eSpark-Backup/ford-creighton-pcb-design-review/README.md

# FordCreighton-PCBDesignReview

We’re preparing to manufacture a high-temp downhole tool and need an experienced PCB engineer to review our design before production.  
 
Board overview:  
10-layer PCB (polyimide, high-temp)  
TI TMS320F28377S (C2000 series) MCU  
PGA900 AFEs, resolver interface, BLDC motor driver  
Mixed analog/digital, high-reliability application  
 
Files provided:  
Altium project files (.SchDoc, .PcbDoc)  
BOM, Pick & Place, Gerbers  
Design notes  
 
What we need:  
Full design & layout review  
Check for DFM/DFT, thermal performance, signal integrity  
Ensure alignment of BOM, footprints, and manufacturing files  
 
Ideal candidate:  
Expert in Altium Designer  
Experience with TI MCUs, high-reliability hardware, and analog front ends  
Bonus: familiarity with PGA900, resolver systems, or downhole electronics  
   
Timeline: 3-5 days
