eSpark-Backup/ford-creighton-pcb-design-review/Client-Files/DROID ITEMS FOR REVIEW/BackUp/DT10965_MOTOR_CONTROLLER/DT10965_MOTOR_CONTROLLER_BD(1).png

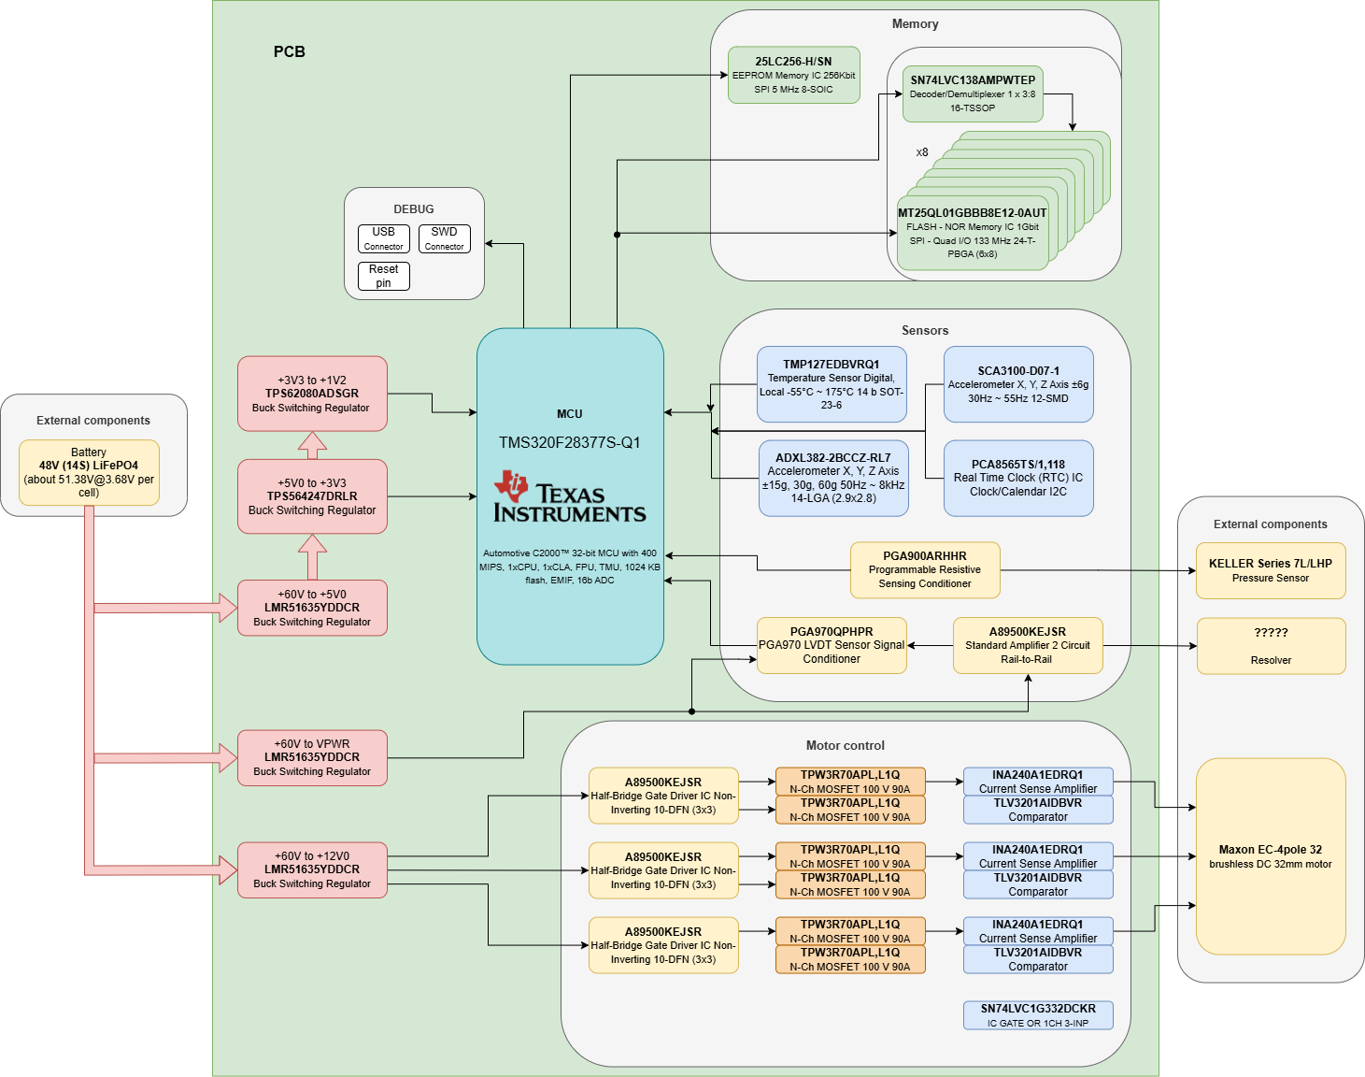
Client-Files/DROID ITEMS FOR REVIEW/BackUp/DT10965_MOTOR_CONTROLLER/DT10965_MOTOR_CONTROLLER_BD(1).png
