eSpark-Backup/ford-creighton-pcb-design-review/Client-Files/DROID ITEMS FOR REVIEW/Altium V1.0/DT10965_MOTOR_CONTROLLER (09.09.2025 11-41-22)/OUTPUTS/BOM/BOM_DT10965.xlsx

Line # | Designator | Description | MPN | Package | Manufacturer | Supplier 1 | Supplier 1 Part Number | Quantity
 | C1, C2 | CAP CER 0402 12PF 50V ULTRA STAB | C0402C120J5HACAUTO | 0402 (1005 Metric) | KEMET |  |  | 2
 | C3, C10, C11, C14, C15, C16, C29, C30, C31, C32, C33, C34, C35, C36, C37, C38, C39, C40, C42, C43, C44, C45, C46, C47, C48, C49, C50, C51, C52, C53, C55, C56, C59, C60, C61, C62, C64, C65, C81, C92, C93, C94, C95, C99, C101, C102, C103, C104, C108, C109, C110, C113, C117, C118, C119, C121, C124, C126, C133, C135, C136, C140, C141, C142, C144, C145, C146, C147, C148, C149, C150, C151, C152, C155, C156, C174, C182, C187, C190, C192, C195, C198, C200, C202, C203, C204, C206, C207, C208, C209, C210, C211, C212, C213, C214, C216, C217, C218, C219, C220, C221, C222, C223, C224, C226, C227, C228, C229, C230, C231, C232, C233, C234, C236, C237, C238, C239, C240, C241 | CAP CER 0.1UF 50V X8L 0402 | GCM155L8EH104KE07D | 0402 (1005 Metric) | Murata Electronics |  |  | 119
 | C4, C5, C6, C7, C96, C100, C105, C111 | CAP CER 2200PF 50V X8R 0402 | CGA2B2X8R1H222K050BA | 0402 (1005 Metric) | TDK Corporation |  |  | 8
 | C8, C9, C12, C13, C17, C18, C19, C20, C21, C22, C23, C24, C25, C41, C188, C189, C199, C201 | CAP CER 2.2UF 6.3V X8L 0603 | C1608X8L0J225K080AC | 0603 (1608 Metric) | TDK Corporation |  |  | 18
 | C26, C27, C28, C58, C154, C181, C191, C193, C194, C196 | CAP CER 10UF 10V X8L 0805 | CGA4J1X8L1A106K125AC | 0805 (2012 Metric) | TDK Corporation |  |  | 10
 | C54, C57, C63, C66, C153 | CAP CER 1UF 16V X8L 0603 | GCG188L8EE105KA07D | 0603 (1608 Metric) | Murata Electronics |  |  | 5
 | C67, C68, C74, C75, C82, C83 | CAP CER 4.7UF 100V X8L 1210 | CL32E475KCIVPJE | 1210 (3225 Metric) | Samsung Electro-Mechanics |  |  | 6
 | C69, C70, C76, C77, C84, C85, C157, C159, C160, C162, C163, C168, C169, C173, C180, C183 | CAP CER 0.1UF 100V X8L 0603 | GCJ188L8EL104KA07D | 0603 (1608 Metric) | Murata Electronics |  |  | 16
 | C71, C72, C78, C79, C86, C87 | CAP CER 0603 100PF 10V ULTRA STA | C0603C101K8HACAUTO | 0603 (1608 Metric) | KEMET |  |  | 6
 | C73, C80, C88 | CAP CER 4.7UF 25V X8L 0805 | CGA4J1X8L1E475K125AC | 0805 (2012 Metric) | TDK Corporation |  |  | 3
 | C89, C90, C97, C106, C116 | CAP CER 0.033UF 50V X8L 0402 | GCM155L8EH333KE07D | 0402 (1005 Metric) | Murata Electronics |  |  | 5
 | C91, C98, C107 | CAP CER 0402 1.5NF 16V ULTRA STA | C0402C152F4HACAUTO | 0402 (1005 Metric) | KEMET |  |  | 3
 | C112, C122, C123, C129, C130, C131, C132, C197, R4, R166, R169, R170, R176, R181, R183, R186, R195, R237, R252, R262, R272 | DNP cap 0402, DNP res 0603 | DNP | 0402 (1005 Metric), 0603 (1608 Metric) |  |  |  | 21
 | C114, C115, C125, C134 | CAP CER 0.47UF 50V X8L 0805 | CGA4J1X8L1H474K125AC | 0805 (2012 Metric) | TDK Corporation |  |  | 4
 | C120, C137 | CAP CER 330PF 16V X8R 0603 | C0603C331J4HACTU | 0603 (1608 Metric) | KEMET |  |  | 2
 | C127, C128, C138, C139 | CAP CER 0.047UF 16V X8R 0402 | CGA2B3X8R1C473K050BB | 0402 (1005 Metric) | TDK Corporation |  |  | 4
 | C143, C205, C215, C225, C235 | CAP CER 0402 560PF 16V ULTRA STA | C0402C561F4HACAUTO | 0402 (1005 Metric) | KEMET |  |  | 5
 | C158, C161, C167, C177, C178, C179, C246, C247, C248, C249 | CAP CER 1UF 100V X8L 1206 | GCJ31CL8EL105KA07L | 1206 (3216 Metric) | Murata Electronics |  |  | 10
 | C164, C165, C166, C170, C171, C172, C175, C176, C184, C185, C186, C250, C251, C252 | CAP CER 22UF 25V X8L 1210 | GCM32EL8EF226KE08L | 1210 (3225 Metric) | Murata Electronics |  |  | 14
 | D1, D2, D3, D4 | DIODE SCHOTTKY 80V 500MA SOD123 | MBR0580S1-7 | SOD-123 | Diodes Incorporated |  |  | 4
 | D5 | DIODE SCHOTTKY 40V 1A DO214AC | SS14-LTP | DO-214AC, SMA | Micro Commercial Co |  |  | 1
 | D6 | TVS DIODE 5.5VWM 12VC SOT363 | D5V0F4U6S-7 | 6-TSSOP, SC-88, SOT-363 | Diodes Incorporated |  |  | 1
 | D7 | DIODE ZENER 10V 300MW SOD323 | MM3Z10VST1G | SC-76, SOD-323 | onsemi |  |  | 1
 | D8 | DIODE ARR SCHOTT 30V TO236AB | BAT54S,215 |  | Nexperia USA Inc. |  |  | 1
 | D9 | LED COOL WHITE DIFFUSED 0402 SMD | APT1608SEC/J3-AMT |  |  |  |  | 1
 | D10 | DIODE ARRAY SCHOTTKY 30V SOT23-3 | BAT54CTA | SOT-23-3 | Diodes Incorporated |  |  | 1
 | FB1, FB2, FB3, FB4, FB5, FB6, FB7, FB8, FB9, FB10, FB11, FB12, FB13, FB14, FB15, FB16, FB17, FB18, FB19 | FERRITE BEAD 220 OHM 0603 1LN | BLM18KG221BH1D | 0603 (1608 Metric) | Murata Electronics |  |  | 19
 | J2, J3, J4, J5, J6, J7 | Connector Header Through Hole 4 position 0.050" (1.27mm) | PR20B04VBNN |  | METZ CONNECT USA Inc. |  |  | 6
 | L1 | CMC 330MA 2LN 90OHM SMD AEC-Q200 | AWCU00201212900M02 |  | Pulse Electronics |  |  | 1
 | L2 | FIXED IND 22UH 1.2A 500 MOHM SMD | SRP4020TA-220M | 2-SMD | Bourns Inc. |  |  | 1
 | L3 | FIXED IND 18UH 1.7A 160 MOHM SMD | SRR4828A-180M |  | Bourns Inc. |  |  | 1
 | L4 | FIXED IND 8.2UH 2A 180 MOHM SMD | SRP4020TA-8R2M | 2-SMD | Bourns Inc. |  |  | 1
 | L5 | FIXED IND 1.5UH 2.3A 74 MOHM SMD | DFE2HCAH1R5MJ0L |  | Murata Electronics |  |  | 1
 | L6 | FIXED IND 1UH 3A 50 MOHM SMD | DFE2HCAH1R0MJ0L | 1008 (2520 Metric) | Murata Electronics |  |  | 1
 | Q1, Q2, Q3, Q4, Q5, Q6 | PB-F POWER MOSFET TRANSISTOR DSO | TPW3R70APL,L1Q |  | Toshiba Semiconductor and Storage |  |  | 6
 | Q7 | MOSFET N-CH 240V 350MA SOT223-4 | BSP129H6327XTSA1 |  | Infineon Technologies |  |  | 1
 | Q8 | MOSFETs P-CHANNEL 80-V (D-S) 175C MOSFET | SQJ185ELP-T1_GE3 |  | Vishay Siliconix |  |  | 1
 | R1, R3, R18, R19, R20, R21, R22, R23, R34, R35, R37, R38, R39, R40, R50, R51, R52, R53, R54, R55, R64, R65, R66, R67, R68, R69, R84, R85, R86, R87, R92, R93, R94, R99, R100, R101, R102, R107, R108, R109, R110, R114, R115, R117, R119, R120, R122, R124, R125, R127, R146, R152, R159, R171, R172, R173, R174, R189, R191, R193, R194, R199, R200, R202, R203, R208, R216, R231, R233, R235, R236, R241, R246, R248, R250, R251, R256, R258, R260, R261, R266, R268, R270, R271, R275, R277, R292, R293, R294 | RES 22 OHM 1% 1/16W 0402 | RC0402FR-0722RL | 0402 (1005 Metric) | YAGEO |  |  | 89
 | R2 | RES 1M OHM 1% 1/16W 0402 | RC0402FR-071ML | 0402 (1005 Metric) | YAGEO |  |  | 1
 | R5, R71, R72, R73, R74, R78, R89, R145, R151, R158, R180, R182, R190, R192, R232, R234, R247, R249, R257, R259, R267, R269 | RES 10K OHM 1% 1/16W 0402 | RC0402FR-0710KL | 0402 (1005 Metric) | YAGEO |  |  | 22
 | R6, R7, R8, R9, R207, R210 | RES SMD 0 OHM JUMPER 1/16W 0402 | RC0402FR-070RL | 0402 (1005 Metric) | YAGEO |  |  | 6
 | R10, R11, R12, R13, R14, R15, R16, R17, R24, R25, R26, R27, R28, R29, R30, R31, R32, R33, R36, R41, R42, R43, R44, R45, R46, R47, R48, R49, R56, R57, R58, R59, R60, R61, R62, R63, R79, R80, R81, R82, R83, R88, R90, R91, R96, R97, R98, R103, R105, R106, R111, R112, R168, R188, R198, R230, R245, R255, R265 | RES 47.5K OHM 1% 1/16W 0402 | RC0402FR-0747K5L | 0402 (1005 Metric) | YAGEO |  |  | 59
 | R70, R75, R76, R77, R116, R118, R121, R123, R126, R128, R134, R135, R136, R143, R144, R147, R154, R155, R157, R160, R163, R175, R187, R201, R229, R239, R240, R242, R244, R254, R264, R286, R287, R288, R290 | RES 0 OHM JUMPER 1/10W 0603 | RC0603FR-070RL | 0603 (1608 Metric) | YAGEO |  |  | 35
 | R95 | RES 5.1 OHM 1% 1/16W 0402 | RC0402FR-075R1L | 0402 (1005 Metric) | YAGEO |  |  | 1
 | R129, R139, R149 | RES 0.02 OHM 1% 3W 2512 | CRA2512-FZ-R020ELF | 2512 (6332 Metric) | Bourns Inc. |  |  | 3
 | R130, R131, R140, R150, R206, R209, R212, R213, R219, R223, R227 | RES 100K OHM 1% 1/16W 0402 | RC0402FR-07100KL | 0402 (1005 Metric) | YAGEO |  |  | 11
 | R132, R133, R142, R153 | RES 4.22K OHM 1% 1/16W 0402 | RC0402FR-074K22L | 0402 (1005 Metric) | YAGEO |  |  | 4
 | R137 | RES 54.9K OHM 1% 1/16W 0402 | RC0402FR-0754K9L | 0402 (1005 Metric) | YAGEO |  |  | 1
 | R138 | RES 274K OHM 1% 1/16W 0402 | RC0402FR-07274KL | 0402 (1005 Metric) | YAGEO |  |  | 1
 | R141, R148, R156 | RES 332K OHM 1% 1/16W 0402 | RC0402FR-07332KL | 0402 (1005 Metric) | YAGEO |  |  | 3
 | R161, R167 | RES 510K OHM 1% 1/16W 0402 | RC0402FR-07510KL | 0402 (1005 Metric) | YAGEO |  |  | 2
 | R162, R164 | RES 31.6K OHM 1% 1/16W 0402 | RC0402FR-0731K6L | 0402 (1005 Metric) | YAGEO |  |  | 2
 | R165, R196, R205, R238, R253, R263, R273, R291 | RES 110 OHM 1% 1/16W 0402 | RC0402FR-07110RL | 0402 (1005 Metric) | YAGEO |  |  | 8
 | R177, R179, R184, R185 | RES 43K OHM 1% 1/16W 0402 | RC0402FR-0743KL | 0402 (1005 Metric) | YAGEO |  |  | 4
 | R204 | RES 49.9K OHM 1% 1/16W 0402 | RC0402FR-0749K9L | 0402 (1005 Metric) | YAGEO |  |  | 1
 | R214 | RES SMD 5.62K OHM 1% 1/10W 0402 | ERJ-2RKF5621X | 0402 (1005 Metric) | Panasonic Electronic Components |  |  | 1
 | R215 | RES SMD 7.15K OHM 1% 1/10W 0402 | ERJ-2RKF7151X | 0402 (1005 Metric) | Panasonic Electronic Components |  |  | 1
 | R218 | RES 135K OHM 1% 1/16W 0402 | RN73H1ETTP1353F50 | 0402 (1005 Metric) | KOA Speer Electronics, Inc. |  |  | 1
 | R220 | RES 30K OHM 1% 1/16W 0402 | RC0402FR-0730KL | 0402 (1005 Metric) | YAGEO |  |  | 1
 | R221 | RES 1.91K OHM 1% 1/16W 0402 | RC0402FR-071K91L | 0402 (1005 Metric) | YAGEO |  |  | 1
 | R222 | RES 178K OHM 1% 1/16W 0402 | RC0402FR-07178KL | 0402 (1005 Metric) | YAGEO |  |  | 1
 | R224, R228 | RES 56 OHM 1% 1/16W 0402 | RC0402FR-0756RL | 0402 (1005 Metric) | YAGEO |  |  | 2
 | R225 | RES 39.2K OHM 1% 1/16W 0402 | RMCF0402FT39K2 | 0402 (1005 Metric) | Stackpole Electronics Inc |  |  | 1
 | R226 | RES 64.9K OHM 1% 1/16W 0402 | RC0402FR-0764K9L | 0402 (1005 Metric) | YAGEO |  |  | 1
 | U1 | IC MCU 32BIT 1MB FLASH 100HTQFP | TMS320F28377SPZPQ |  | Texas Instruments |  |  | 1
 | U2, U3, U4, U5, U7, U8, U9, U10 | IC FLASH 1GBIT SPI 24TPBGA | MT25QL01GBBB8E12-0AUT |  | Micron Technology Inc. |  |  | 8
 | U6 | IC DECODER/DEMUX 1X3:8 16-TSSOP | SN74LVC138AMPWTEP |  | Texas Instruments |  |  | 1
 | U11 | IC EEPROM 256KBIT SPI 5MHZ 8SOIC | 25LC256-H/SN |  | Microchip Technology |  |  | 1
 | U12 | AUTOMOTIVE 0.8C SPI TEMPERATURE | TMP127EDBVRQ1 |  | Texas Instruments |  |  | 1
 | U13 | ACCELEROMETER 6G SPI 12SMD | SCA3100-D07-1 |  | Murata Electronics |  |  | 1
 | U14 | Accelerometer X, Y, Z Axis ±15g, 30g, 60g 50Hz ~ 8kHz 14-LGA (2.9x2.8) | ADXL382-2BCCZ-RL7 |  | Analog Devices Inc. |  |  | 1
 | U15, U16, U18 | IC GATE DRVR HALF-BRIDGE 10DFN | A89500KEJSR |  | Allegro MicroSystems |  |  | 3
 | U17 | IC GATE NOR 1CH 2-INP SC70-5 | SN74LVC1G02DCKR |  | Texas Instruments |  |  | 1
 | U19, U22, U25 | IC CURRENT SENSE 1 CIRCUIT 8SOIC | INA240A1EDRQ1 |  | Texas Instruments |  |  | 3
 | U20 | IC VREF SERIES 0.15% SOT23-3 | REF3333AIDBZR |  | Texas Instruments |  |  | 1
 | U21, U23, U26 | IC COMPARATOR 1 GEN PUR SOT23-5 | TLV3201AIDBVR | SC-74A, SOT-753 | Texas Instruments |  |  | 3
 | U24 | IC GATE OR 1CH 3-INP SC70-6 | SN74LVC1G332DCKR |  | Texas Instruments |  |  | 1
 | U27 | IC OPAMP GP 2 CIRCUIT 14HTSSOP | ALM2403QPWPRQ1 |  | Texas Instruments |  |  | 1
 | U28 | IC SGNL CONDITIONER LVDT 48HTQFP | PGA970QPHPR |  | Texas Instruments |  |  | 1
 | U29, U39, U40, U41, U42 | IC PROG SENSOR SGNL COND 36VQFN | PGA900ARHHR |  | Texas Instruments |  |  | 5
 | U30 | IC RTC CLK/CALENDAR I2C 8TSSOP | PCA8565TS/1,118 |  | NXP USA Inc. |  |  | 1
 | U31, U32, U33 | SIMPLE SWITCHER SYNCHRONOUS BUCK | LMR51635XDDCR |  | Texas Instruments |  |  | 3
 | U34 | IC REG BUCK ADJ 4A SOT563 | TPS564247DRLR |  | Texas Instruments |  |  | 1
 | U35, U38 | CMOS Amplifier 1 Circuit Rail-to-Rail SOT-23-6 | OPA320SAIDBVR |  | Texas Instruments |  |  | 2
 | U36 | IC VREF SERIES SOT23-6 | REF35300QDBVRQ1 |  |  |  |  | 1
 | U37 | IC REG BUCK ADJ 1.2A 8WSON | TPS62080ADSGR |  | Texas Instruments |  |  | 1
 | Y1 | CRYSTAL 20.0000MHZ 8PF SMD | STDCSU2-20M |  | NDK (NIHON DEMPA KOGYO CO., LTD) |  |  | 1
 | Y2 | CRYSTAL 32.7680KHZ 9PF SMD | ABS07AIG-32.768KHZ-9-1-T | 2-SMD, No Lead | Abracon LLC |  |  | 1
