eSpark-Backup/ford-creighton-pcb-design-review/Client-Files/DROID ITEMS FOR REVIEW/Diagrams/PowerCalculation.xlsx

Sheet: Current consumption
LIST | Component | Description | Quantity | Voltage |  | Current (max), mA | Supplied devices current | Common, mA
MCU | TMS320F28377S-Q1 | MCU | 1 | +3V3 | VDDIO | 30 | 0 | 30
MCU | TMS320F28377S-Q1 | MCU | 1 | +3V3 | AVDD | 20 | 0 | 20
MCU | TMS320F28377S-Q1 | MCU | 1 | +3V3 | 3VFL | 40 | 0 | 40
MCU | TMS320F28377S-Q1 | MCU | 1 | +1V2 | VDD | 400 | 0 | 400
Flash | SN74LVC138AMPWTEP | IC DECODER/DEMUX 1X3:8 | 1 | +3V3 |  | 55 | 0 | 55
Flash | MT25QL01GBBB8E12-0AUT | Flash Memory | 8 | +3V3 |  | 1 | 0 | 8
Flash | MT25QL01GBBB8E12-0AUT | Flash Memory | 1 | +3V3 |  | 55 | 0 | 55
EEPROM | 25LC256-H/SN | EEPROM Memory | 1 | +3V3 |  | 5 | 0 | 5
Temp Sensor | TMP127EDBVRQ1 | Temp Sensor | 1 | +3V3 |  | 1 | 0 | 1
Accelerometer | SCA3100-D07-1 | ACCELEROMETER 6G | 1 | +3V3 |  | 5 | 0 | 5
Accelerometer | ADXL382-2BCCZ-RL7 | ACCELEROMETER 60G | 1 | +3V3 |  | 1 | 0 | 1
H-bridge | A89500KEJSR | IC GATE DRVR HALF-BRIDGE | 3 | +3V3 |  | 3 | 0 | 9
H-bridge | A89500KEJSR | IC GATE DRVR HALF-BRIDGE | 3 | +12v |  | 20 | 0 | 60
Phase Current_Voltage Sense | INA240A1EDRQ1 | IC CURRENT SENSE | 3 | +3V3 |  | 3 | 0 | 9
Phase Current_Voltage Sense | REF3333AIDBZR | IC VREF SERIES 0.15% | 1 | +5V0 |  | 35 | 0 | 35
Phase Current_Voltage Sense | TLV3201AIDBVR | IC COMPARATOR | 3 | +3V3 |  | 60 | 0 | 180
Phase Current_Voltage Sense | SN74LVC1G332DCKR | IC GATE OR 1CH 3-INP | 1 | +3V3 |  | 24 | 0 | 24
Resolver | ALM2403QPWPRQ1 | IC OPAMP GP 2 CIRCUIT | 1 | +15V |  | 5.5 | 0 | 5.5
Resolver | PGA970QPHPR | IC SGNL CONDITIONER LVDT | 1 | +15V |  | 12.5 | 0 | 12.5
Pressure_sensor_AFE | PGA900ARHHR | IC PROG SENSOR SGNL COND | 5 | +5V0 |  | 2.6 | 0 | 13
CALENDAR | PCA8565TS/1,118 | IC RTC CLK/CALENDAR | 1 | +3V3 |  | 1 | 0 | 1
 |  |  |  |  |  |  | Voltage | Max. Current consumption
 |  |  |  |  |  |  | +1V2 | up to 400mA
 |  |  |  |  |  |  | +3V3 | up to 650mA
 |  |  |  |  |  |  | +5V0 | up to 50mA
 |  |  |  |  |  |  | +12V | up to 60mA
 |  |  |  |  |  |  | +15V | up to 20mA

Sheet: Аркуш2
LIST | Component | Description | Quantity | Voltage |  | Current (max), mA | Supplied devices current | Common
MCU | TMS320F28377S-Q1 | MCU | 1 | +3V3 | VDDIO | 30 | 0 | 30
MCU | TMS320F28377S-Q1 | MCU | 1 | +3V3 | AVDD | 20 | 0 | 20
MCU | TMS320F28377S-Q1 | MCU | 1 | +3V3 | 3VFL | 40 | 0 | 40
MCU | TMS320F28377S-Q1 | MCU | 1 | +1V2 | VDD | 400 | 0 | 400
Flash | SN74LVC138AMPWTEP | IC DECODER/DEMUX 1X3:8 | 1 | +3V3 |  | 55 | 0 | 55
Flash | MT25QL01GBBB8E12-0AUT | Flash Memory | 8 | +3V3 |  | 1 | 0 | 8
Flash | MT25QL01GBBB8E12-0AUT | Flash Memory | 1 | +3V3 |  | 55 | 0 | 55
EEPROM | 25LC256-H/SN | EEPROM Memory | 1 | +3V3 |  | 5 | 0 | 5
Temp Sensor | TMP127EDBVRQ1 | Temp Sensor | 1 | +3V3 |  | 1 | 0 | 1
Accelerometer | SCA3100-D07-1 | ACCELEROMETER 6G | 1 | +3V3 |  | 5 | 0 | 5
Accelerometer | ADXL382-2BCCZ-RL7 | ACCELEROMETER 60G | 1 | +3V3 |  | 1 | 0 | 1
H-bridge | A89500KEJSR | IC GATE DRVR HALF-BRIDGE | 3 | +3V3 |  | 3 | 0 | 9
Phase Current_Voltage Sense | INA240A1EDRQ1 | IC CURRENT SENSE | 3 | +3V3 |  | 3 | 0 | 9
Phase Current_Voltage Sense | TLV3201AIDBVR | IC COMPARATOR | 3 | +3V3 |  | 60 | 0 | 180
Phase Current_Voltage Sense | SN74LVC1G332DCKR | IC GATE OR 1CH 3-INP | 1 | +3V3 |  | 24 | 0 | 24
CALENDAR | PCA8565TS/1,118 | IC RTC CLK/CALENDAR | 1 | +3V3 |  | 1 | 0 | 1
 |  |  |  |  |  |  |  | 843

Sheet: SPI-Speed
 | Type | IC connection | Maximum SPI Working Frequency | SPI Port# | SPI CS PIN
 | MCU | TMS320F28377S-Q1 | 3 high-speed SPI- UP to 50 MHz | SPI A/B/C | Port Name | I/O
x8 | Flash | MT25QL01GBBB8E12-0AUT | 90/27 (fC/fR)- Clock frequency | SPI C | SPI_C_EN | GPIO72(+73,78,86)
 | EEPROM | 25LC256-H/SN | 3 MHz (at +3,3V) | SPI B | SPI_EEPROM_CS | GPIO2
 | TempSens | TMP127EDBVRQ1 | 10 MHz (Max) | SPI A | SPI_TEMP_\C\S\ | GPIO86
 | Accelerometer | SCA3100-D07-1 | 8 MHz (MAX) | SPI A | SPI_A_EN | GPIO19
x1 | Resolver AFE | PGA970QPHPR | 1 MHz (MAX) | SPI B | PGA970_SPI_CSN | GPIO66
x5 | Pressure sensor AFE1 | PGA900ARHHR | 1 MHz (MAX) | SPI B | PS_EN_1 | GPIO59
 | Pressure sensor AFE2 | PGA900ARHHR | 1 MHz (MAX) | SPI B | PS_EN_2 | GPIO62
 | Pressure sensor AFE3 | PGA900ARHHR | 1 MHz (MAX) | SPI B | PS_EN_3 | GPIO63
 | Pressure sensor AFE4 | PGA900ARHHR | 1 MHz (MAX) | SPI B | PS_EN_4 | GPIO64
 | Pressure sensor AFE5 | PGA900ARHHR | 1 MHz (MAX) | SPI B | PS_EN_5 | GPIO65

Sheet: Connector
Battery connection |  |  |  |  | Motor connection
AWG 20 wires |  |  |  |  | AWG 20 wires
Contact # | Color | Signal | External equipment | PCB connection | Contact # | Color | Signal | External equipment | PCB connection
1 | Black | GND | Battery | X32 | 1 | Black | n.a. | n.a. | n.a
2 | Brown | n.a. | n.a. | n.a. | 2 | Brown | Winding 1 | Motor | X33.
3 | Red | Vin | Battery | X31 | 3 | Red | n.a. | n.a. | n.a.
4 | Orange | n.a. | n.a. | n.a. | 4 | Orange | Winding 2 | Motor | X34
5 | Yellow | n.a. | n.a. | n.a. | 5 | Yellow | Winding 3 | Motor | X35
AWG 26 wires |  |  |  |  | AWG 26 wires
Contact # | Color | Signal | External equipment | PCB connection | Contact # | Color | Signal | External equipment | PCB connection
6 | Black | VBRGP1 | Pressure sensor1 | X11 | 6 | Black | P1OUT | Resolver | X1
7 | Brown | VBRGN1 | Pressure sensor1 | X12 | 7 | Brown | P2OUT | Resolver | X2
8 | Red | VINPP1 | Pressure sensor1 | X13 | 8 | Red | S1P_IN | Resolver | X3
9 | Orange | VINPN1 | Pressure sensor1 | X14 | 9 | Orange | S1N_IN | Resolver | X4
10 | Yellow | VBRGP2 | Pressure sensor2 | X15 | 10 | Yellow | S2P_IN | Resolver | X5
11 | Green | VBRGN2 | Pressure sensor2 | X16 | 11 | Green | S2N_IN | Resolver | X6
12 | Blue | VINPP2 | Pressure sensor2 | X17 | 12 | Blue | n.a. | n.a. | n.a.
13 | Violet | VINPN2 | Pressure sensor2 | X18 | 13 | Violet | n.a. | n.a. | n.a.
14 | Gray | VBRGP3 | Pressure sensor3 | X19 | 14 | Gray | n.a. | n.a. | n.a.
15 | White | VBRGN3 | Pressure sensor3 | X20 | 15 | White | n.a. | n.a. | n.a.
16 | Black | VINPP3 | Pressure sensor3 | X21 | 16 | Black | USB_GND | USB | X10
17 | Brown | VINPN3 | Pressure sensor3 | X22 | 17 | Brown | n.a. | n.a. | n.a.
18 | Red | VBRGP4 | Pressure sensor4 | X23 | 18 | Red | VBUS | USB | X9
19 | Orange | VBRGN4 | Pressure sensor4 | X24 | 19 | Orange | USB_CON_D_P | USB | X7
20 | Yellow | VINPP4 | Pressure sensor4 | X25 | 20 | Yellow | USB_CON_D_N | USB | X8
21 | Green | VINPN4 | Pressure sensor4 | X26 | 21 | Green | n.a. | n.a. | n.a.
22 | Blue | VBRGP5 | Pressure sensor5 | X27 | 22 | Blue | n.a. | n.a. | n.a.
23 | Violet | VBRGN5 | Pressure sensor5 | X28 | 23 | Violet | n.a. | n.a. | n.a.
24 | Gray | VINPP5 | Pressure sensor5 | X29 | 24 | Gray | n.a. | n.a. | n.a.
25 | White | VINPN5 | Pressure sensor5 | X30 | 25 | White | n.a. | n.a. | n.a.
