eSpark-Backup/ford-creighton-pcb-design-review/Client-Files/DROID ITEMS FOR REVIEW/Diagrams/GND__Connection.drawio.pdf

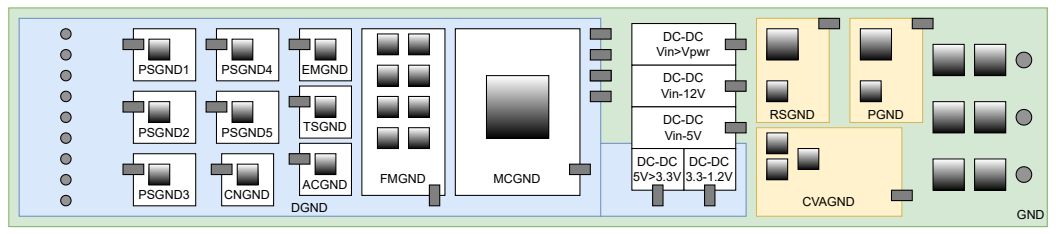
[picture p2: page 1]
GND; PGND; DGND; FMGND; MCGND; EMGND; TSGND; ACGND; CVAGND; PSGND1; PSGND2; PSGND3; PSGND4; PSGND5; CNGND; RSGND

DC-DC Vin>Vpwr

DC-DC Vin-12V

DC-DC Vin-5V
