eSpark-Backup/ford-creighton-pcb-design-review/Client-Files/DROID ITEMS FOR REVIEW/BackUp/DT10965_MOTOR_CONTROLLER/DT10965_MOTOR_CONTROLLER.pdf

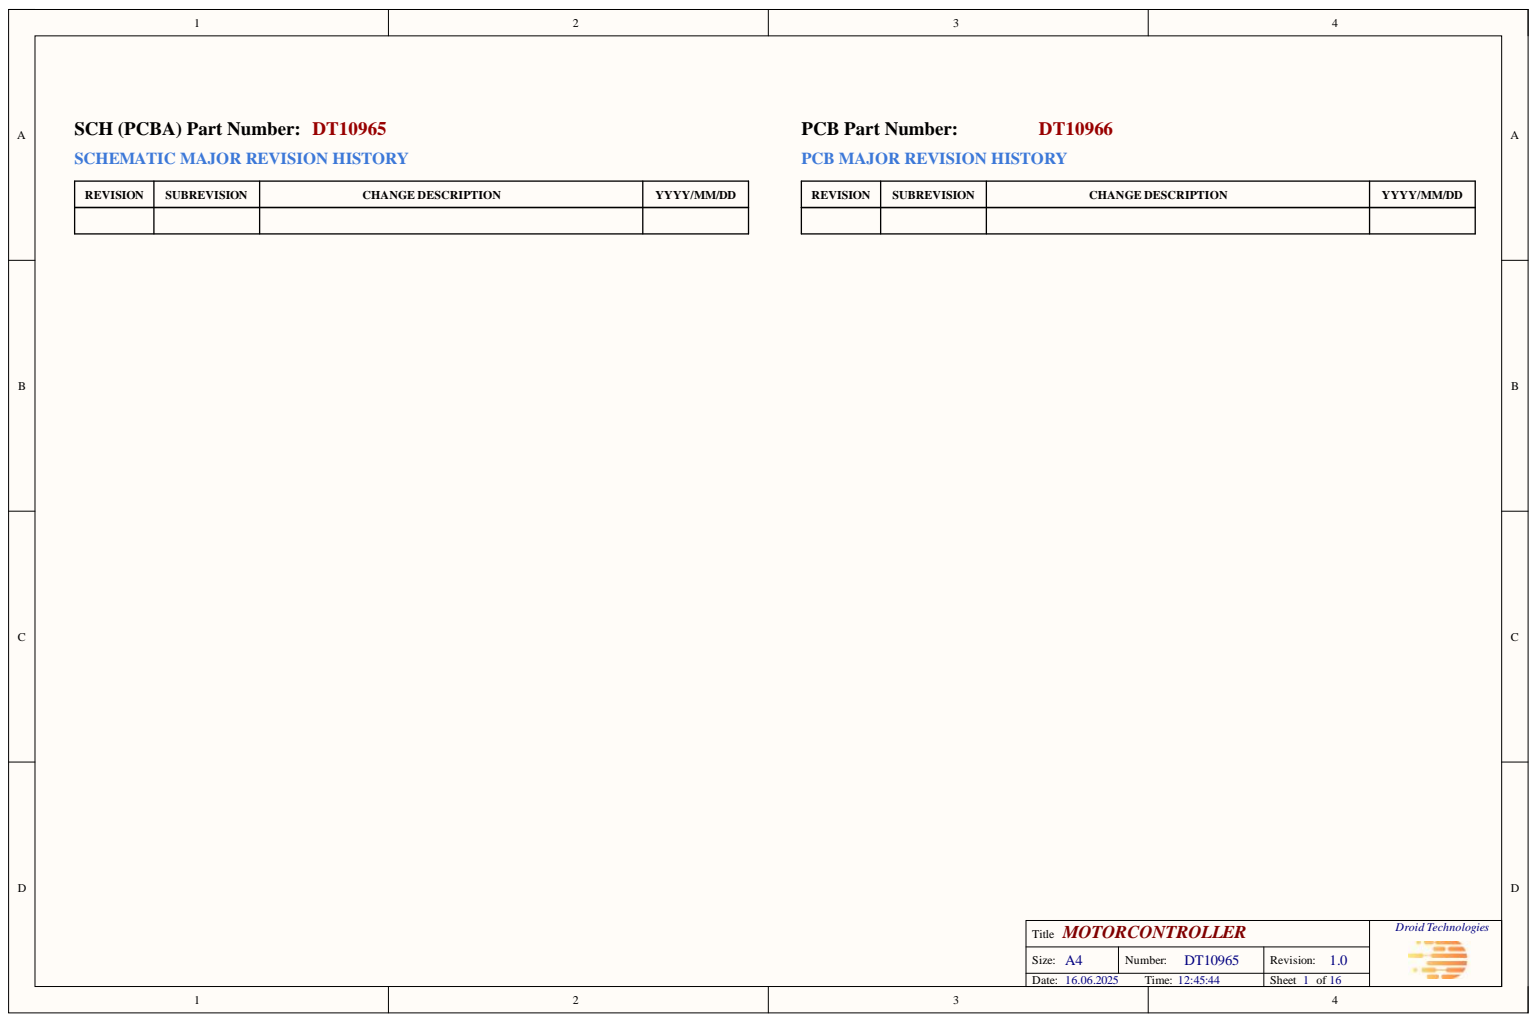
[picture p3: page 1]

MOTORCONTROLLER Title | Droid Technologies

Size: A4 | Number: DT10965 | Revision: 1.0
Date: 16.06.2025 Time: 12:45:44 | | Sheet of

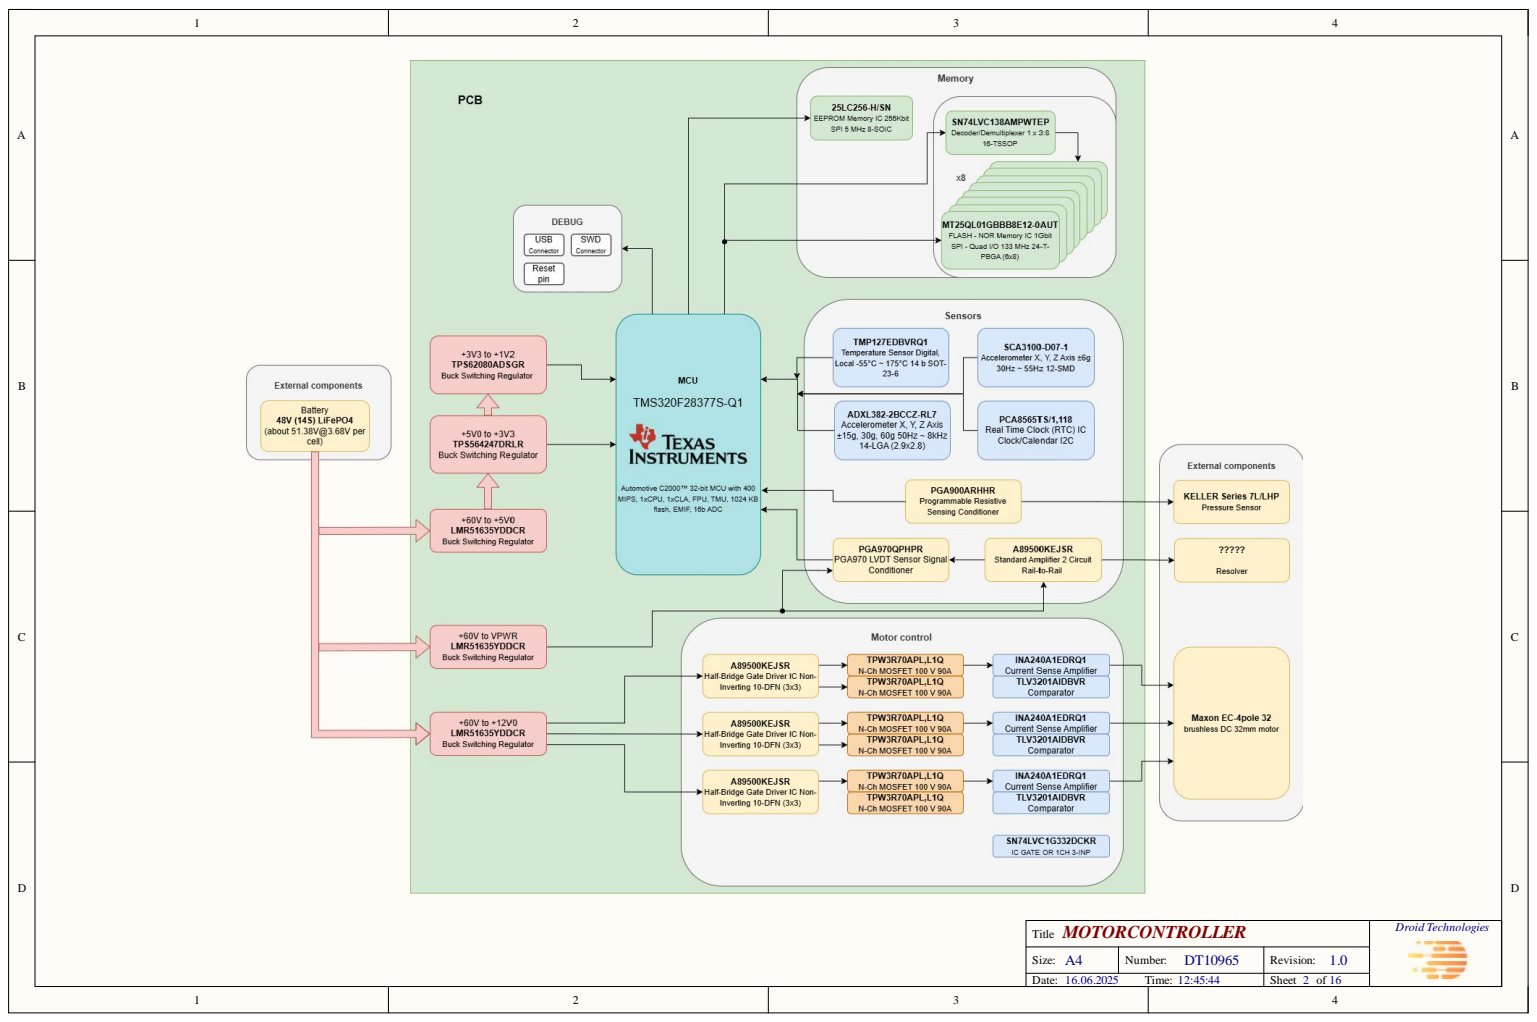
[picture p4: page 2]

MOTORCONTROLLER Title | Droid Technologies

Size: A4 | Number: DT10965 | Revision: 1.0

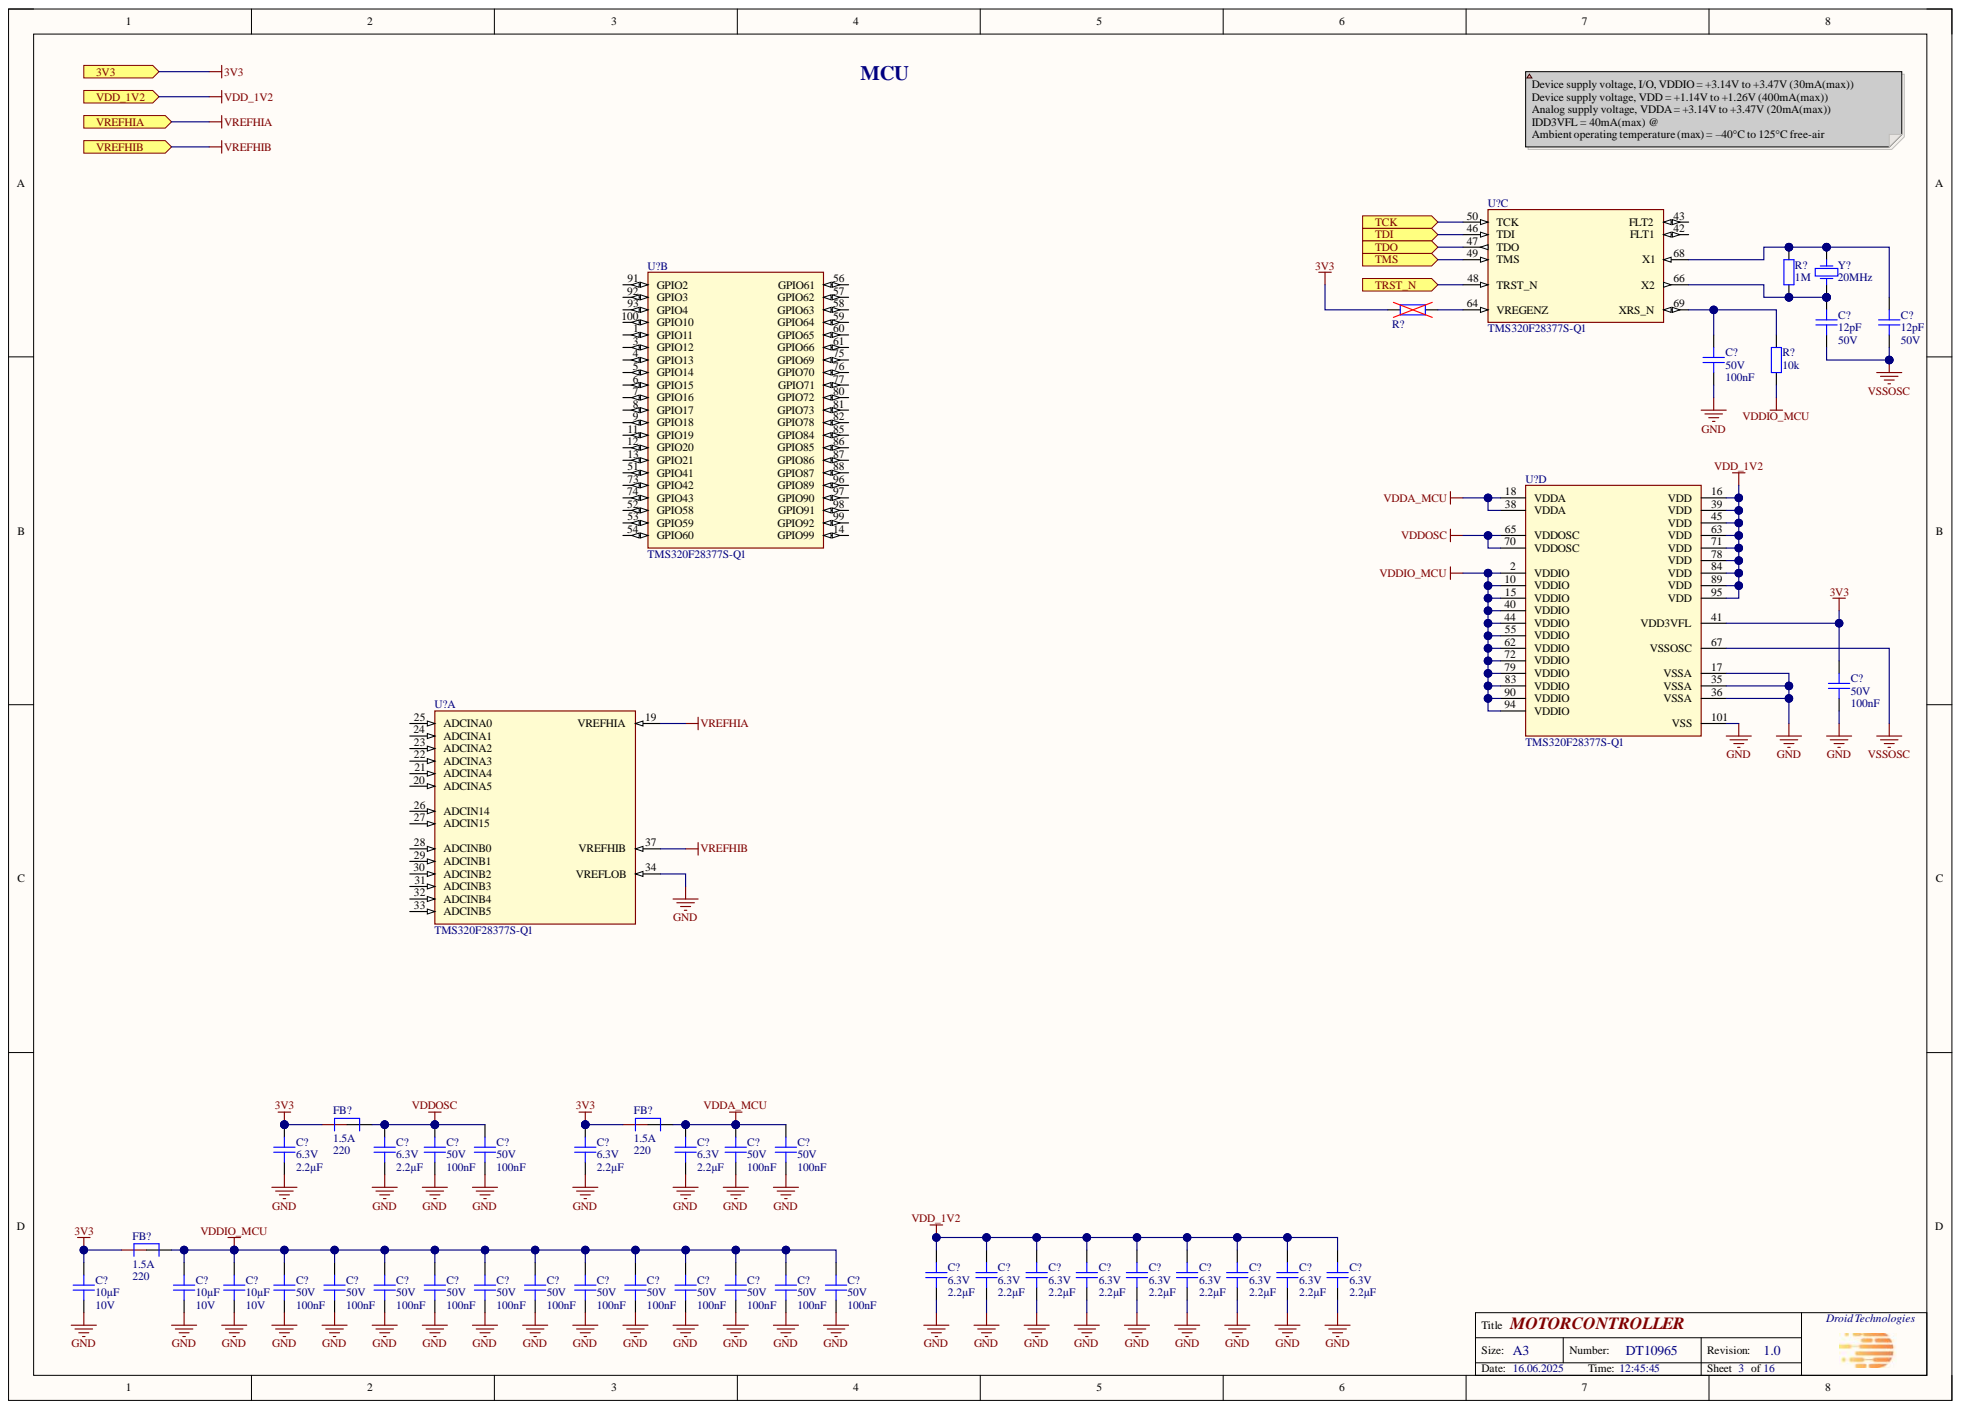
[picture p5: page 3]

Device supply voltage, I/O, VDDIO = +3.14V to +3.47V (30mA(max))
Device supply voltage, VDD = +1.14V to +1.26V (400mA(max))
Analog supply voltage, VDDA= +3.14V to +3.47V (20mA(max))
IDD3VFL = 40mA(max) @
Ambient operating temperature (max) = –40°C to 125°C free-air

MOTORCONTROLLER Title | Droid Technologies

Size: A3 | Number: DT10965 | Revision: 1.0

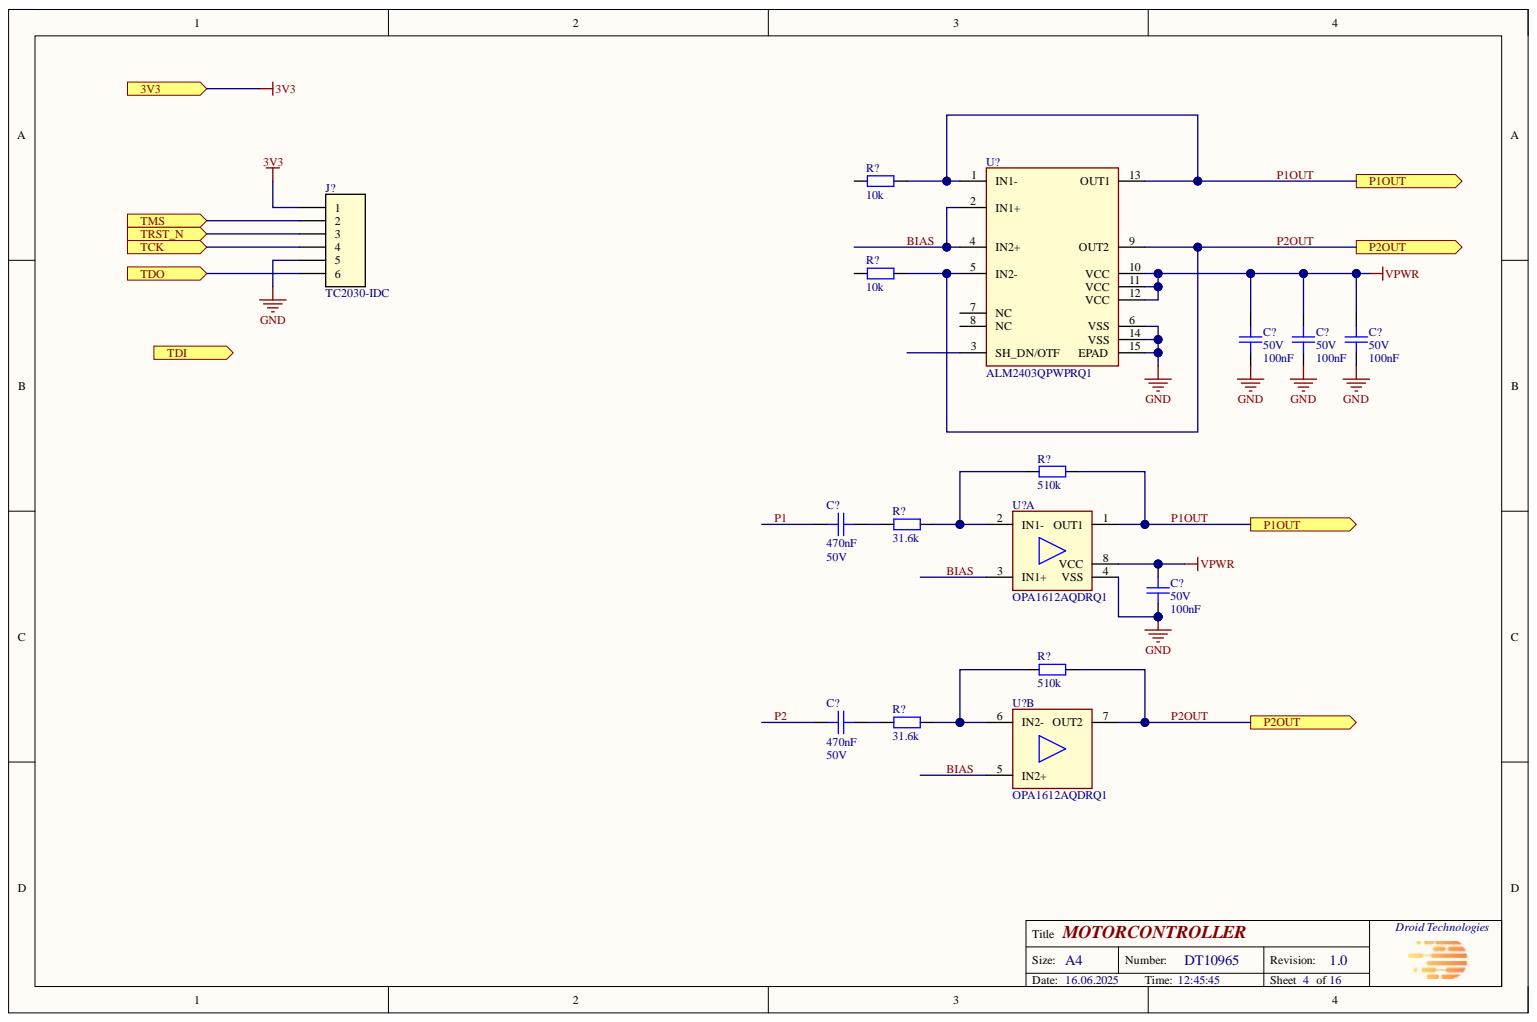
[picture p6: page 4]

MOTORCONTROLLER Title | Droid Technologies

Size: A4 | Number: DT10965 | Revision: 1.0

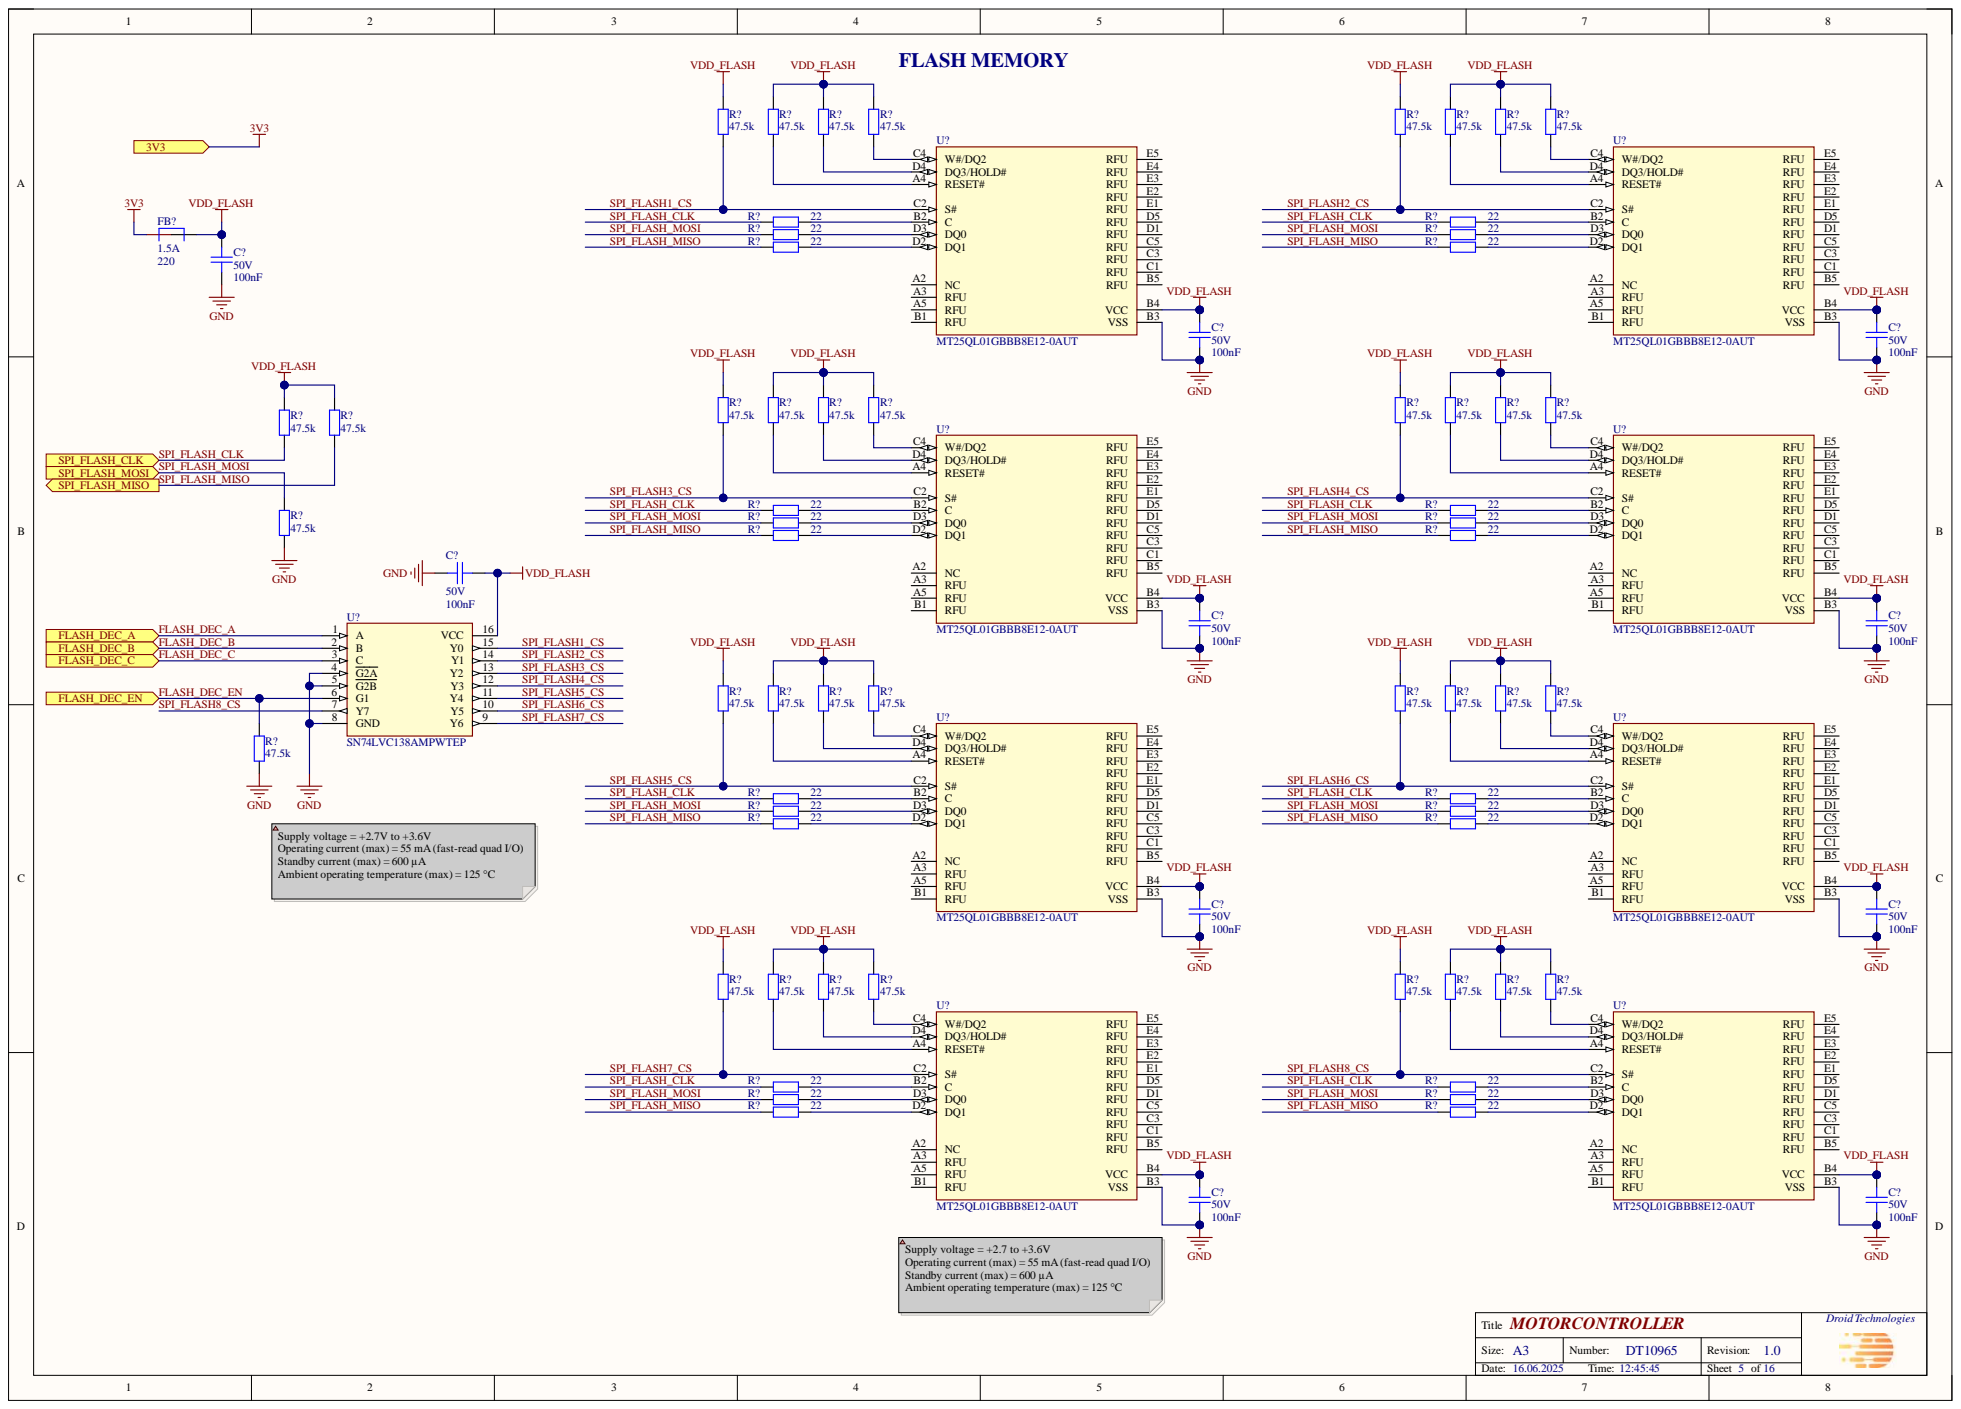
[picture p7: page 5]

M O TORCO N TRO LLER Ti t l e | D roid Technologies

Size : A | Number : D T1096 5 | Revi s i on : 1.0
Dat e : 16.06.202 5 Ti m e : 12:45: | | Shee t of

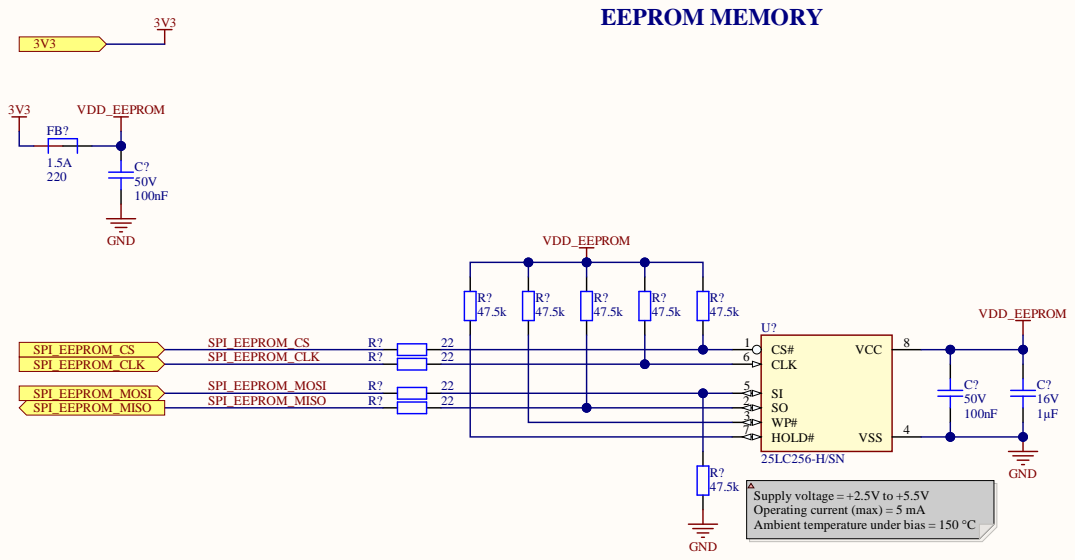
[picture p8: page 6]

CLK 6

HOLD# 7

Supply voltage = +2.5V to +5.5V
Operating current (max) = 5 mA
Ambient temperature under bias = 150 °C

MOTORCONTROLLER Title | Droid Technologies

Size: A4 | Number: DT10965 | Revision: 1.0

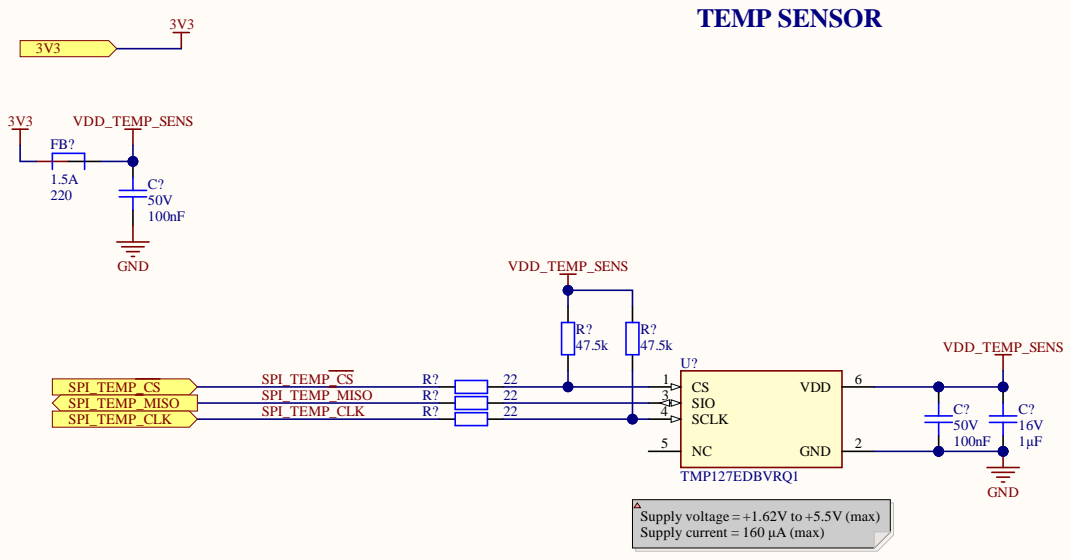
[picture p9: page 7]

SIO 3
SCLK 4

Supply voltage = +1.62V to +5.5V (max)
Supply current = 160 μA (max)

MOTORCONTROLLER Title | Droid Technologies

Size: A4 | Number: DT10965 | Revision: 1.0

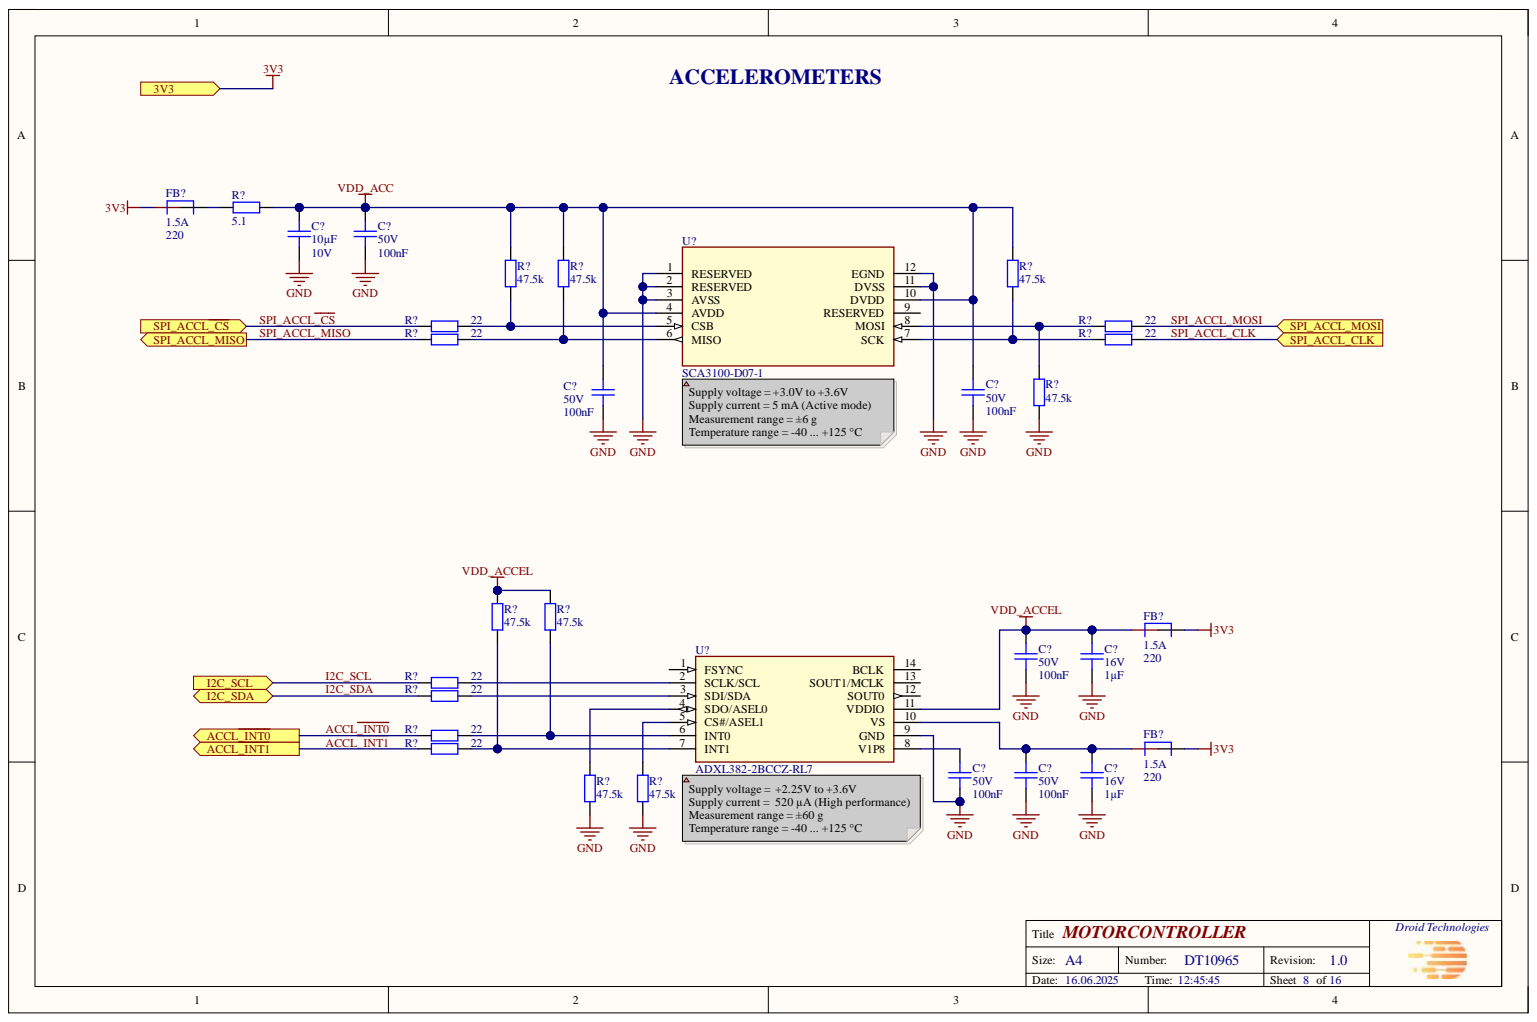
[picture p10: page 8]

RESERVED 2

AVDD 4
CSB 5

SCA3100-D07-1
Supply voltage = +3.0V to +3.6V
Supply current = 5 mA (Active mode)
Measurement range = ±6 g
Temperature range = -40 ... +125 °C

SDI/SDA 3
SDO/ASEL0 4
CS#/ASEL1 5
INT0 6

ADXL382-2BCCZ-RL7
Supply voltage = +2.25V to +3.6V
Supply current = 520 µA (High performance)
Measurement range = ±60 g

MOTORCONTROLLER Title | Droid Technologies

Size: A4 | Number: DT10965 | Revision: 1.0

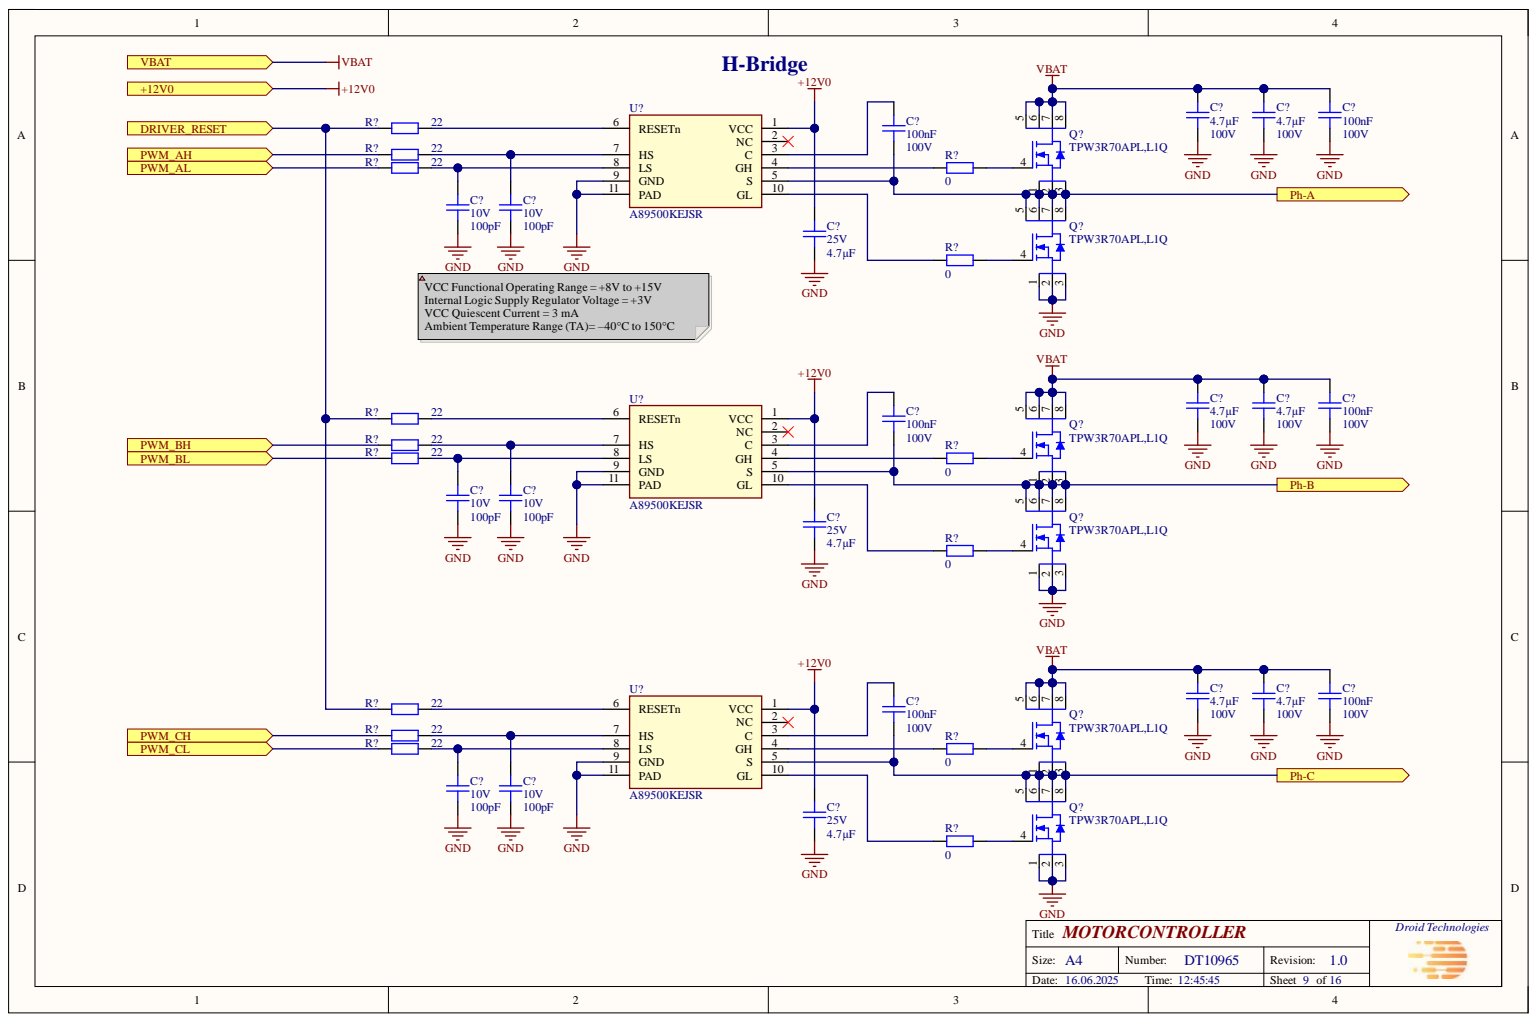
[picture p11: page 9]

1 1

MOTORCONTROLLER T i tl e | D ro i d Tech n o l o g i e s

Size : A 4 | N umb er : DT1 0 9 6 5 | Rev i s i o n : 1 . 0
Dat e : 6.0 . T ime : : : | | Shee t o f

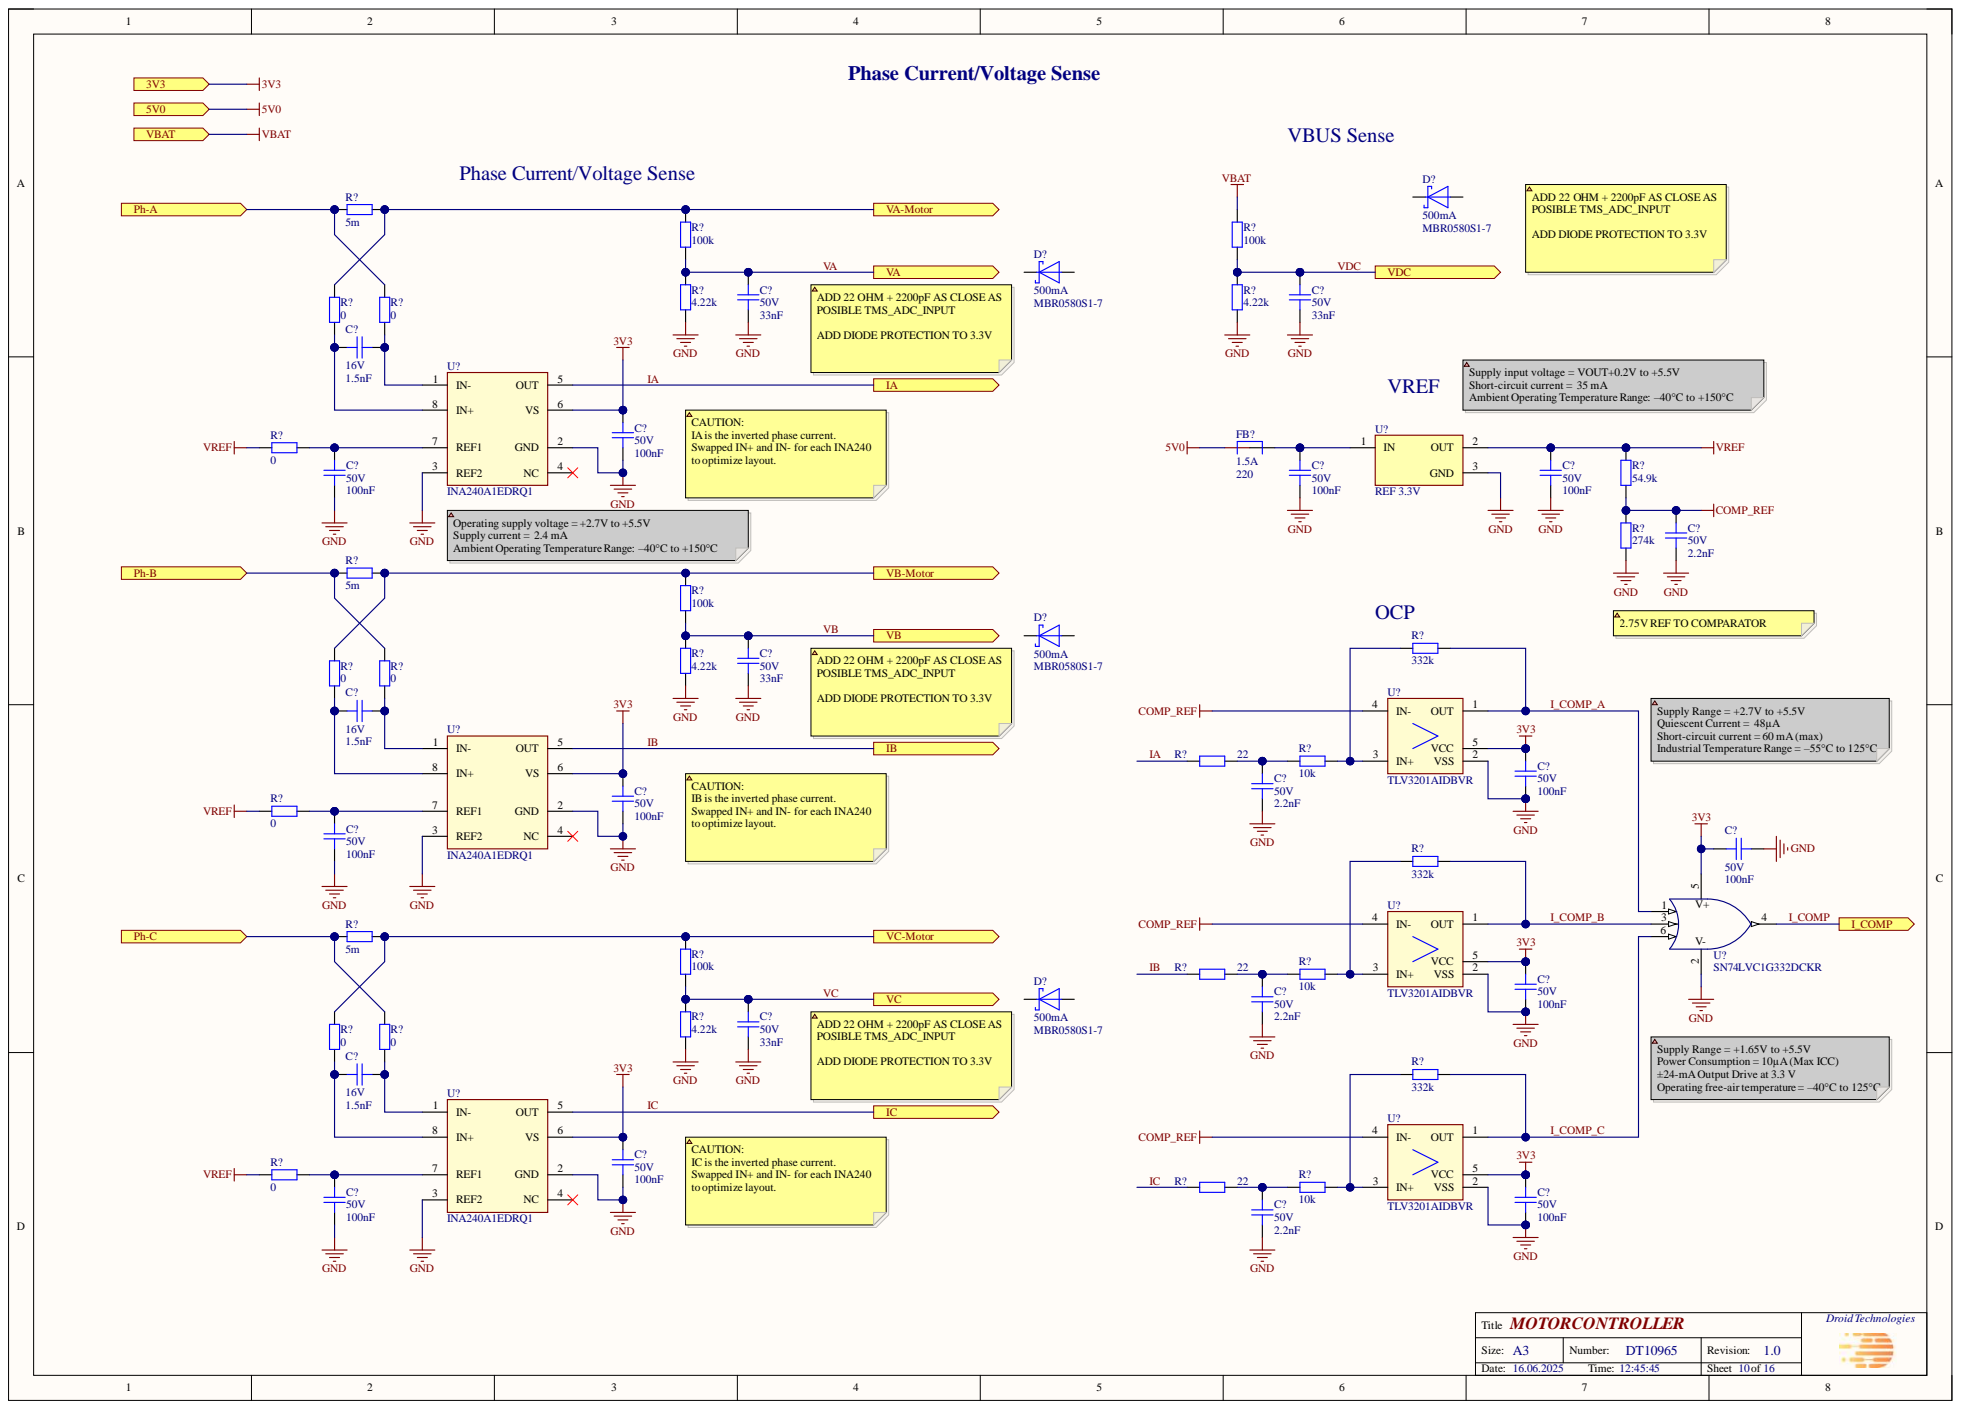
[picture p12: page 10]

Phase Current/Voltage Sense

ADD 22 OHM + 2200pF AS CLOSE AS
POSIBLE TMS_ADC_INPUT

ADD DIODE PROTECTION TO 3.3V

Supply input voltage = VOUT+0.2V to +5.5V
Short-circuit current = 35 mA
Ambient Operating Temperature Range: –40°C to +150°C

CAUTION:
IAis the inverted phase current.
Swapped IN+ and IN- for each INA240
to optimize layout.

Operating supply voltage = +2.7V to +5.5V
Supply current = 2.4 mA

Supply Range = +2.7V to +5.5V
Quiescent Current = 48µA
Short-circuit current = 60 mA(max)
Industrial Temperature Range = –55°C to 125°C

IB is the inverted phase current.

Supply Range = +1.65V to +5.5V
Power Consumption = 10µA(Max ICC)
±24-mAOutput Drive at 3.3 V
Operating free-air temperature = –40°C to 125°C

IC is the inverted phase current.

MOTORCONTROLLER Title | Droid Technologies

Size: A3 | Number: DT10965 | Revision: 1.0

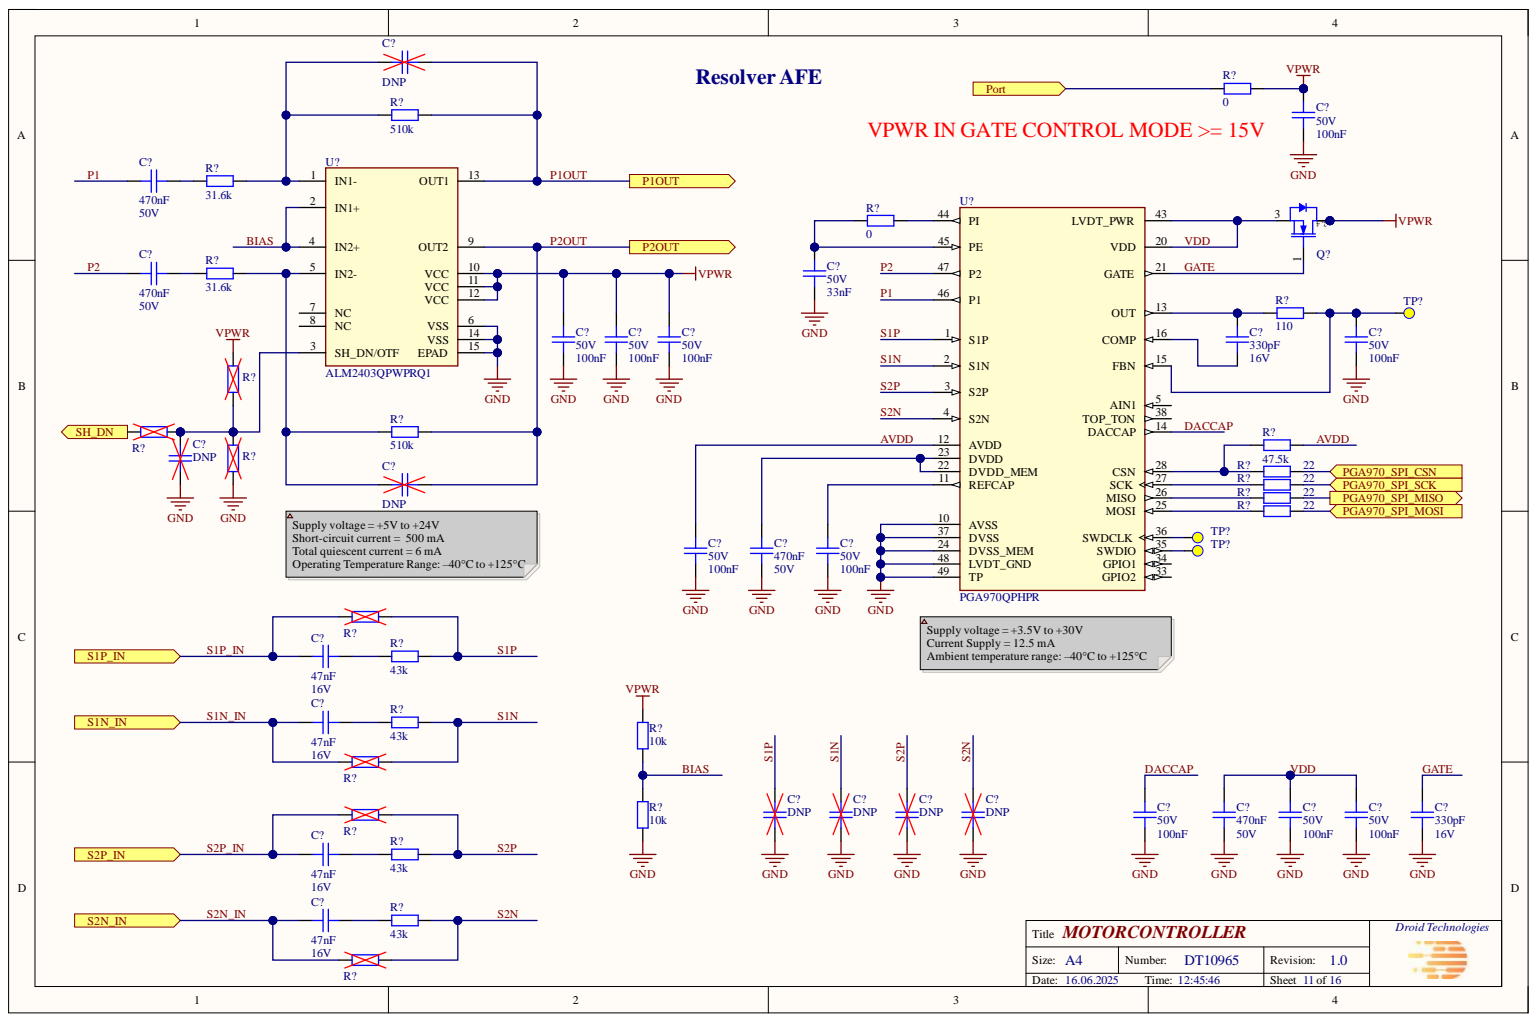
[picture p13: page 11]

VPWR IN GATE CONTROL MODE >= 15V

PE 45 | VDD

DVDD 23
DVDD_MEM 22
REFCAP 11

DVSS 37 AVSS 10

Supply voltage = +5V to +24V
Short-circuit current = 500 mA
Total quiescent current = 6 mA
Operating Temperature Range: –40°C to +125°C

Supply voltage = +3.5V to +30V
Current Supply = 12.5 mA
Ambient temperature range: –40°C to +125°C

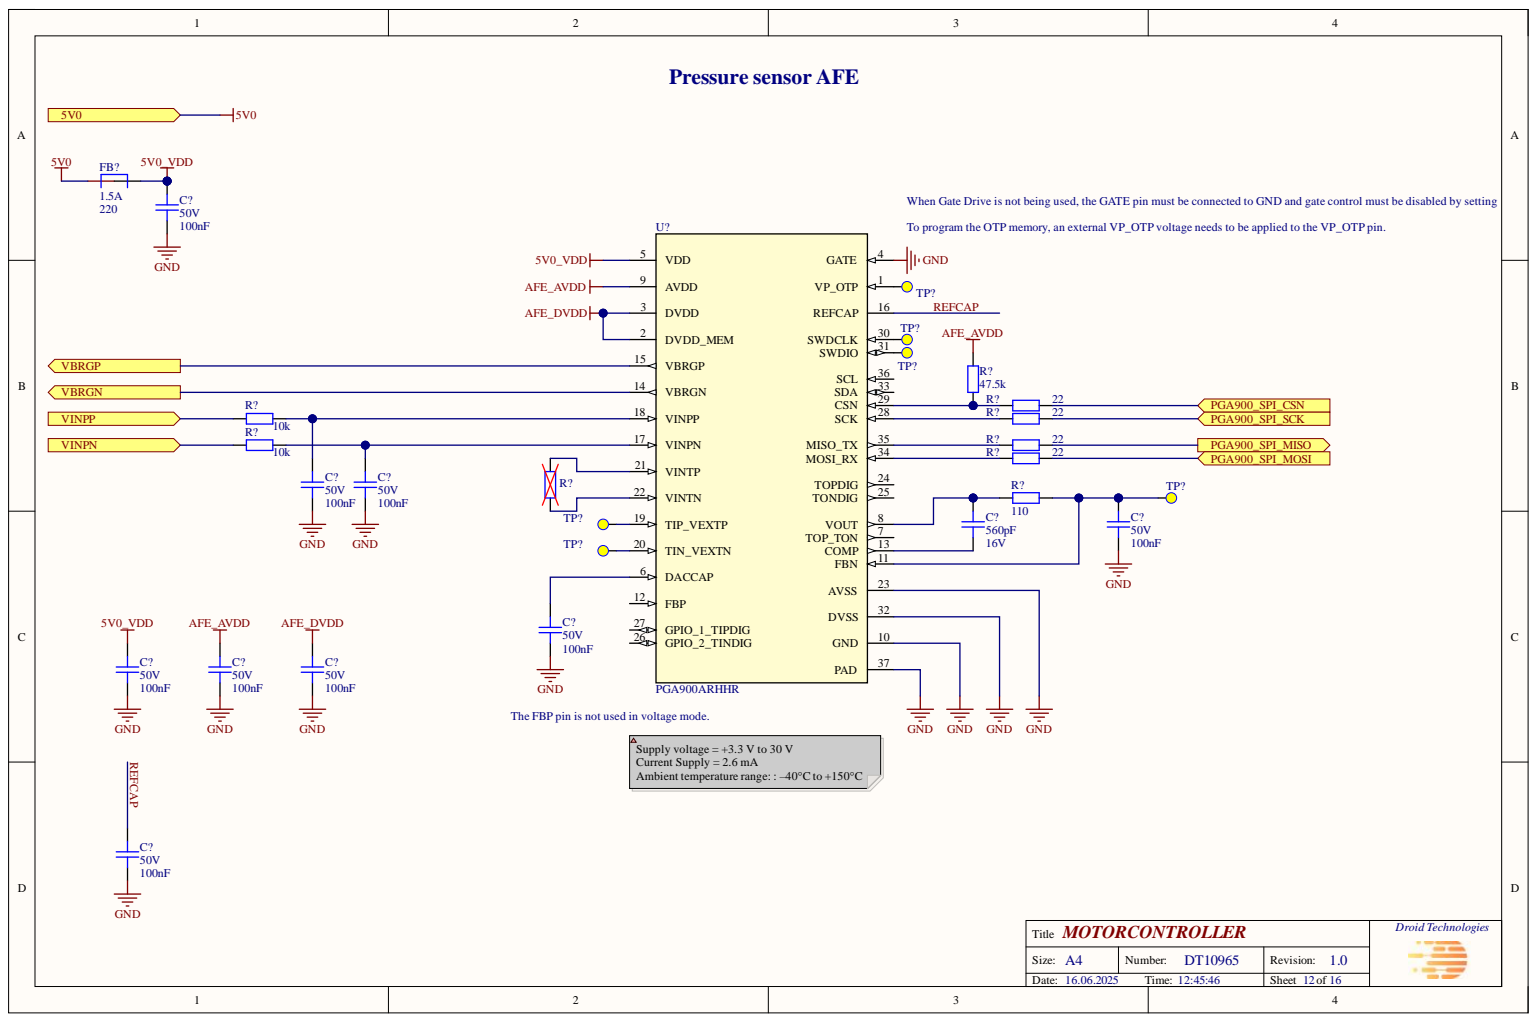
[picture p14: page 12]

When Gate Drive is not being used, the GATE pin must be connected to GND and gate control must be disabled by setting

To program the OTP memory, an external VP_OTP voltage needs to be applied to the VP_OTP pin.

VINPN 17

VINTP 21

R? | VINTN 22

The FBP pin is not used in voltage mode.

Supply voltage = +3.3 V to 30 V
Current Supply = 2.6 mA
Ambient temperature range: : –40°C to +150°C

MOTORCONTROLLER Title | Droid Technologies

Size: A4 | Number: DT10965 | Revision: 1.0

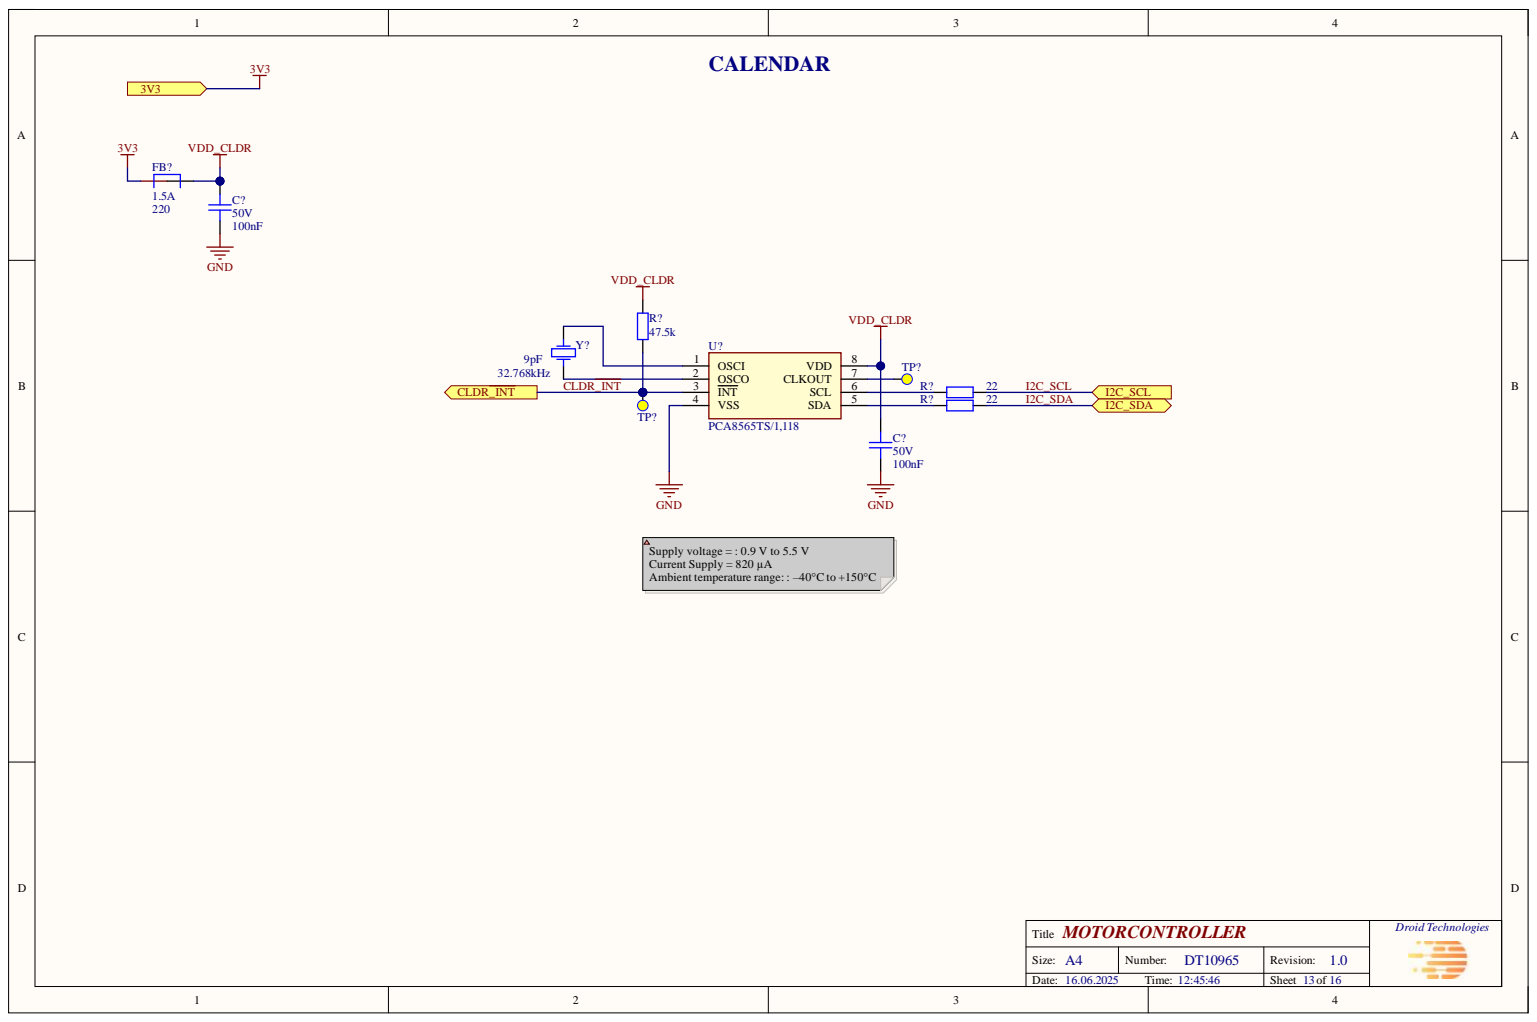
[picture p15: page 13]

Supply voltage = : 0.9 V to 5.5 V
Current Supply = 820 µA
Ambient temperature range: : –40°C to +150°C

MOTORCONTROLLER Title | Droid Technologies

Size: A4 | Number: DT10965 | Revision: 1.0

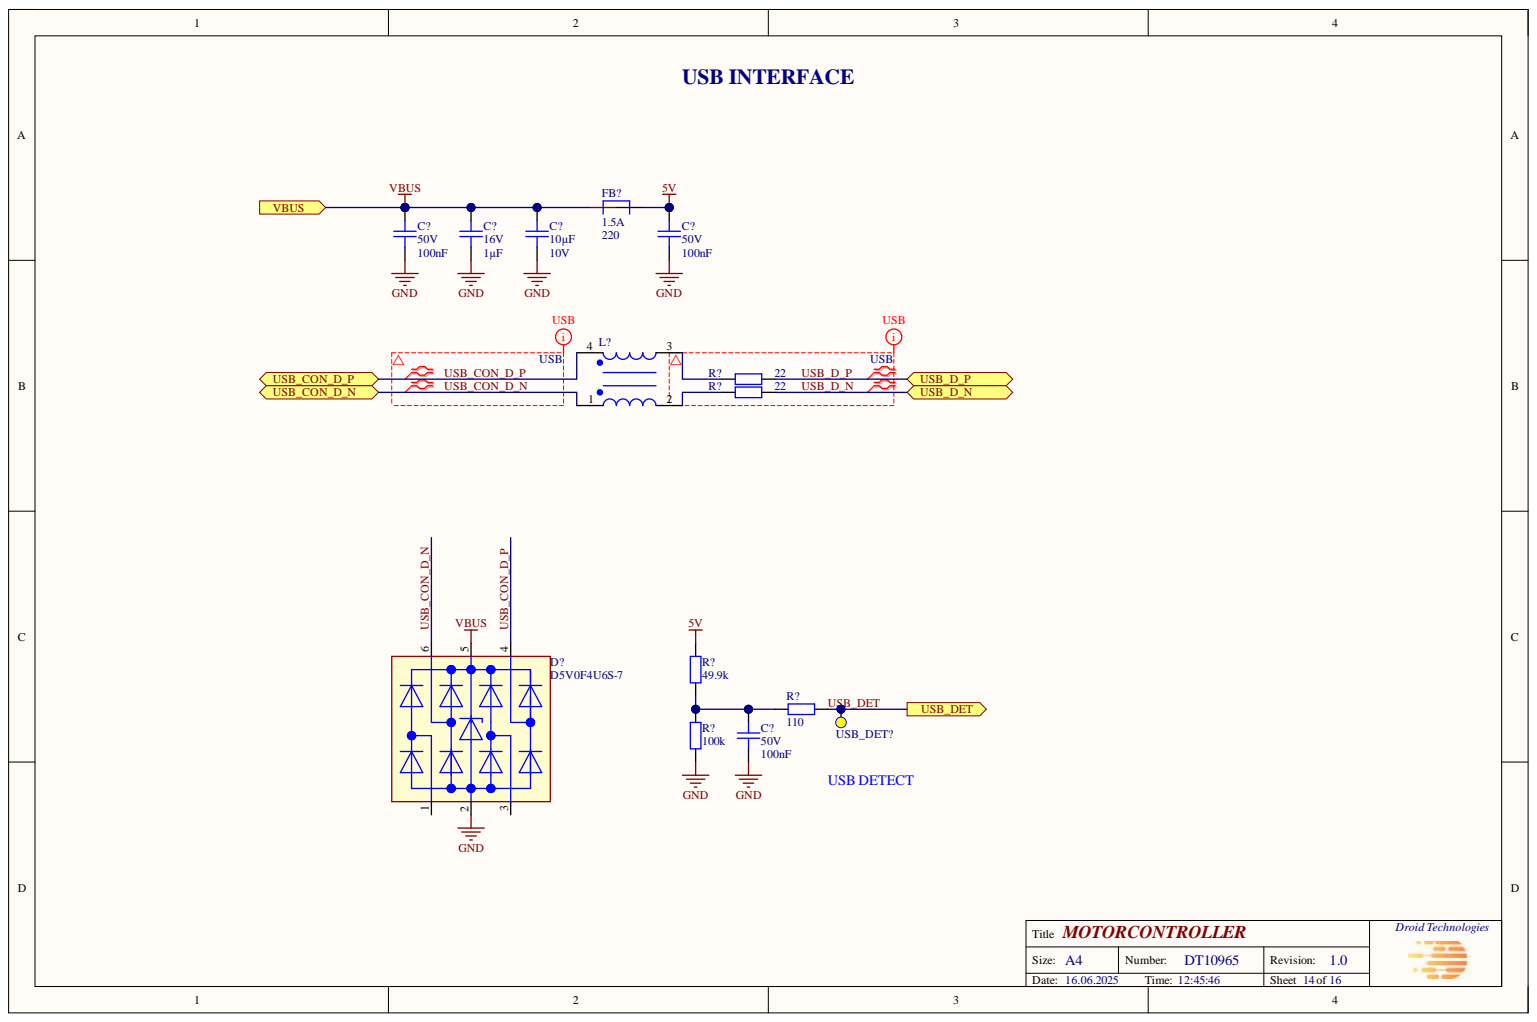
[picture p16: page 14]

MOTORCONTROLLER Title | Droid Technologies

Size: A4 | Number: DT10965 | Revision: 1.0

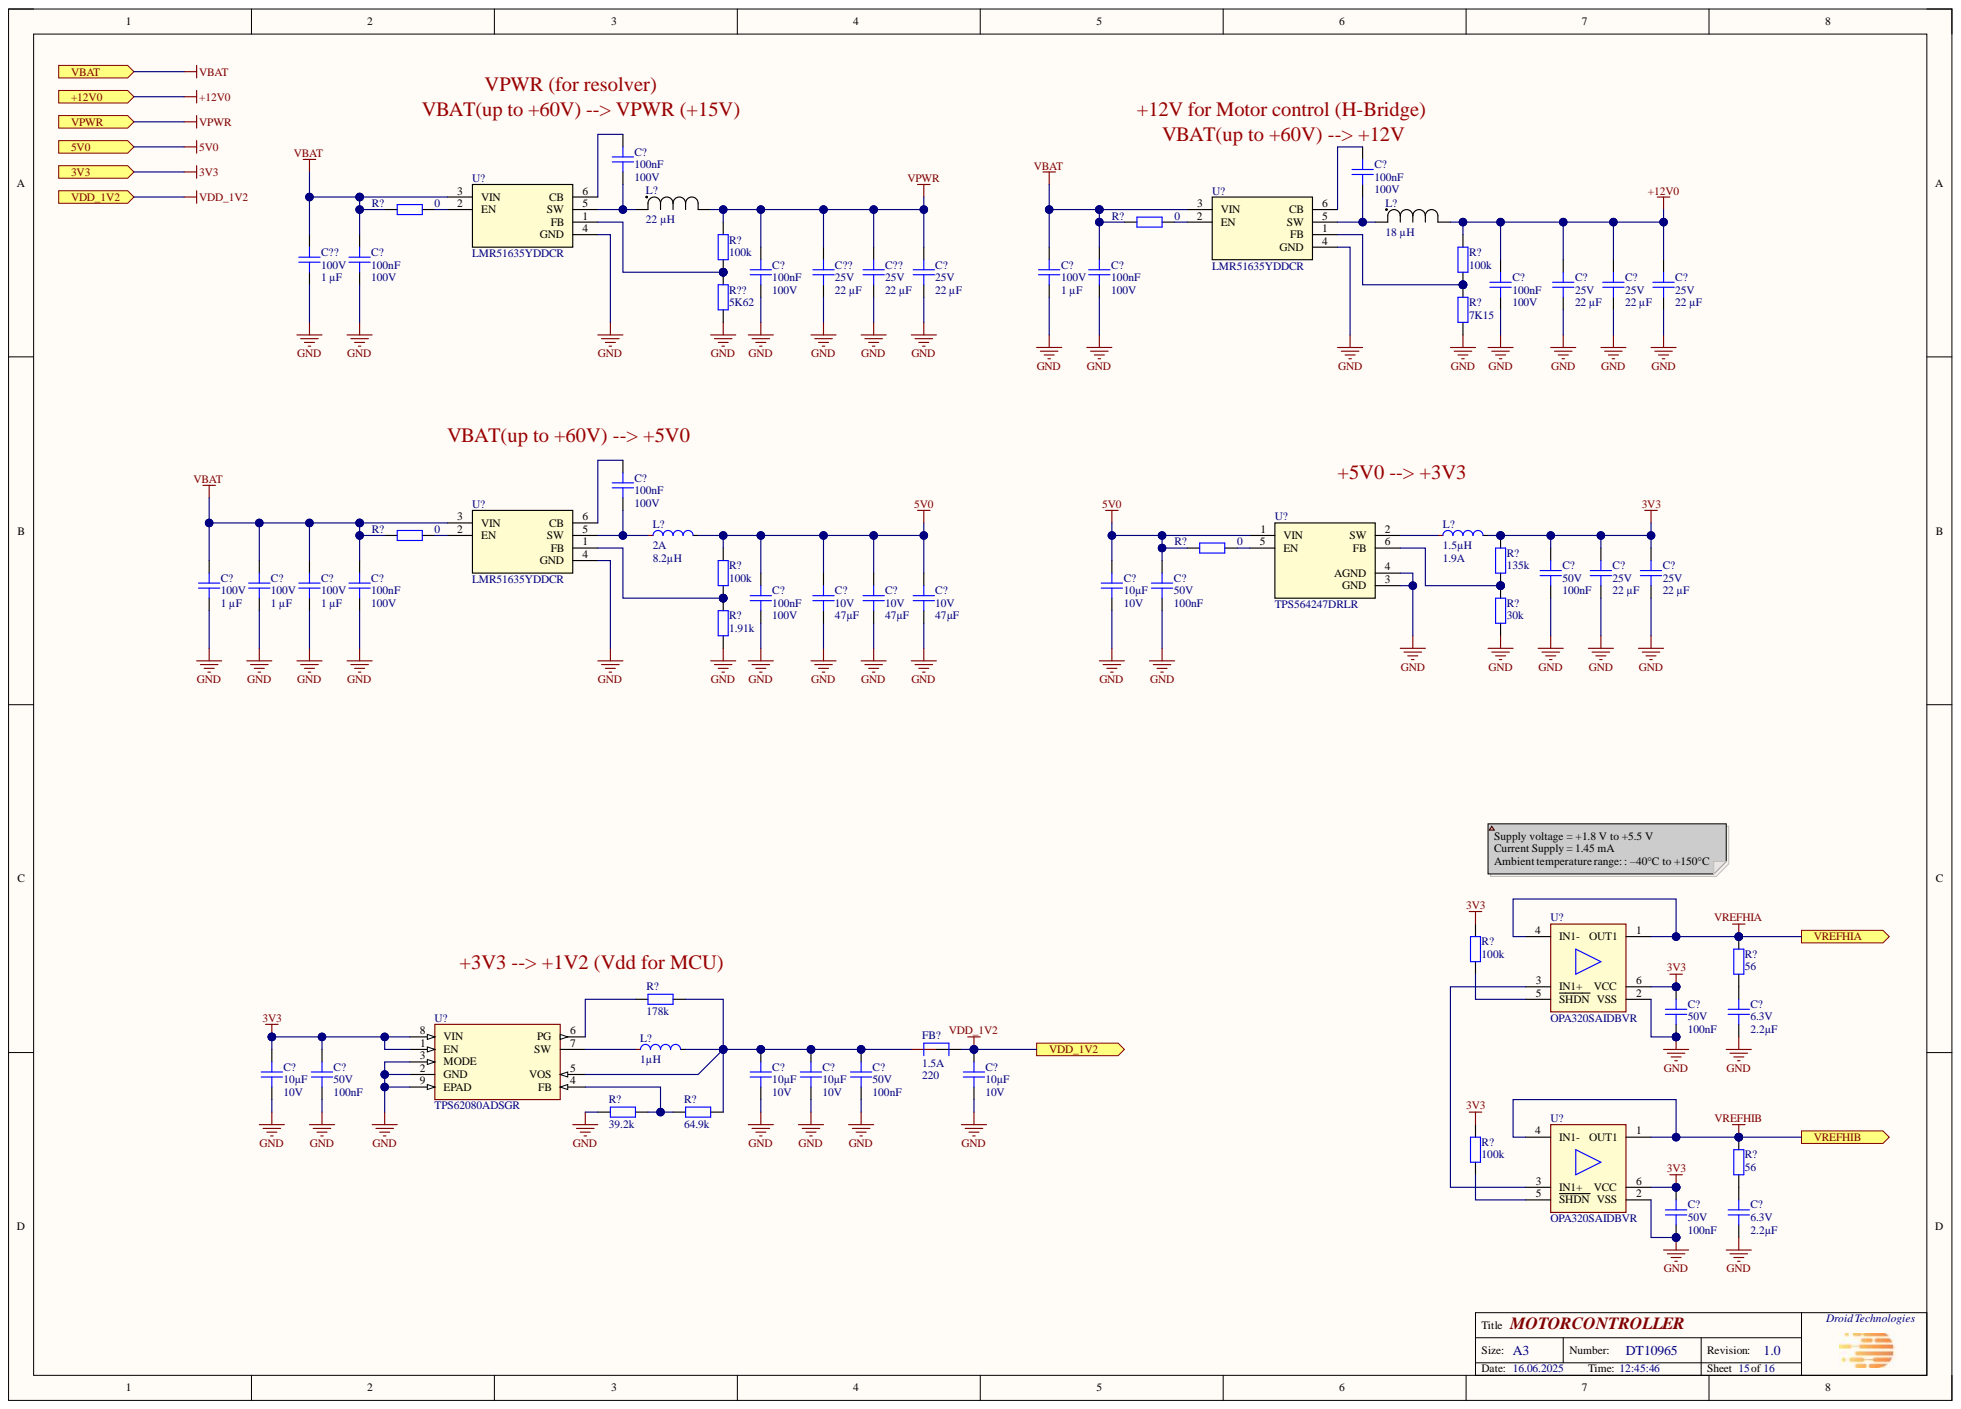
[picture p17: page 15]

+12V for Motor control (H-Bridge)
VBAT(up to +60V) --> +12V

Supply voltage = +1.8 V to +5.5 V
Current Supply = 1.45 mA
Ambient temperature range: : –40°C to +150°C

OUT1 | 1 IN1- 4

SHDN 5

EPAD 9

MOTORCONTROLLER Title | Droid Technologies

Size: A3 | Number: DT10965 | Revision: 1.0

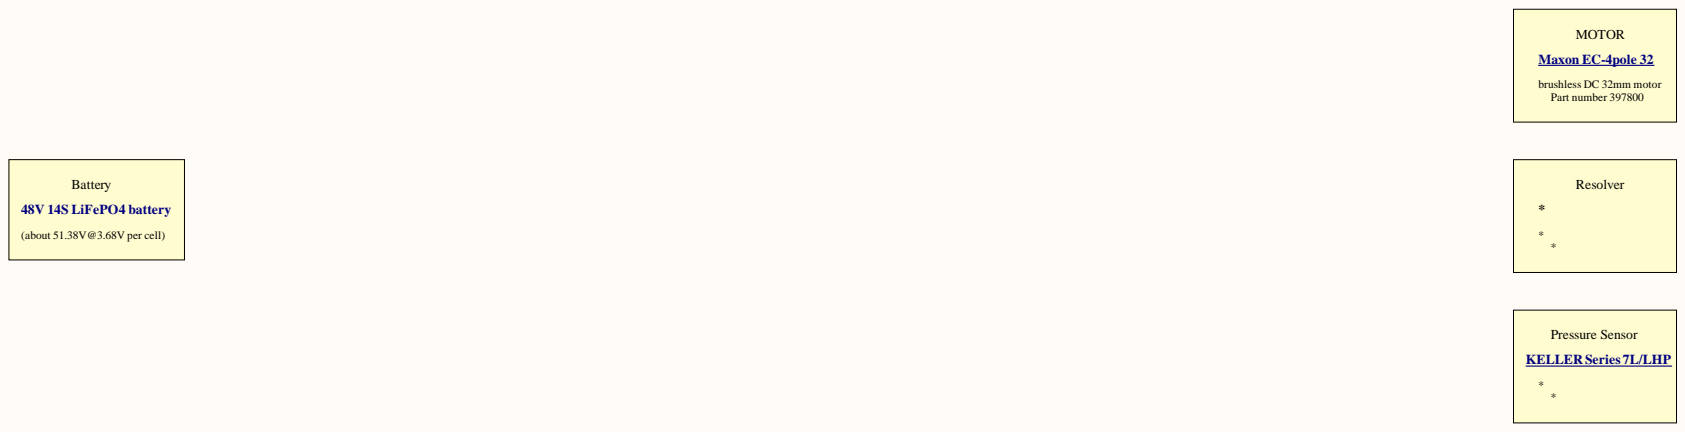
[picture p18: page 16]

MOTORCONTROLLER Title | Droid Technologies

Size: A4 | Number: DT10965 | Revision: 1.0
