eSpark-Backup/ford-creighton-pcb-design-review/Client-Files/DROID ITEMS FOR REVIEW/BackUp/DT10965_MOTOR_CONTROLLER/DT10965_MOTOR_CONTROLLER_SCH.pdf

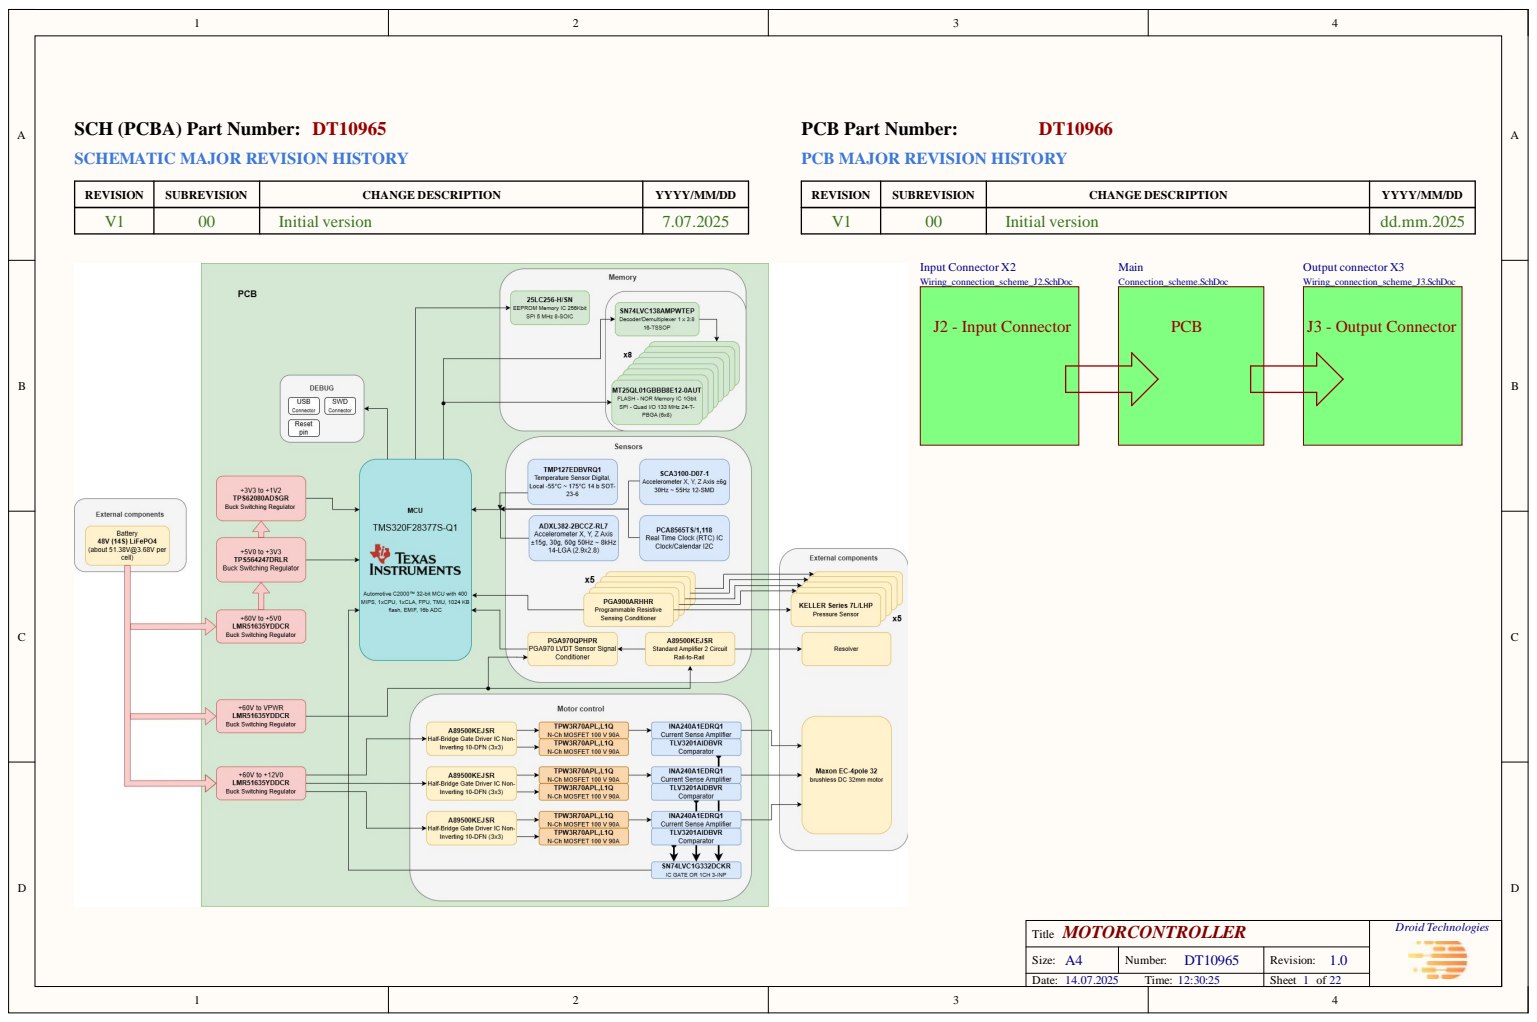
[picture p19: page 1]

MOTORCONTROLLER Title | Droid Technologies

Size: A4 | Number: DT10965 | Revision: 1.0
Date: 14.07.2025 Time: 12:30:25 | | Sheet of

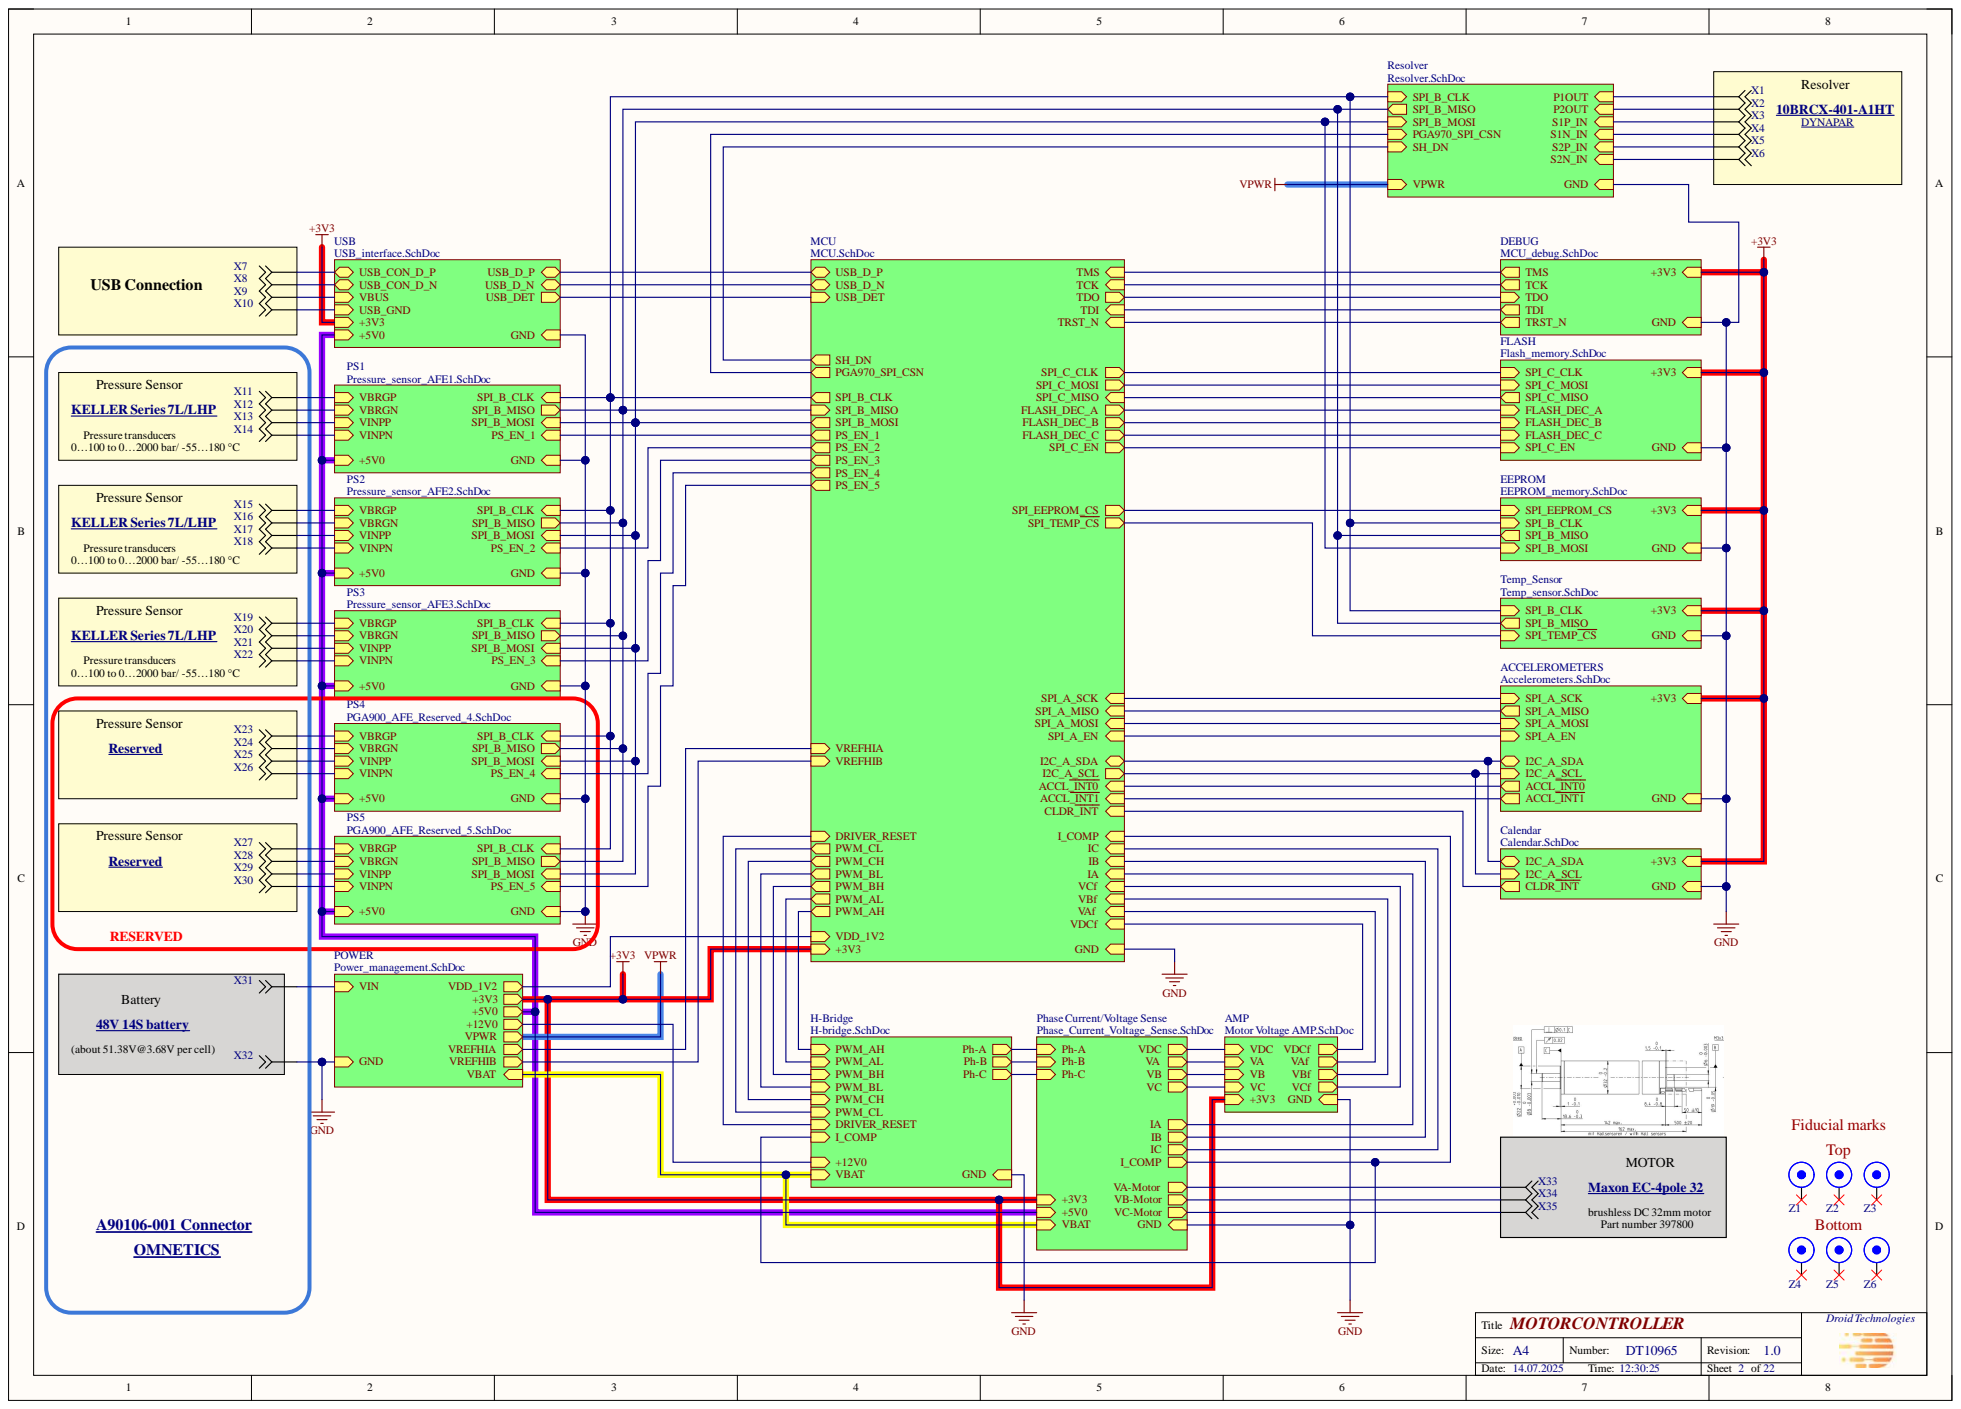
[picture p20: page 2]

SPI_B_M ISO
SPI_B_M OSI
PG A970_SPI_CSN SH_D N VPWR

V B R G P SPI_B_C V B R G N SPI_B_M ISO V INPP SPI_B_M OSI V INPN PS_E N_5 | L K

3 VPWR

G tage Sens e tage_Sense.Sc

+12V 0 V R EFH IA G N D V R EFH I B V B AT | H -B r idg e H -br idge.SchD o c

V D C | VAVBVCVD C V D C f VA f
VAVBVCIAIBIC | +3V 3 G N D

M O TORCO N TRO LLER Ti t l e | D roid Technologies

Size : A | Number : D T1096 5 | Revi s i on : 1.0
Dat e : 14.07.202 5 Ti m e : 12:30: | | Shee t of

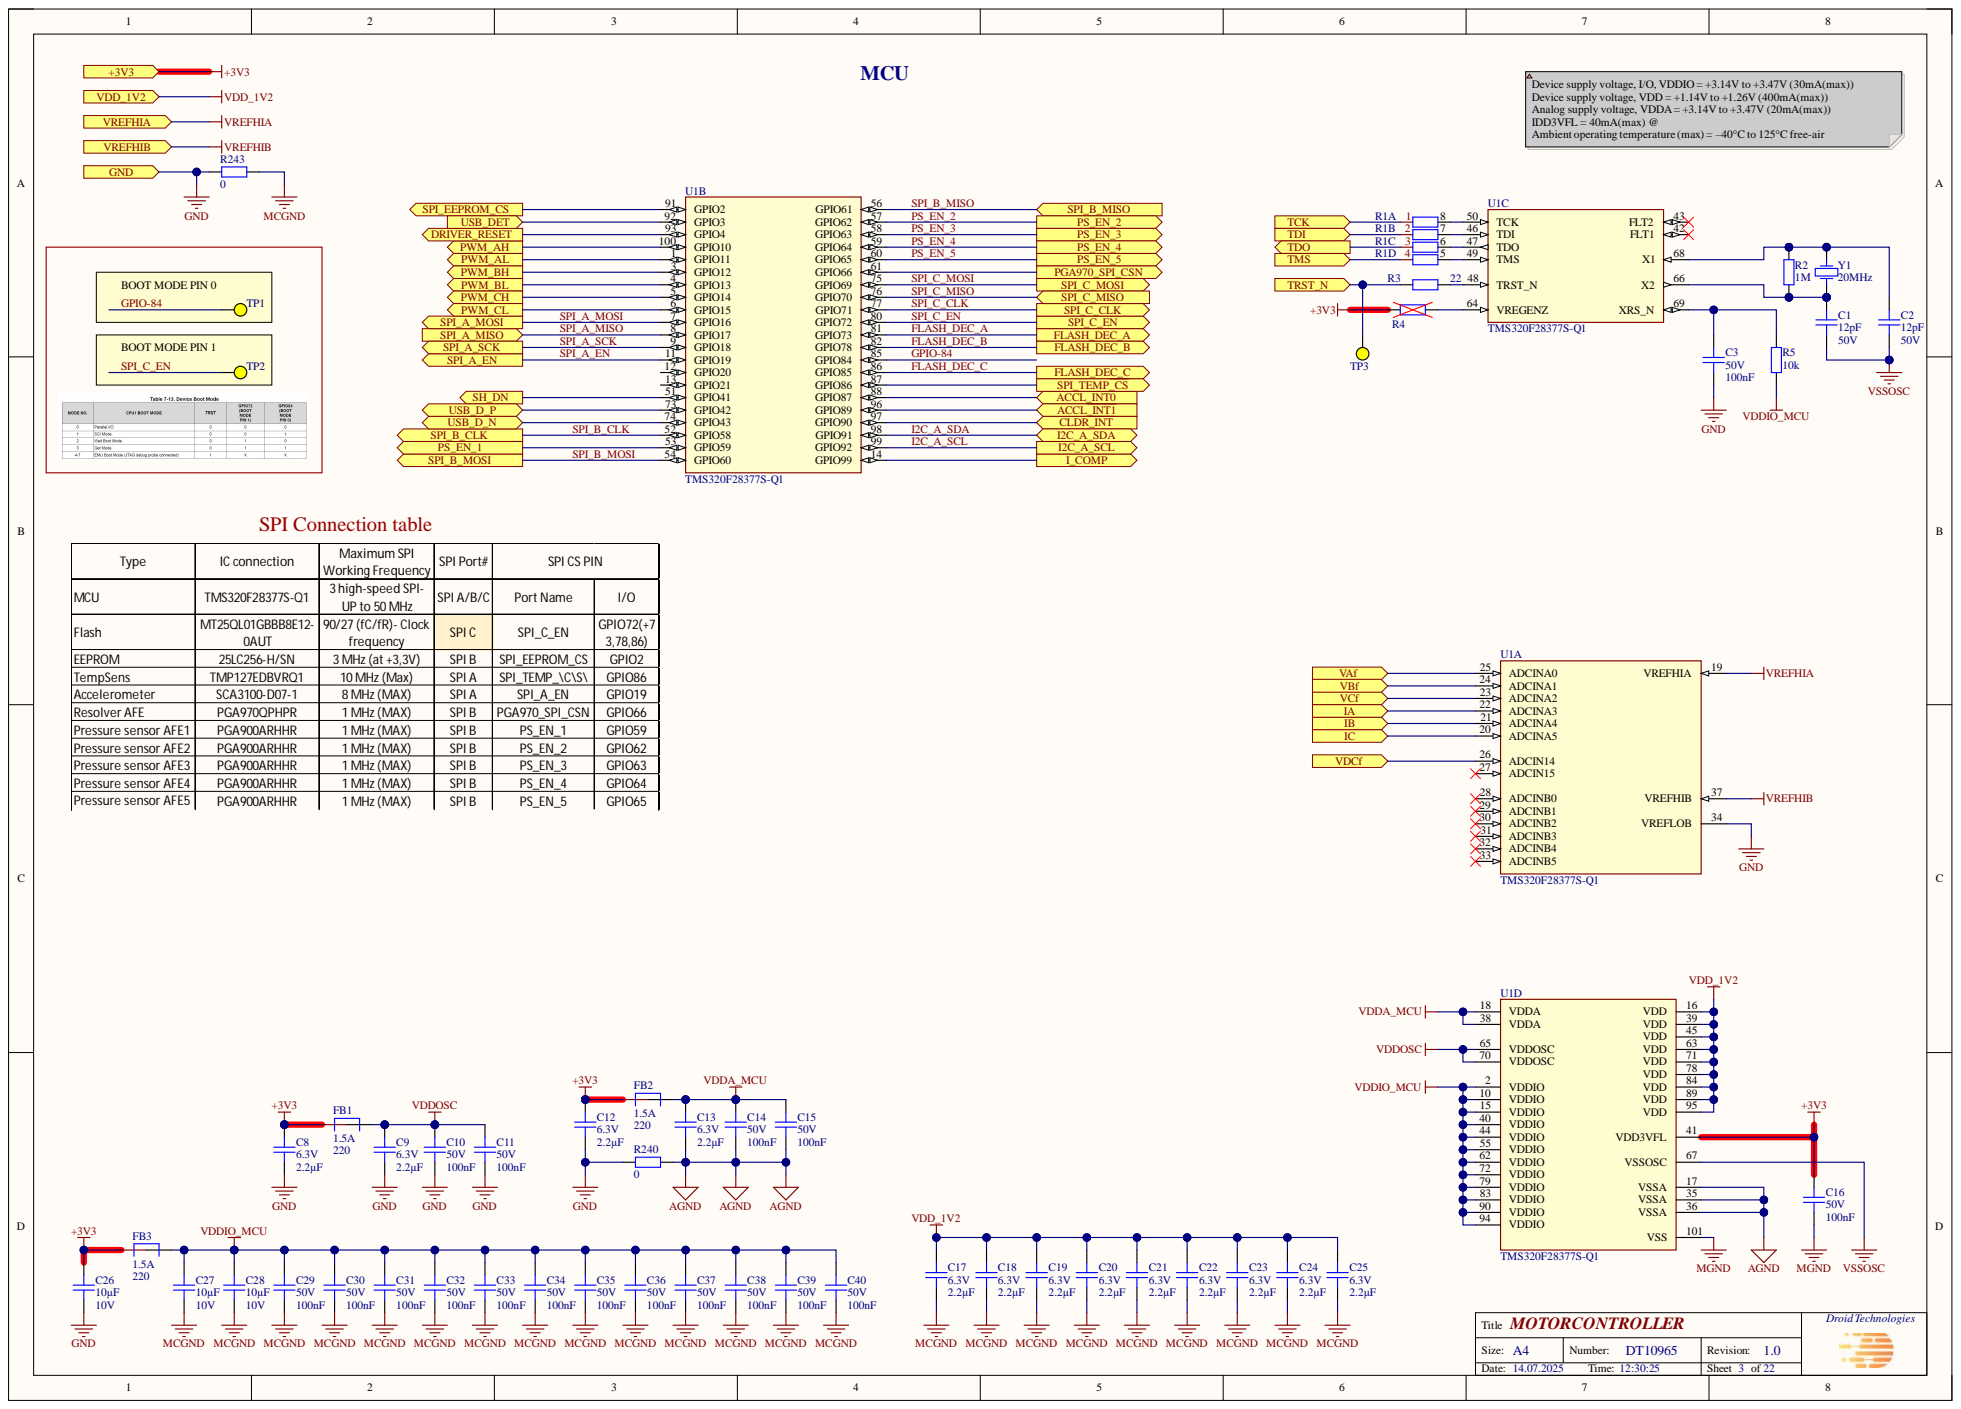
[picture p21: page 3]

Device supply voltage, I/O, VDDIO = +3.14V to +3.47V (30mA(max))
Device supply voltage, VDD = +1.14V to +1.26V (400mA(max))
Analog supply voltage, VDDA= +3.14V to +3.47V (20mA(max))
IDD3VFL = 40mA(max) @
Ambient operating temperature (max) = –40°C to 125°C free-air

Type | IC connection | Maximum SPI Working Frequency | SPI Port# | SPI CS PIN

MCU | TMS320F28377S-Q1 | 3 high-speed SPI-UP to 50 MHz | SPI A/B/C | Port Name | I/O

Flash | MT25QL01GBBB8E12-0AUT | 90/27 (fC/fR)- Clock frequency | SPI C | SPI_C_EN | GPIO72(+7 3,78,86)

EEPROM | 25LC256-H/SN | 3 MHz (at +3,3V) | SPI B | SPI_EEPROM_CS | GPIO2
TempSens | TMP127EDBVRQ1 | 10 MHz (Max) | SPI A | SPI_TEMP_\C\S\ | GPIO86
Accelerometer | SCA3100-D07-1 | 8 MHz (MAX) | SPI A | SPI_A_EN | GPIO19
Resolver AFE | PGA970QPHPR | 1 MHz (MAX) | SPI B | PGA970_SPI_CSN | GPIO66
Pressure sensor AFE1 | PGA900ARHHR | 1 MHz (MAX) | SPI B | PS_EN_1 | GPIO59
Pressure sensor AFE2 | PGA900ARHHR | 1 MHz (MAX) | SPI B | PS_EN_2 | GPIO62
Pressure sensor AFE3 | PGA900ARHHR | 1 MHz (MAX) | SPI B | PS_EN_3 | GPIO63

MOTORCONTROLLER Title | Droid Technologies

MCGND MCGND MCGND MCGND MCGND MCGND

MCGND MCGND MCGND MCGND

Size: A4 | Number: DT10965 | Revision: 1.0

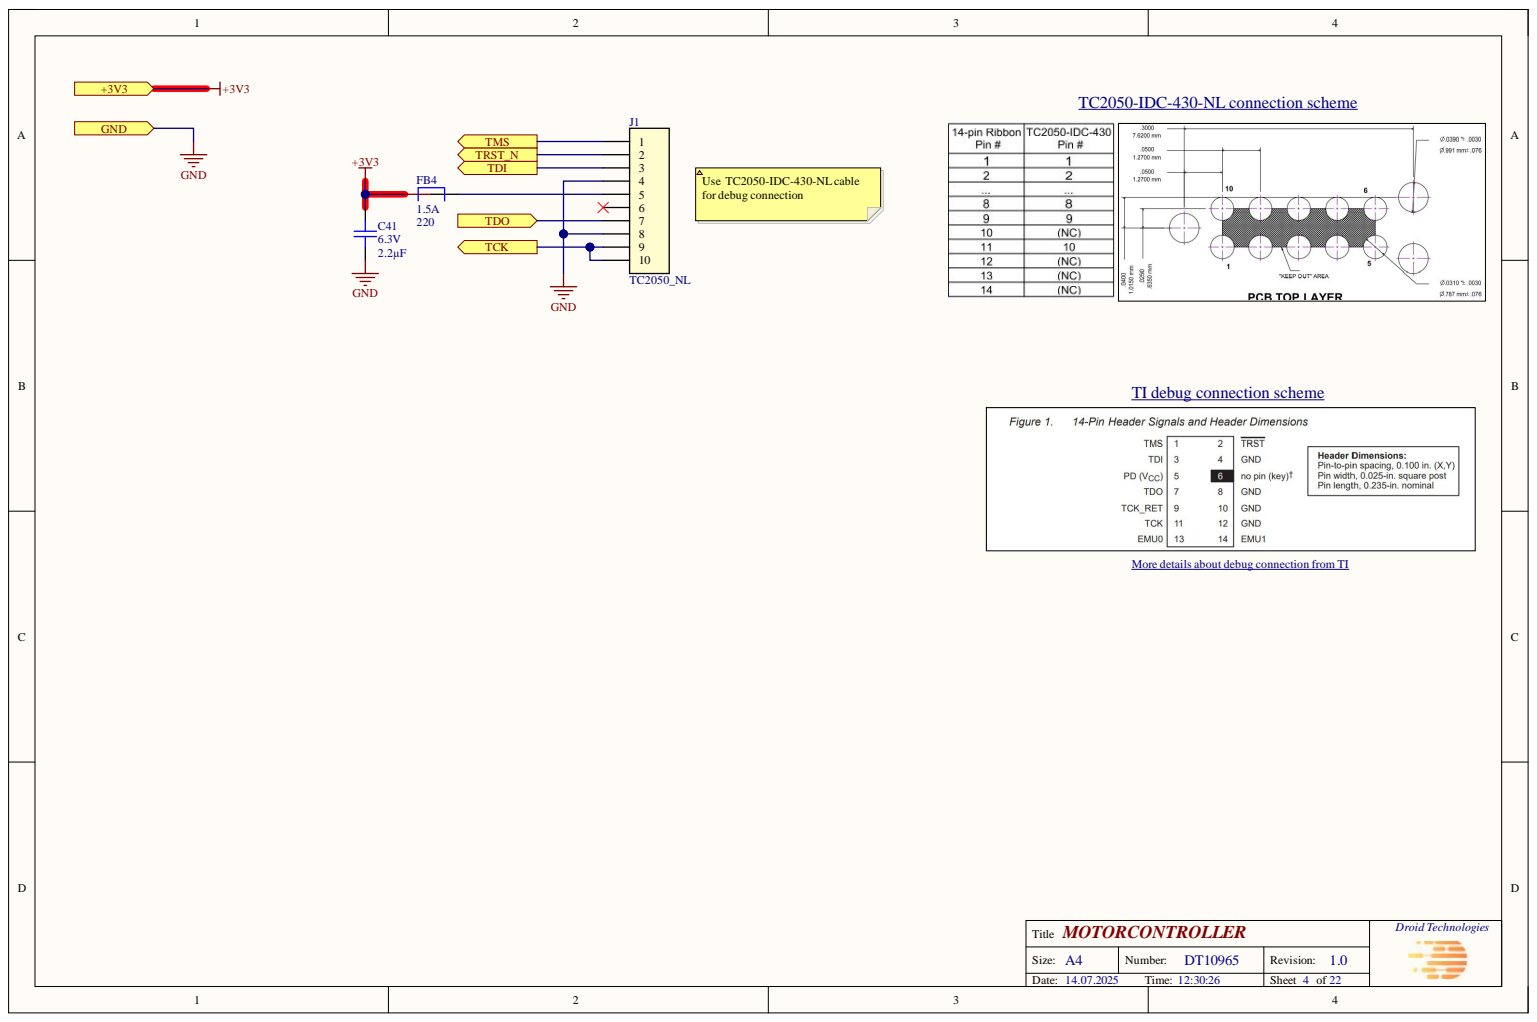
[picture p22: page 4]

MOTORCONTROLLER T i tl e | D ro i d Tech n o l o g i e s

Size : A 4 | N umb er : DT1 0 9 6 5 | Rev i s i o n : 1 . 0
Dat e : 4.0 . T ime : : : | | Shee t o f

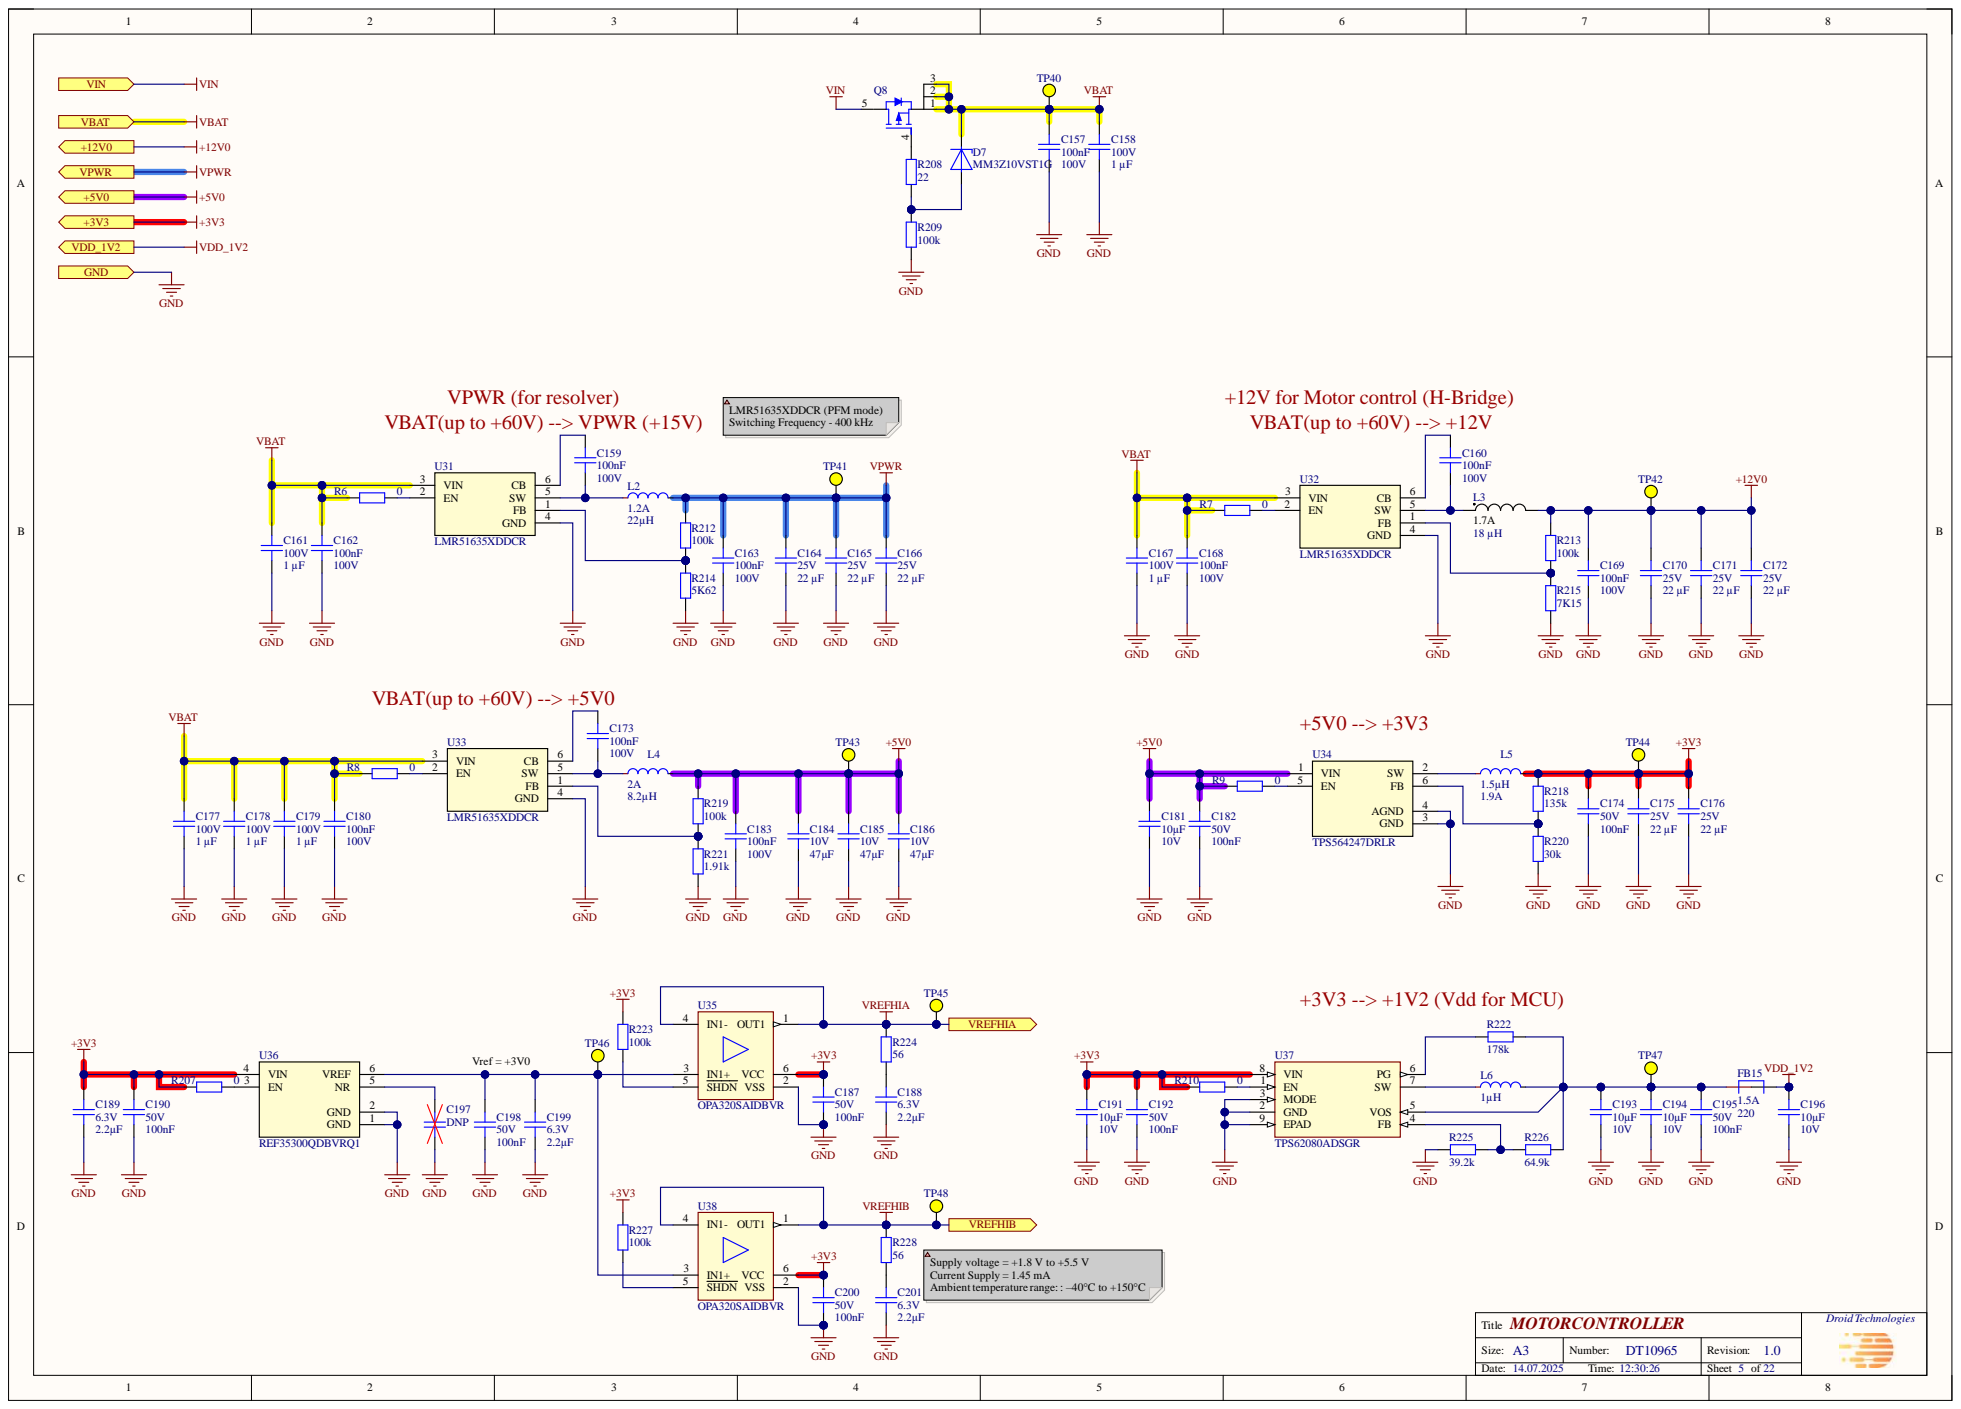
[picture p23: page 5]

+12V for Motor control (H-Bridge)

U38
OUT1 | 1 IN1- 4

Supply voltage = +1.8 V to +5.5 V
Current Supply = 1.45 mA
Ambient temperature range: : –40°C to +150°C

MOTORCONTROLLER Title | Droid Technologies

Size: A3 | Number: DT10965 | Revision: 1.0

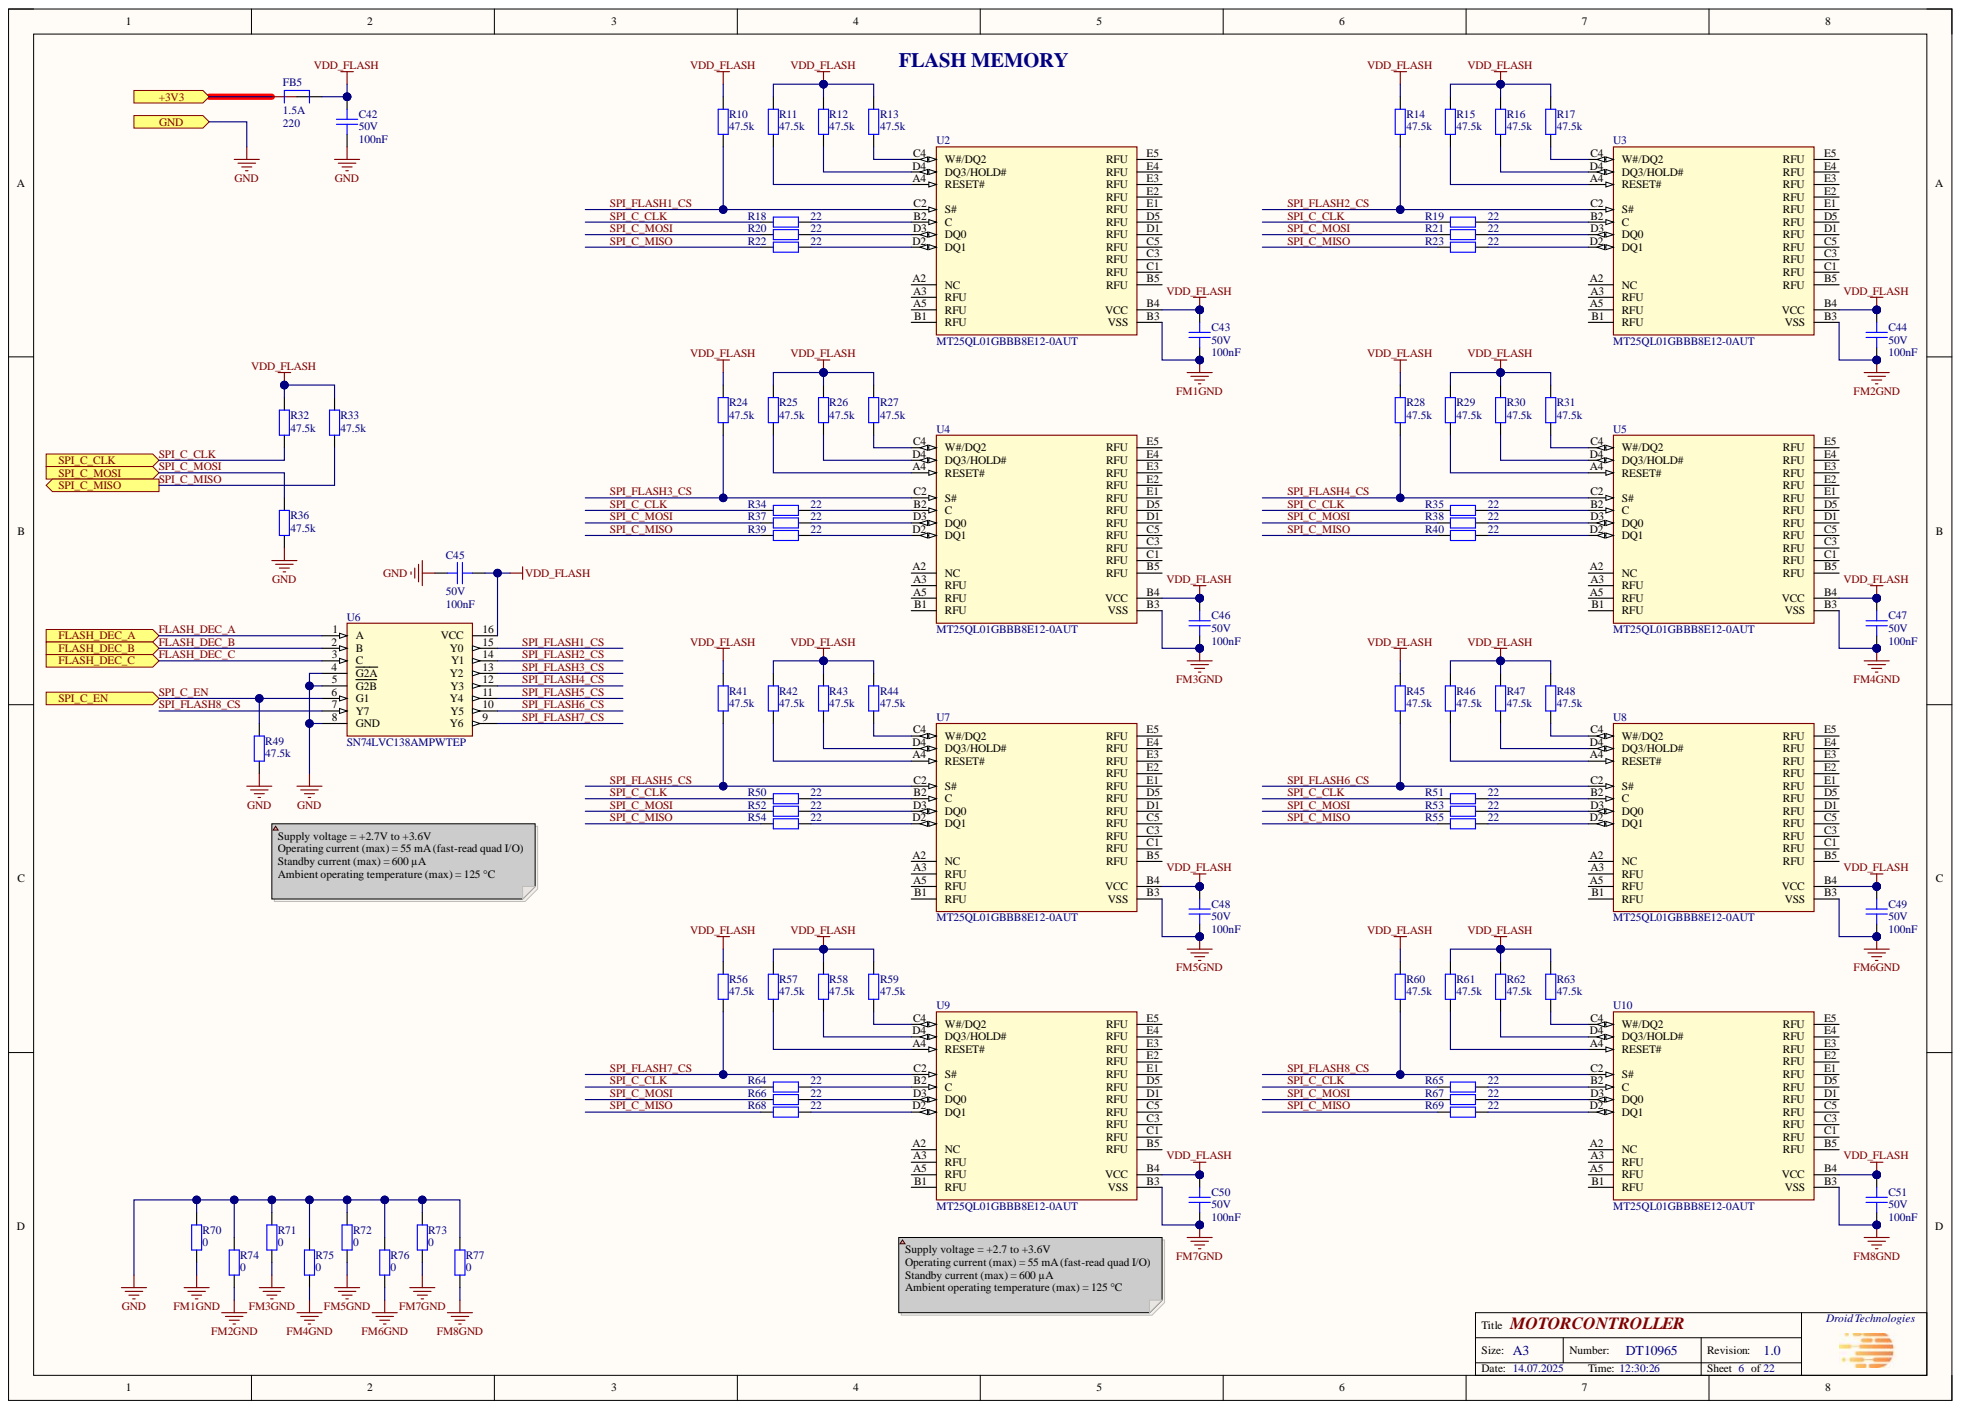
[picture p24: page 6]

M O TORCO N TRO LLER Ti t l e | D roid Technologies

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

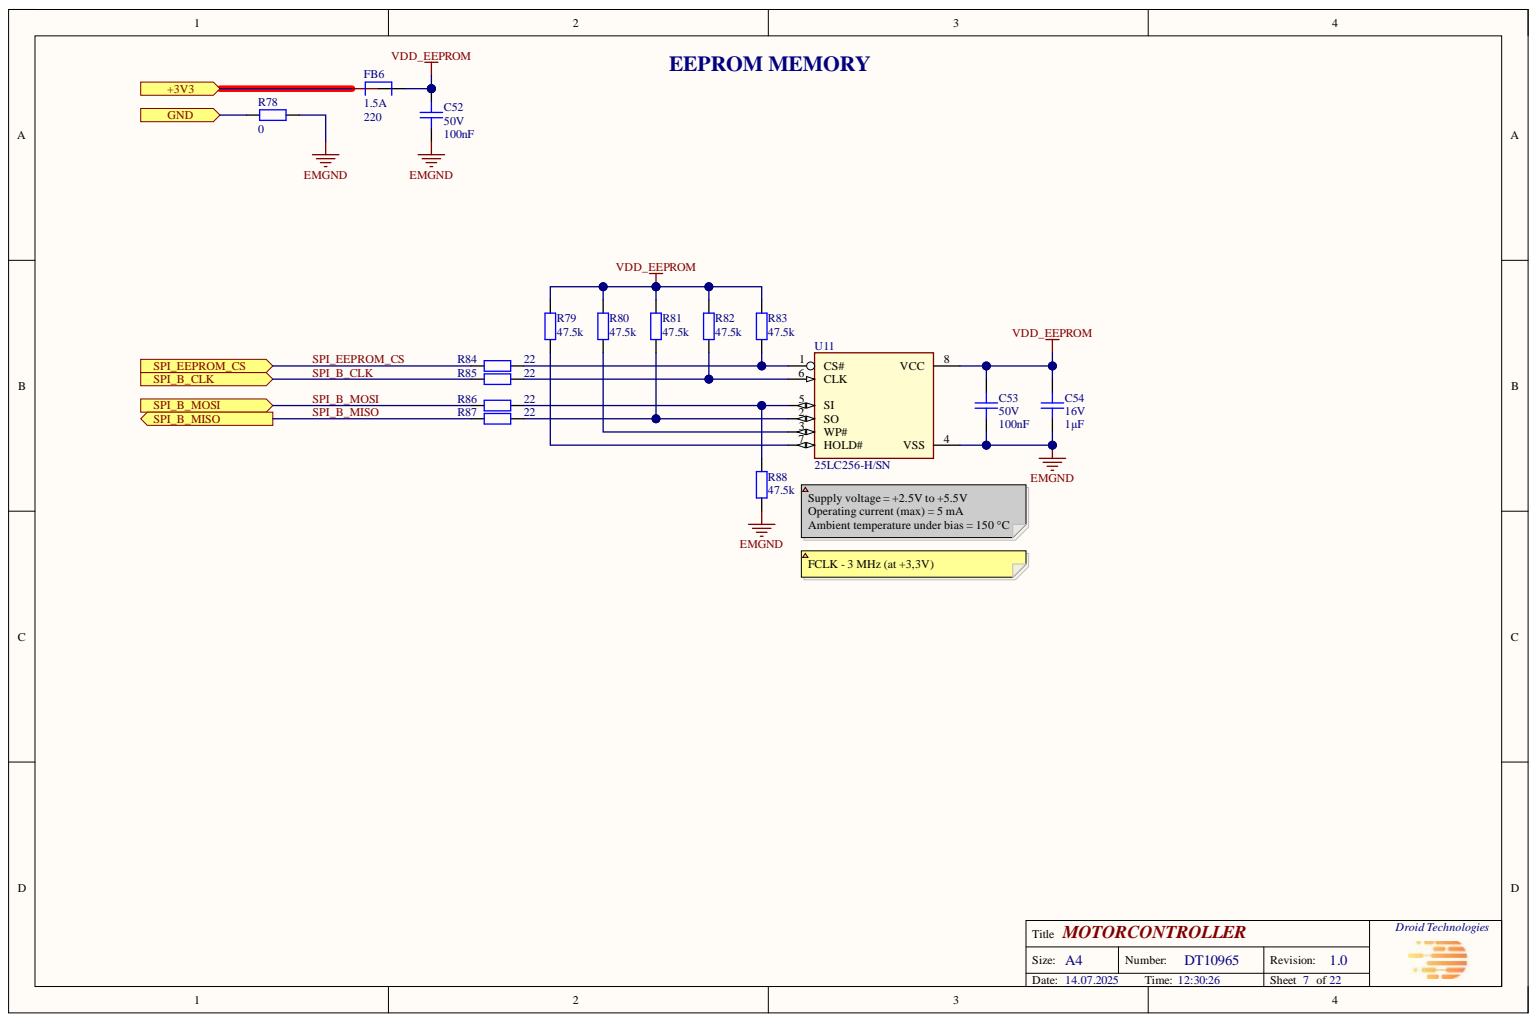
[picture p25: page 7]

CLK 6

HOLD# 7

Supply voltage = +2.5V to +5.5V
Operating current (max) = 5 mA
Ambient temperature under bias = 150 °C

MOTORCONTROLLER Title | Droid Technologies

Size: A4 | Number: DT10965 | Revision: 1.0

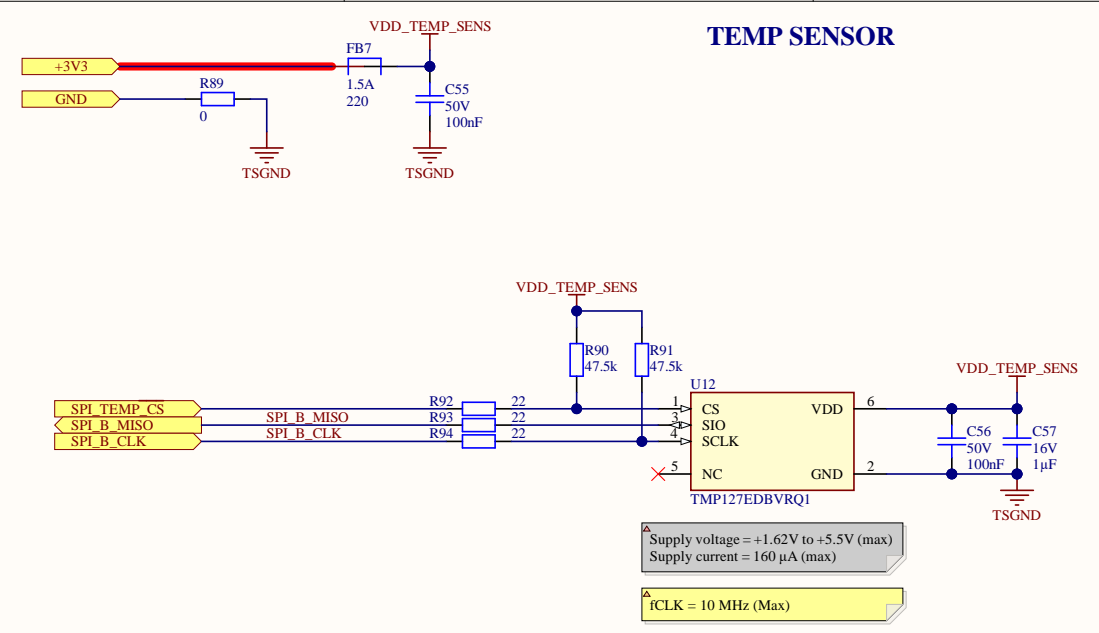
[picture p26: page 8]

SIO 3
SCLK 4

Supply voltage = +1.62V to +5.5V (max)
Supply current = 160 μA (max)

MOTORCONTROLLER Title | Droid Technologies

Size: A4 | Number: DT10965 | Revision: 1.0

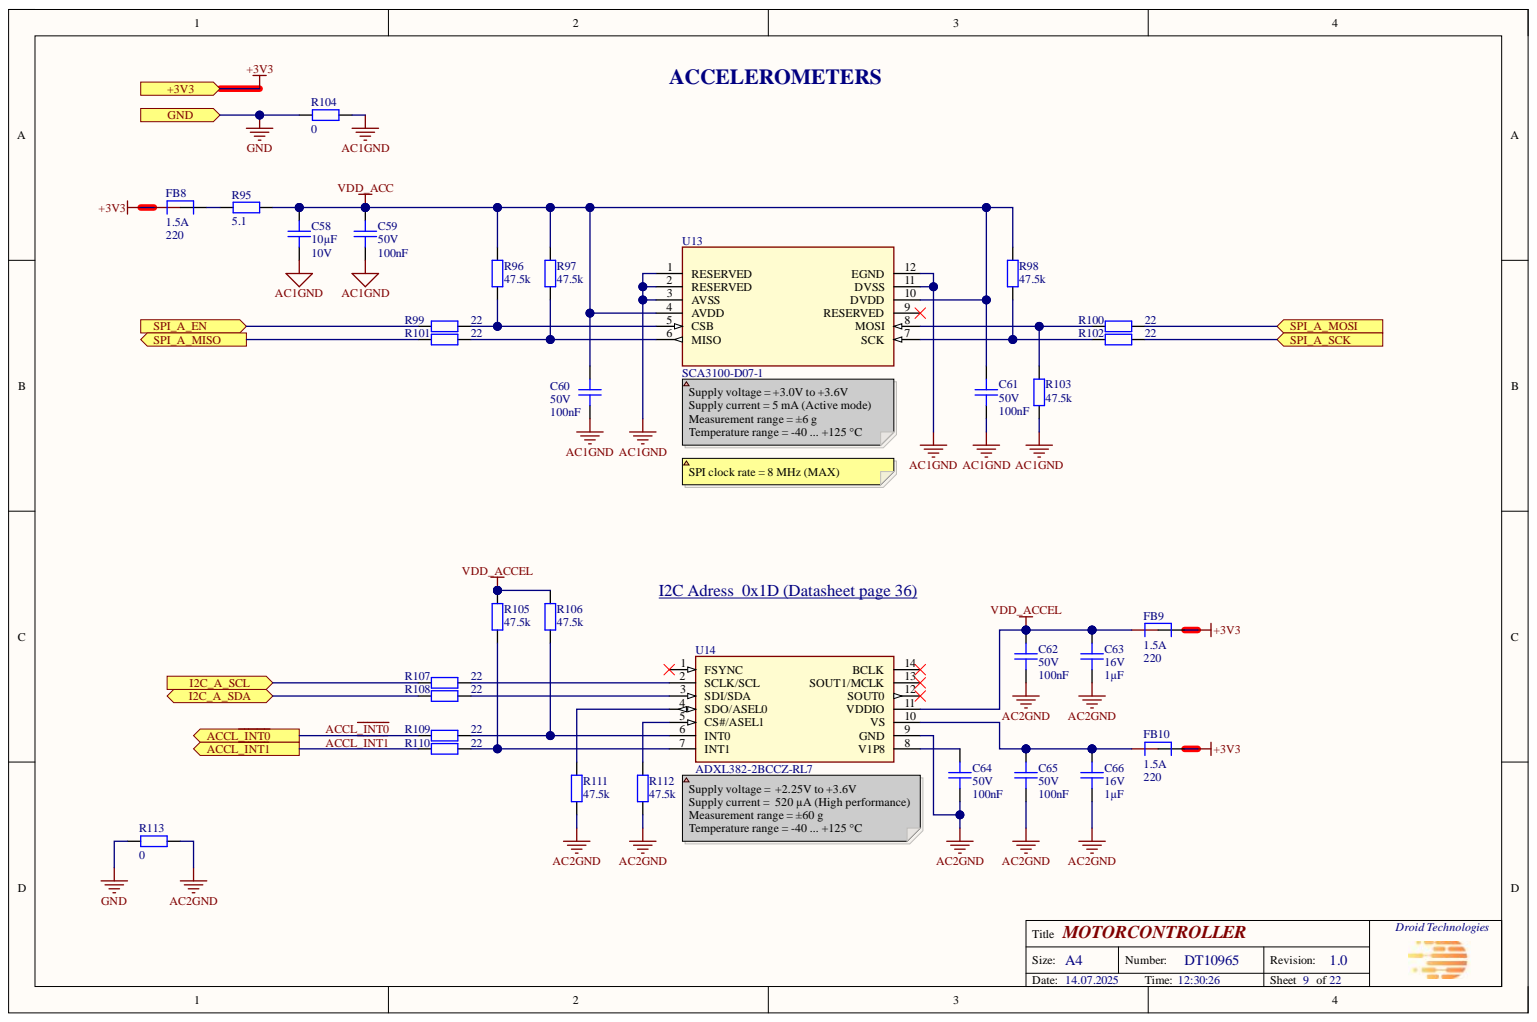
[picture p27: page 9]

RESERVED 2

AVDD 4
CSB 5

SCA3100-D07-1
Supply voltage = +3.0V to +3.6V
Supply current = 5 mA (Active mode)
Measurement range = ±6 g
Temperature range = -40 ... +125 °C

SPI clock rate = 8 MHz (MAX)

SDI/SDA 3
SDO/ASEL0 4
CS#/ASEL1 5
INT0 6

ADXL382-2BCCZ-RL7
Supply voltage = +2.25V to +3.6V
Supply current = 520 µA (High performance)
Measurement range = ±60 g

MOTORCONTROLLER Title | Droid Technologies

Size: A4 | Number: DT10965 | Revision: 1.0

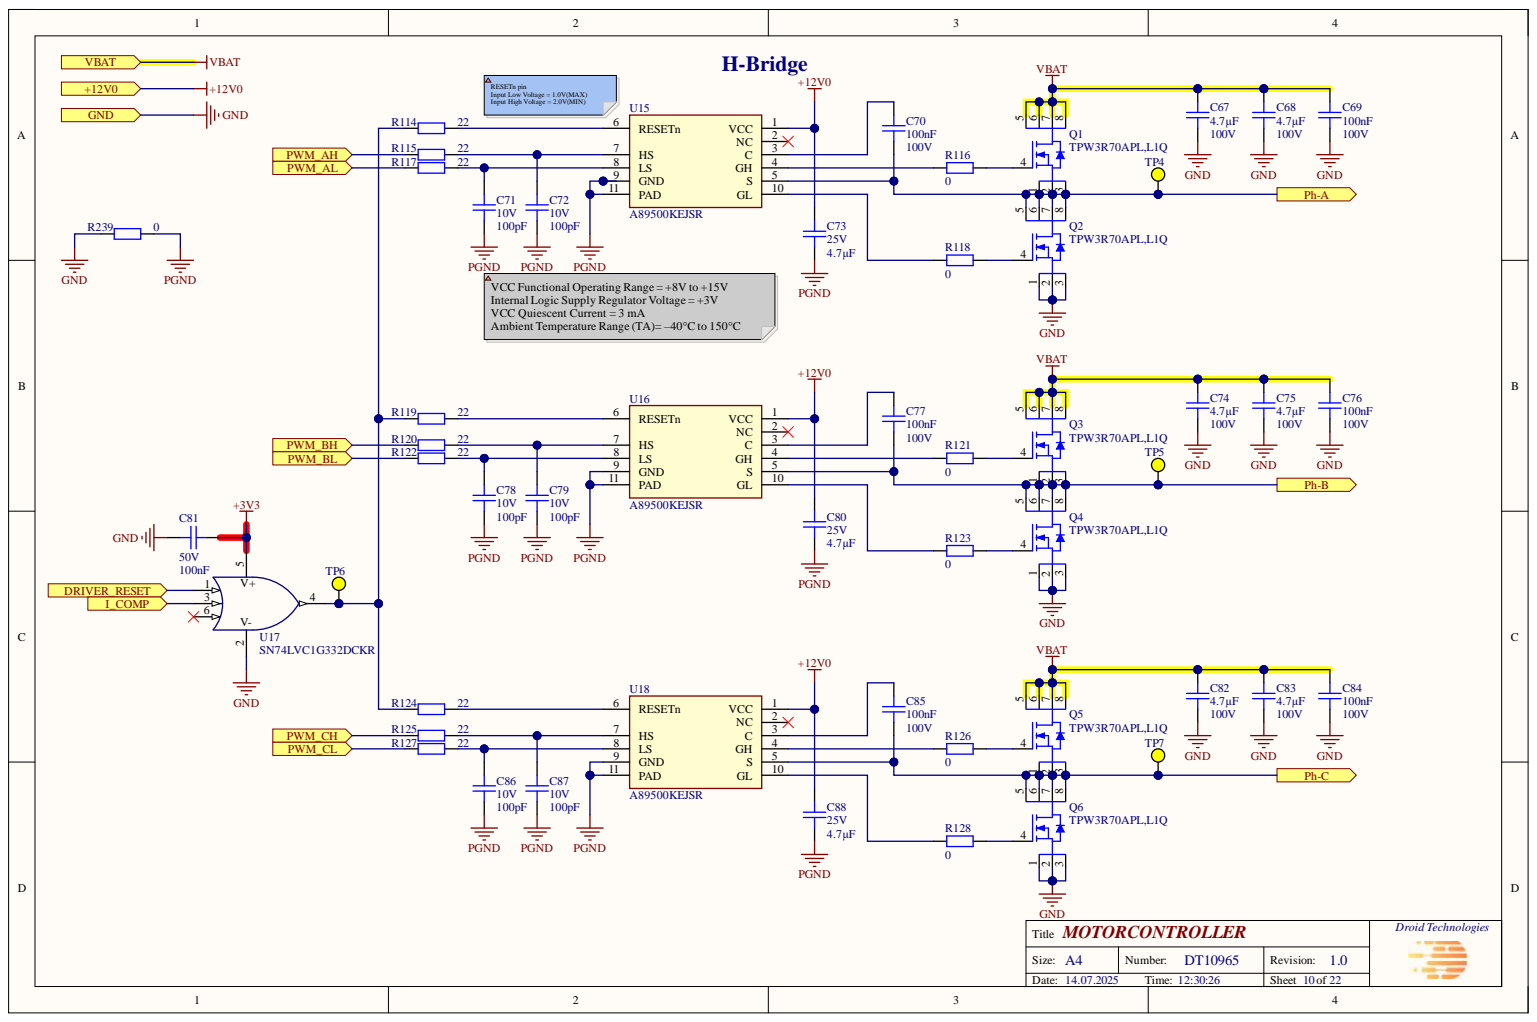
[picture p28: page 10]

1 1

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

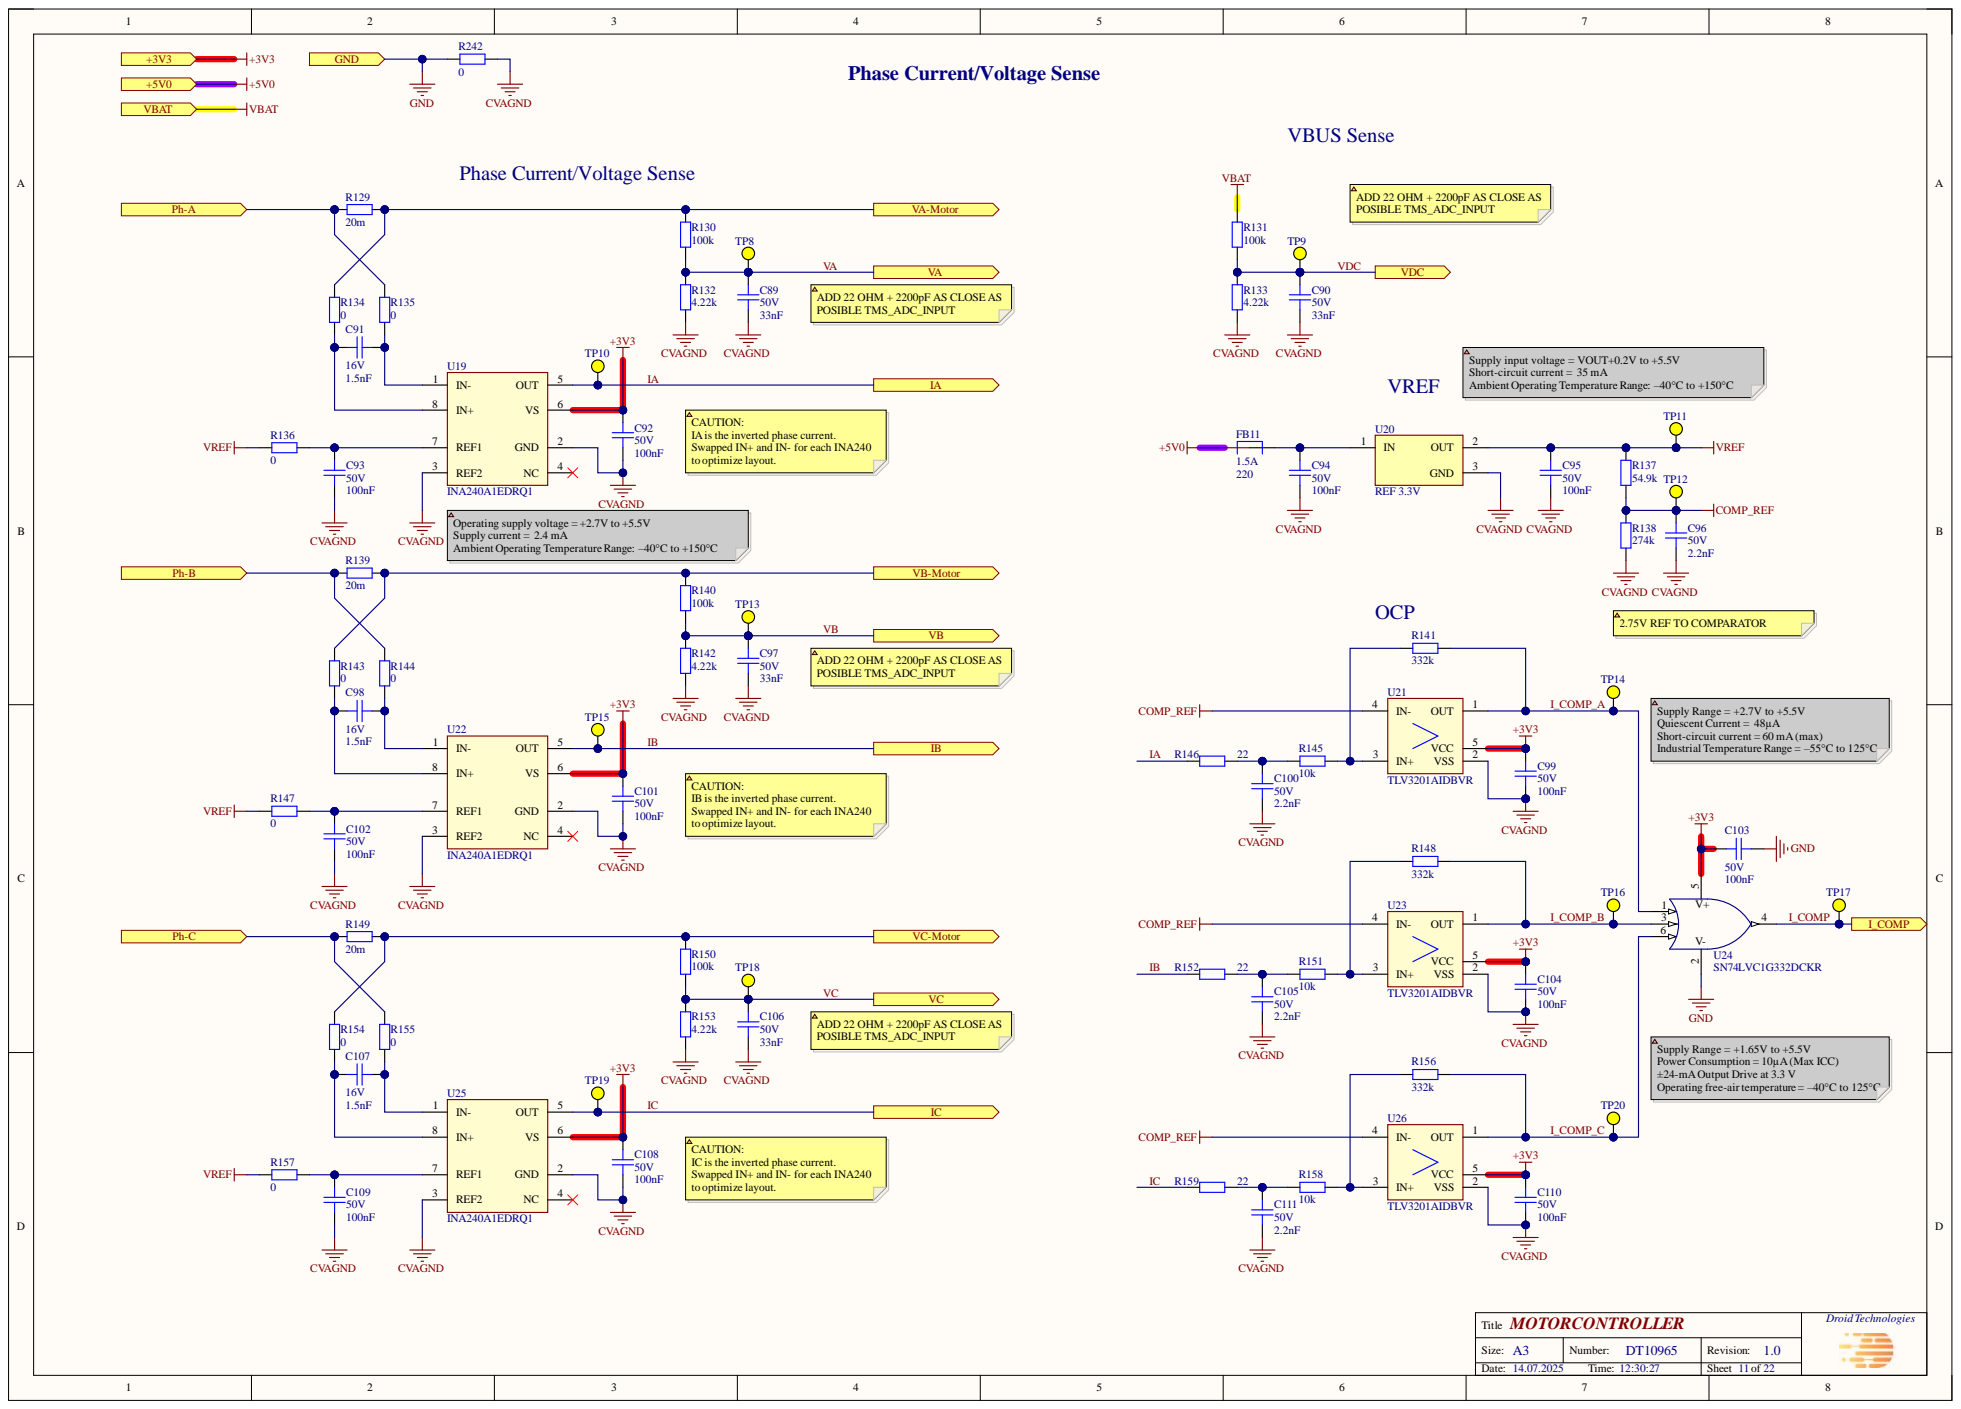
[picture p29: page 11]

Phase Current/Voltage Sense

Supply Range = +2.7V to +5.5V Quiescent Current = 48µA

M O TORCO N TRO LLER Ti t l e | D roid Technologies

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

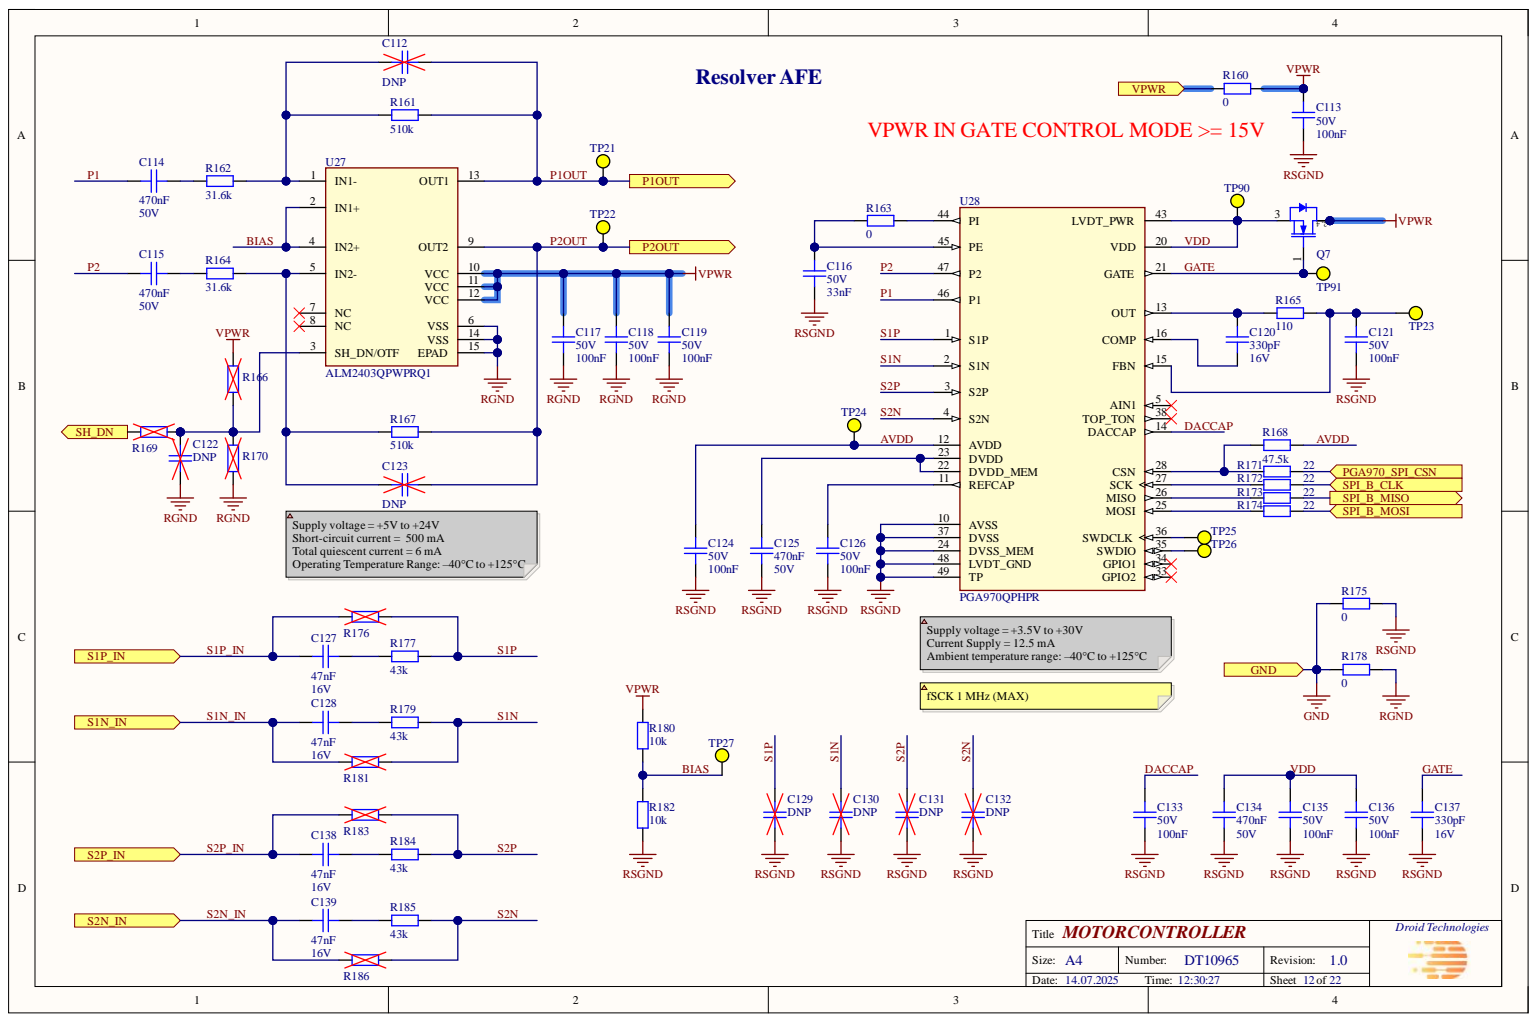
[picture p30: page 12]

VPWR IN GATE CONTROL MODE >= 15V

PE 45 | VDD

DVDD 23
DVDD_MEM 22
REFCAP 11

DVSS 37 AVSS 10

Supply voltage = +5V to +24V
Short-circuit current = 500 mA
Total quiescent current = 6 mA
Operating Temperature Range: –40°C to +125°C

Supply voltage = +3.5V to +30V
Current Supply = 12.5 mA
Ambient temperature range: –40°C to +125°C

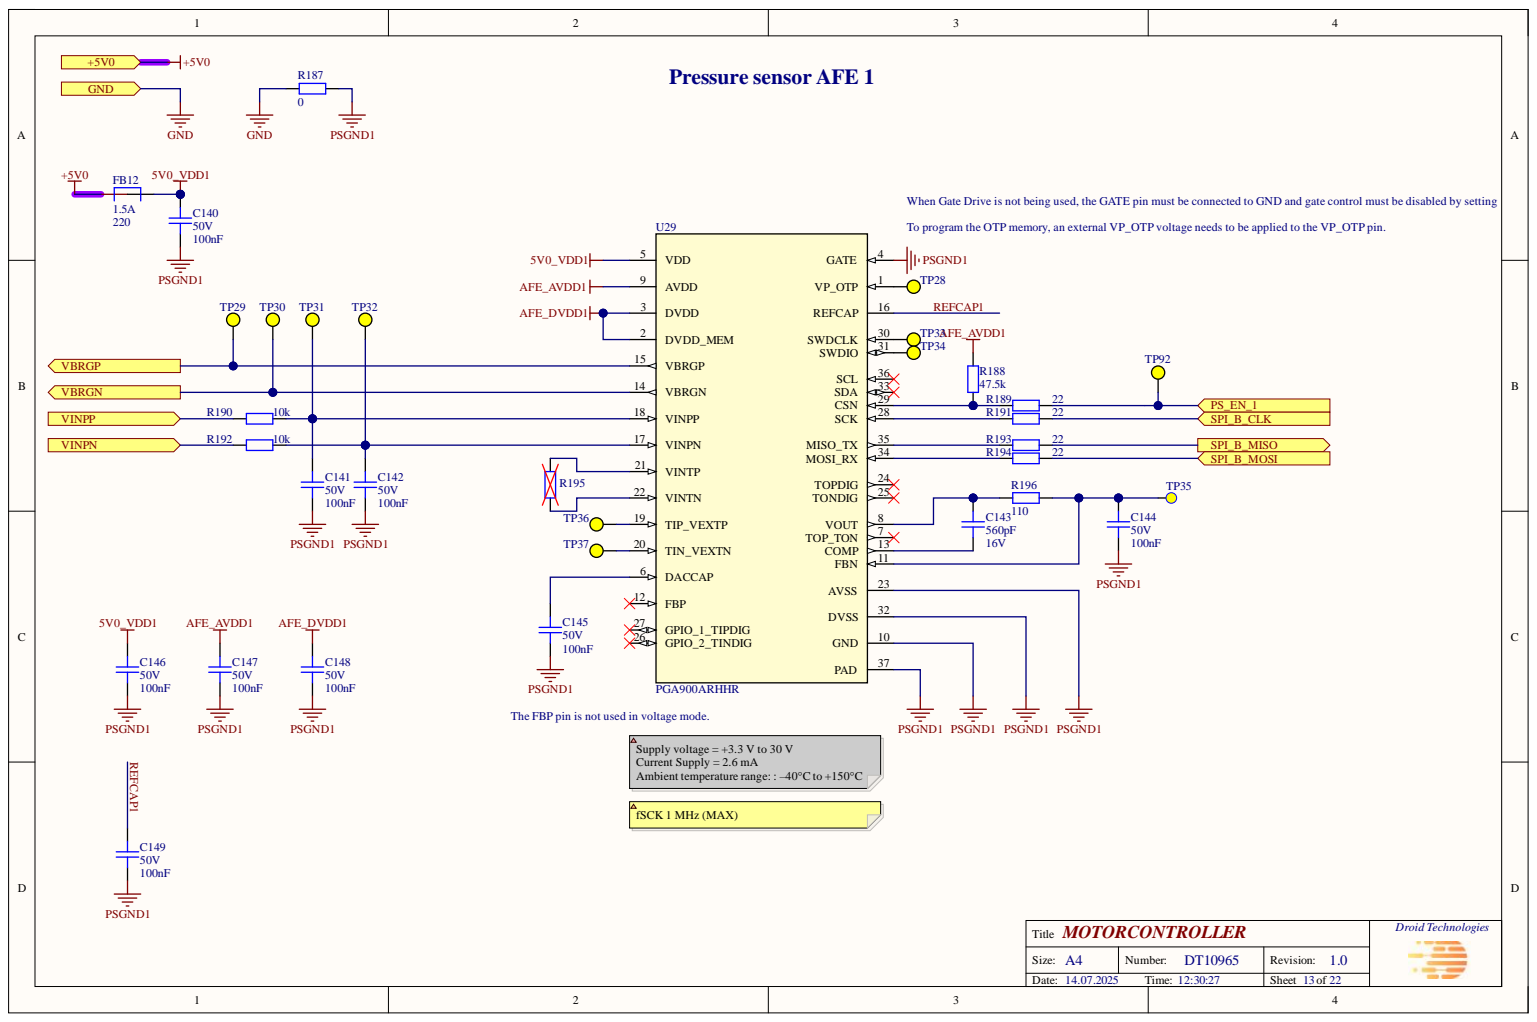
[picture p31: page 13]

When Gate Drive is not being used, the GATE pin must be connected to GND and gate control must be disabled by setting

To program the OTP memory, an external VP_OTP voltage needs to be applied to the VP_OTP pin.

DVDD_MEM 2

VBRGN 14

VINPP 18

VINPN 17

VINTP 21

R195 | VINTN 22

The FBP pin is not used in voltage mode.

Supply voltage = +3.3 V to 30 V
Current Supply = 2.6 mA
Ambient temperature range: : –40°C to +150°C

MOTORCONTROLLER Title | Droid Technologies

Size: A4 | Number: DT10965 | Revision: 1.0

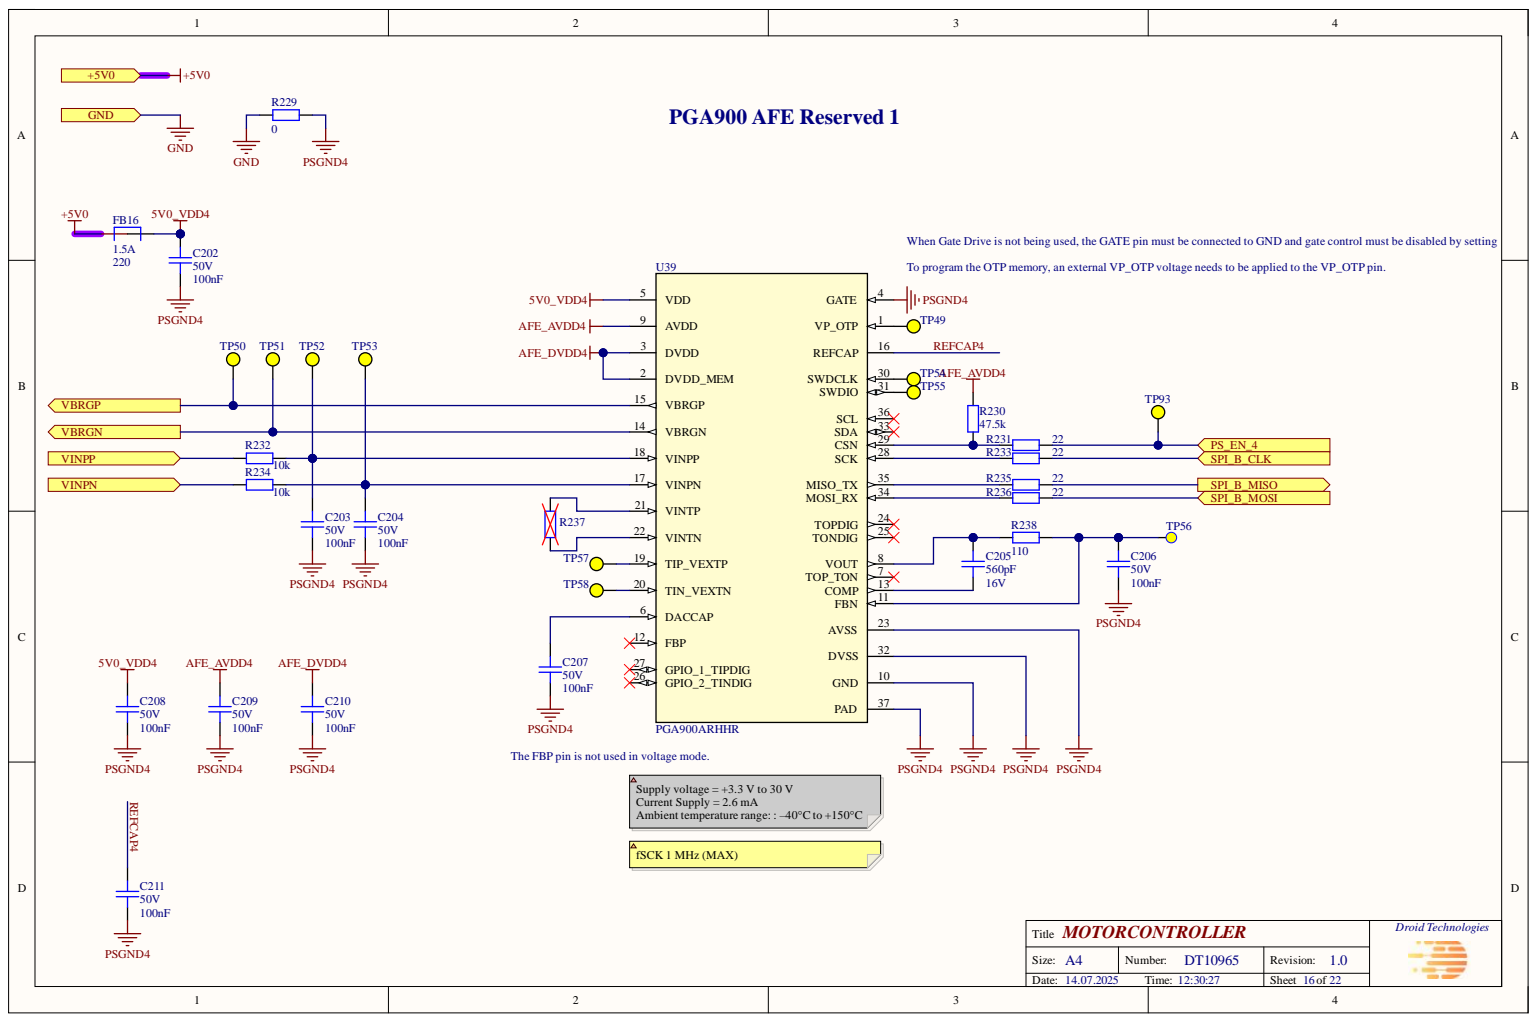
[picture p32: page 14]
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

DVDD 3

VBRGP 15

VBRGN 14

VINPP 18

VINPN 17

VINTP 21

R237 | VINTN 22

The FBP pin is not used in voltage mode.

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

MOTORCONTROLLER Title | Droid Technologies

Size: A4 | Number: DT10965 | Revision: 1.0

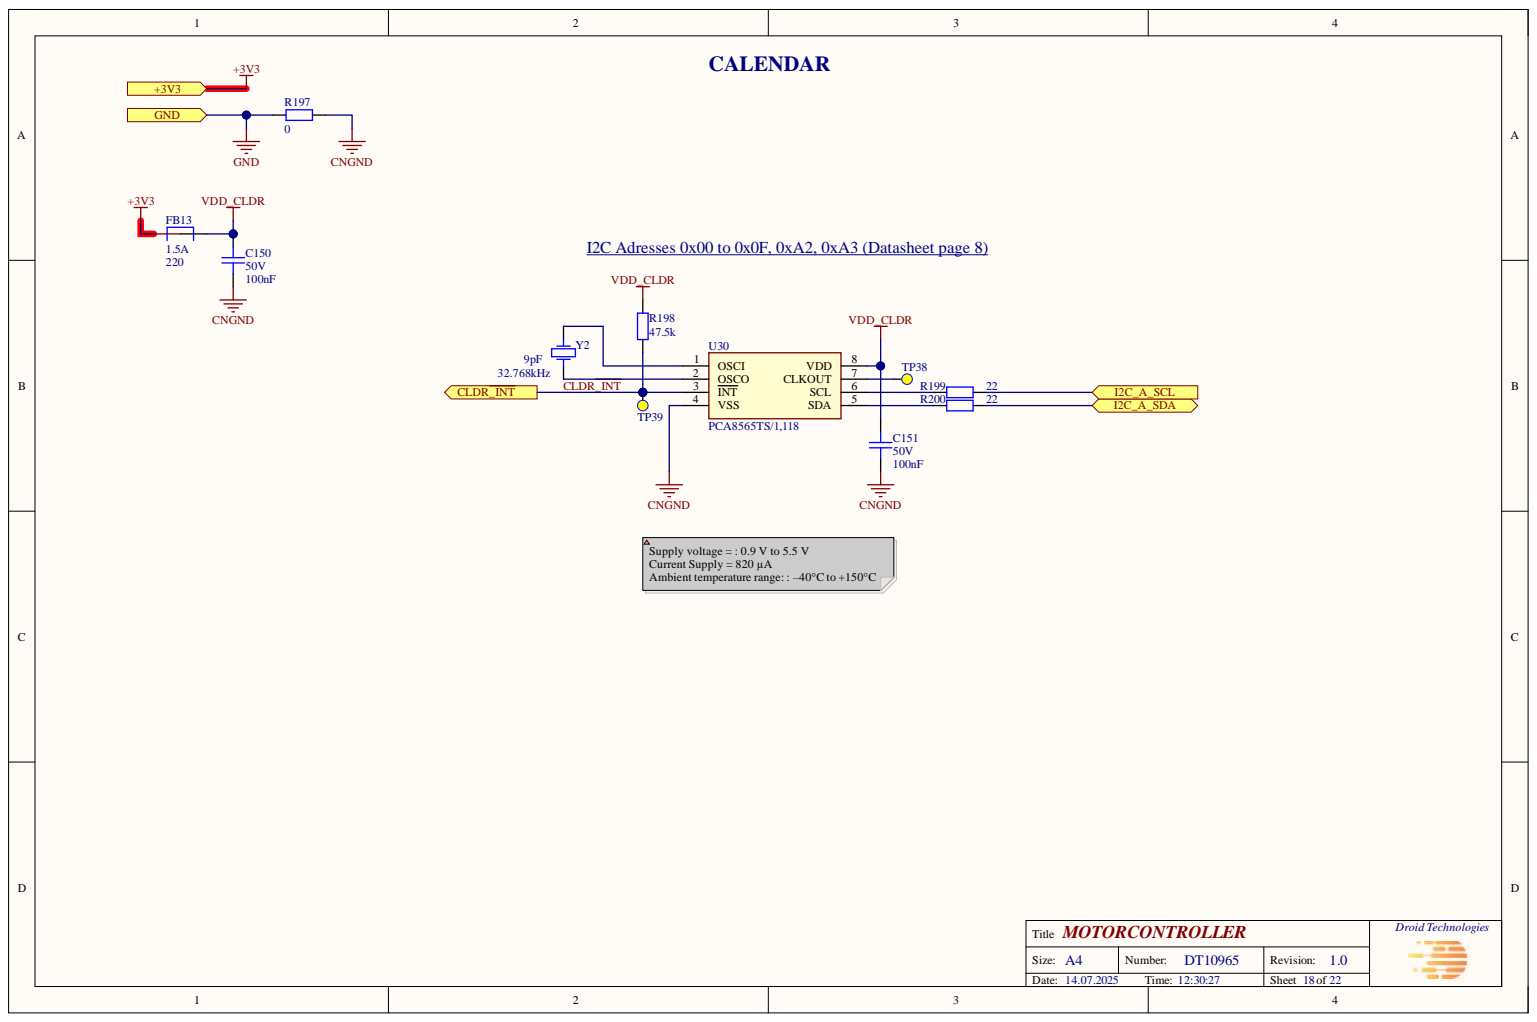
[picture p33: page 15]

I2C Adresses 0x00 to 0x0F, 0xA2, 0xA3 (Datasheet page 8) (https://www.nxp.com/docs/en/data-sheet/PCA8565.pdf)

Supply voltage = : 0.9 V to 5.5 V
Current Supply = 820 µA
Ambient temperature range: : –40°C to +150°C

MOTORCONTROLLER Title | Droid Technologies

Size: A4 | Number: DT10965 | Revision: 1.0

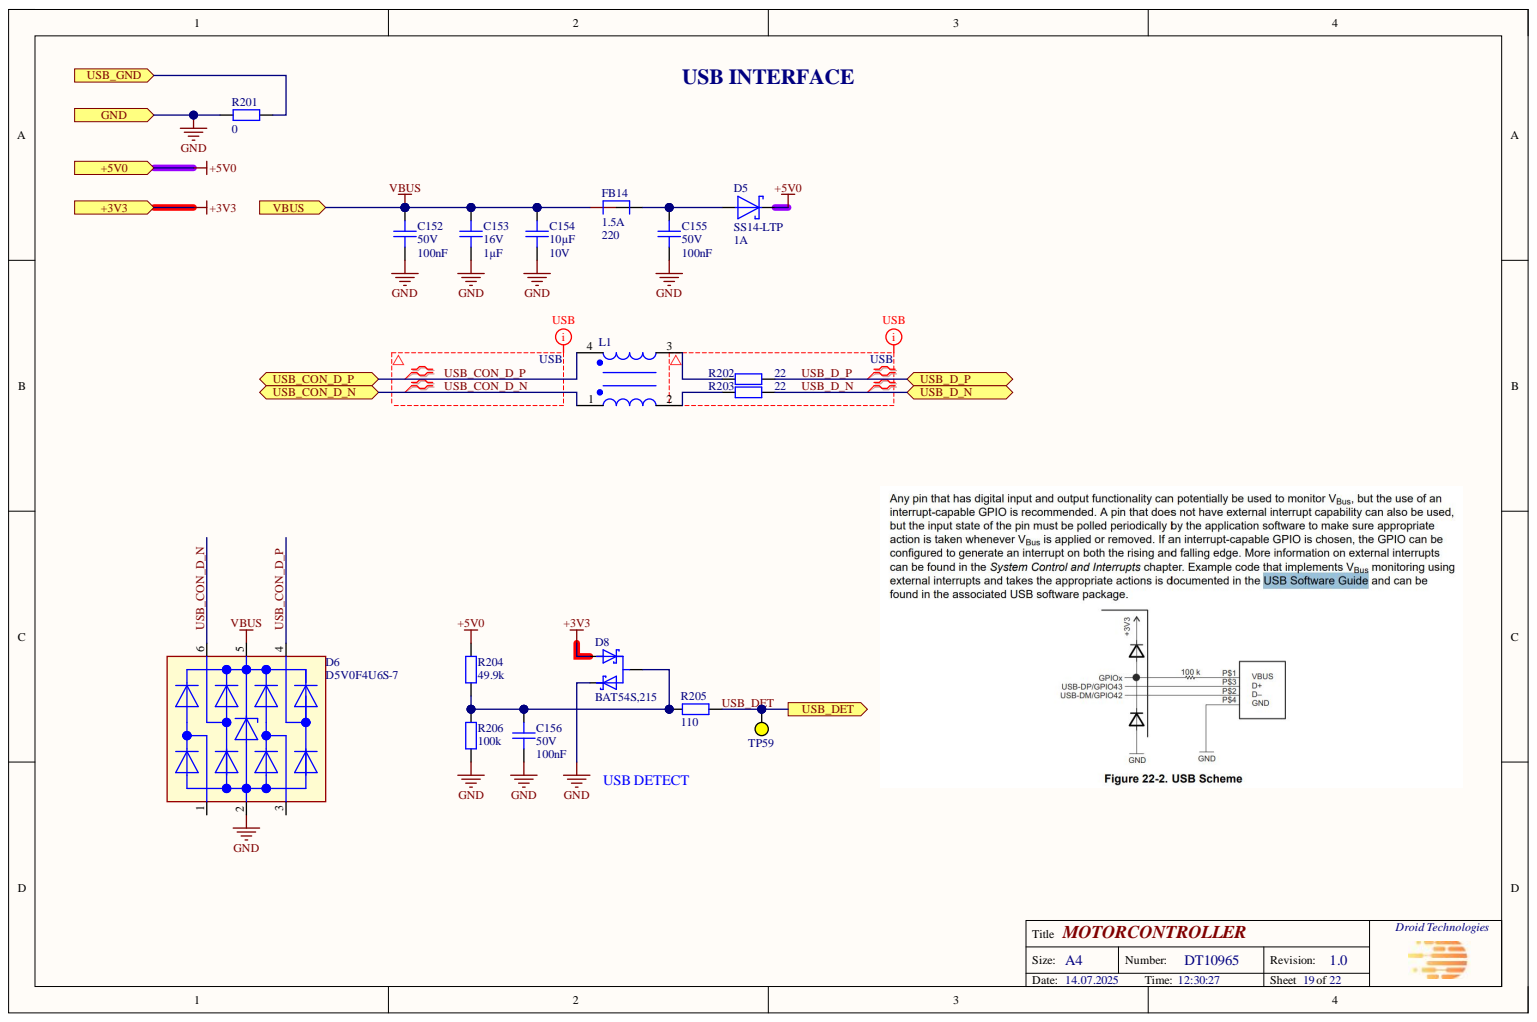
[picture p34: page 16]

MOTORCONTROLLER Title | Droid Technologies

Size: A4 | Number: DT10965 | Revision: 1.0

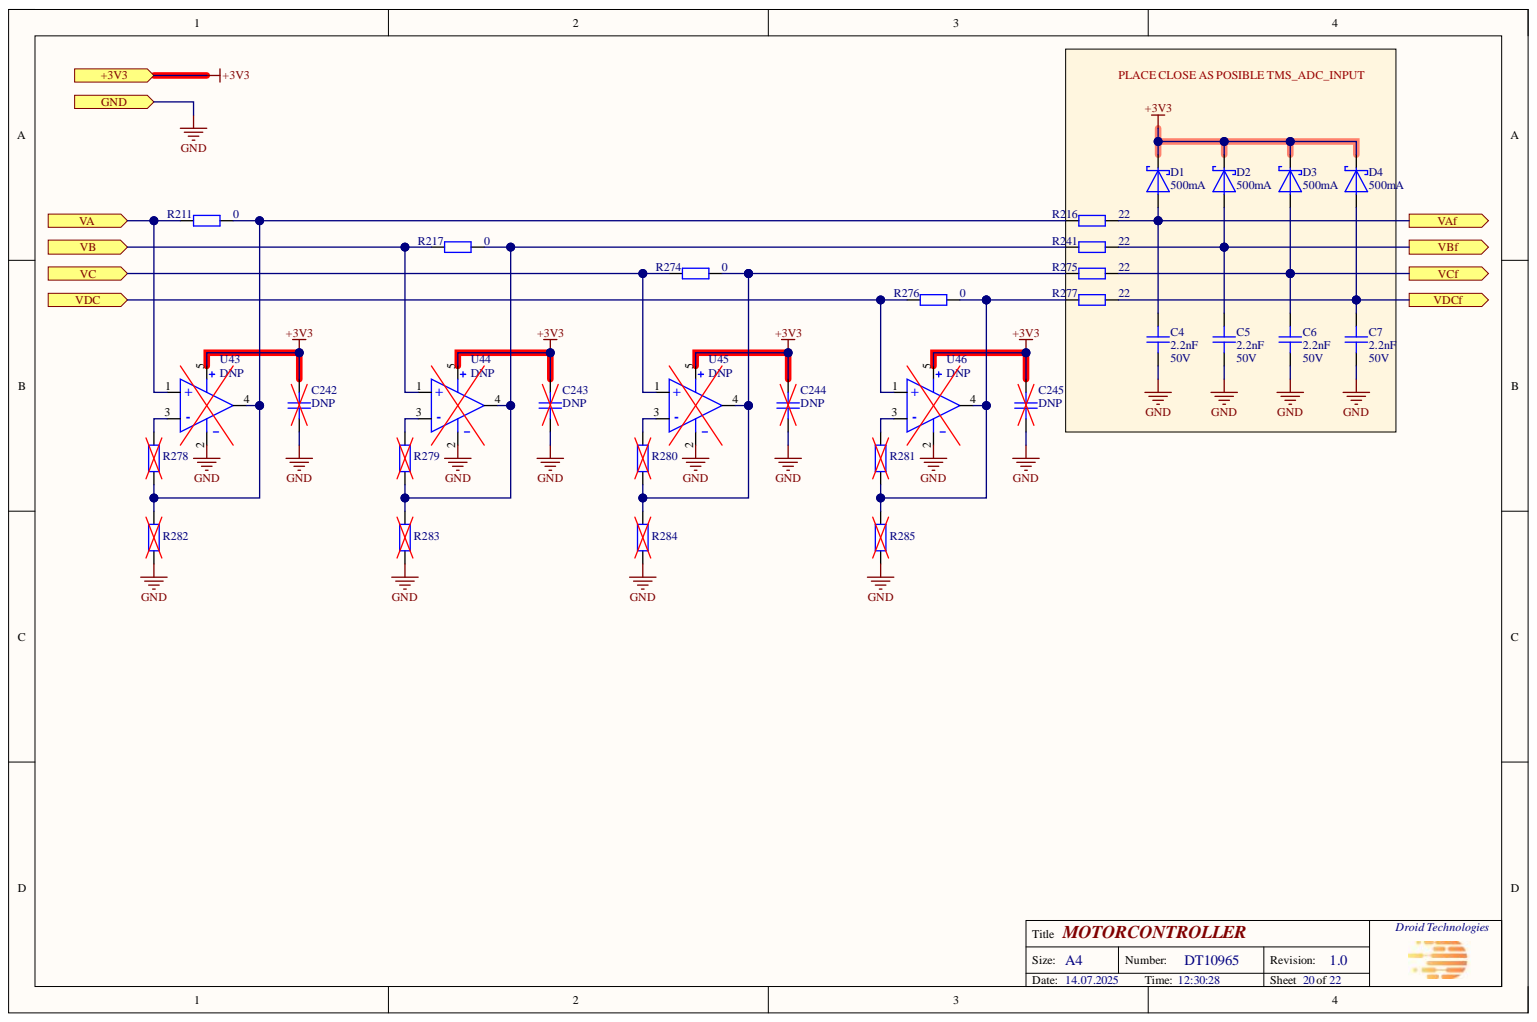
[picture p35: page 17]
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

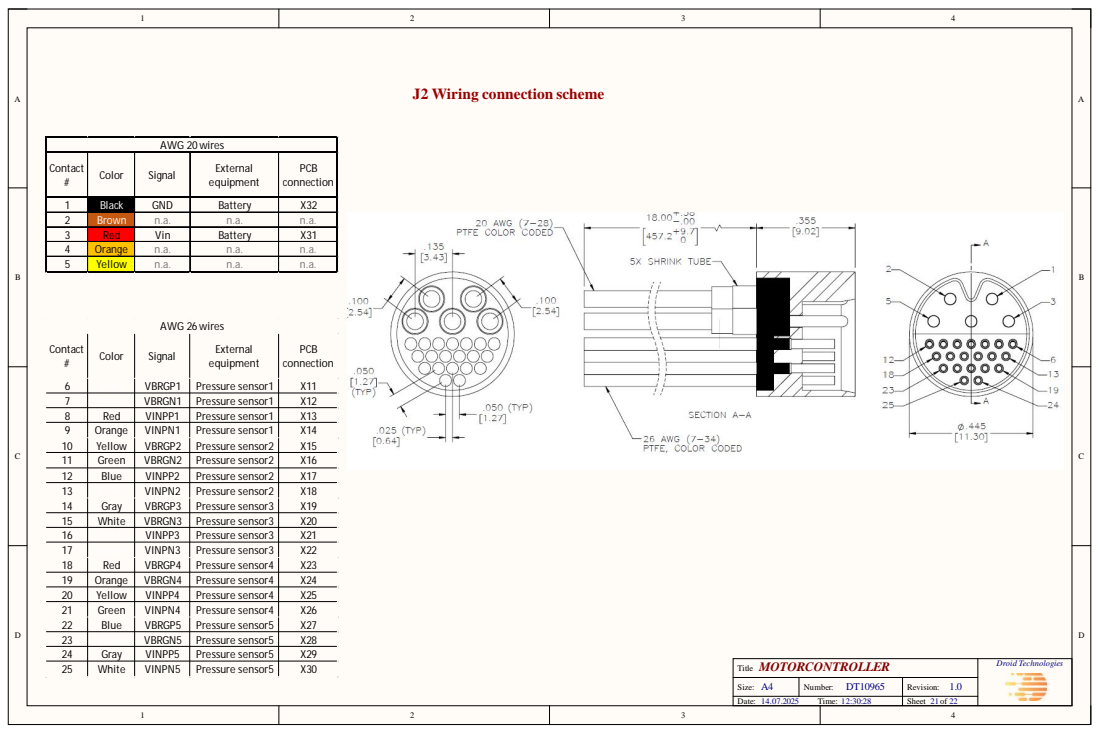
[picture p36: page 18]

Contact # | Color | Signal | External equipment | PCB connection

1 | Black | GND | Battery | X32
2 | Brown | n.a. | n.a. | n.a.
3 | Red | Vin | Battery | X31
4 | Orange | n.a. | n.a. | n.a.
5 | Yellow | n.a. | n.a. | n.a.

MOTORCONTROLLER Title | Droid Technologies

Size: A4 | Number: DT10965 | Revision: 1.0

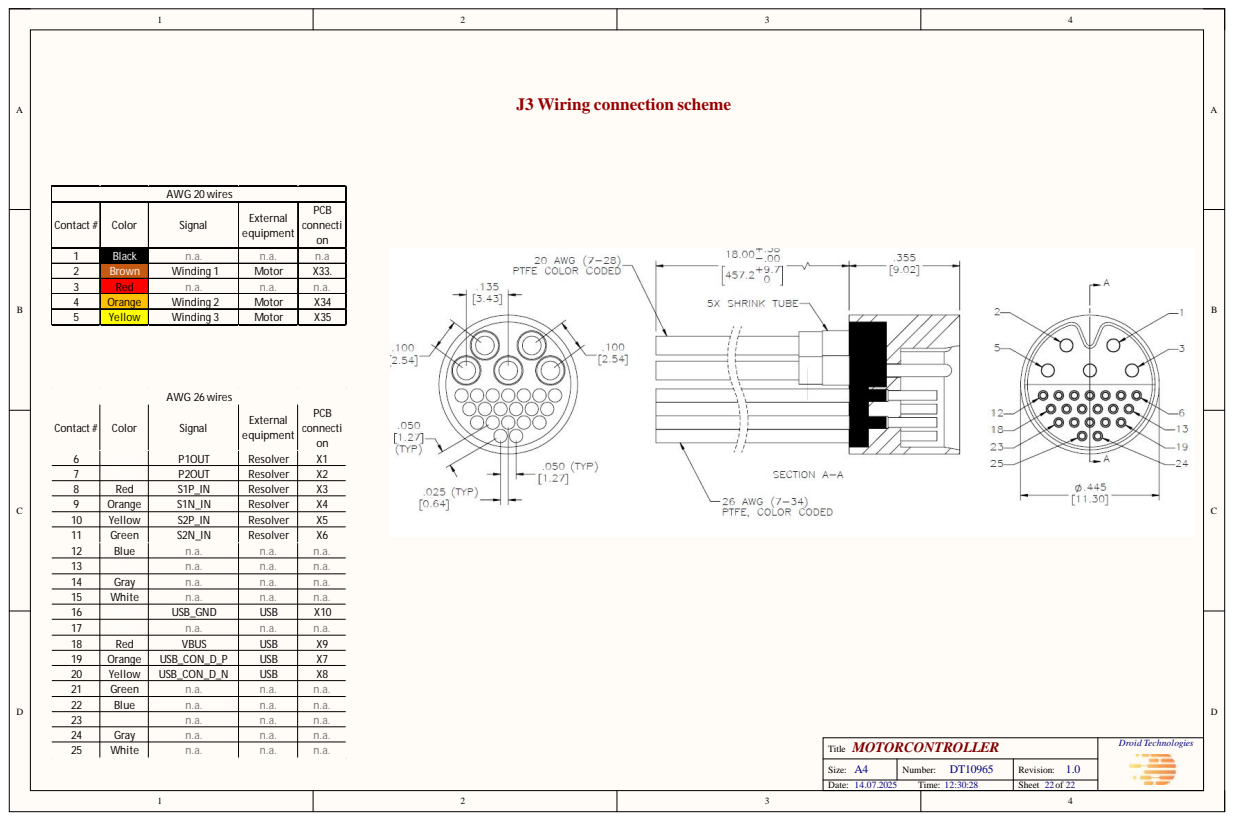
[picture p37: page 19]

Contact # | Color | Signal | External equipment | PCB connecti on

1 | Black | n.a. | n.a. | n.a
2 | Brown | Winding 1 | Motor | X33.
3 | Red | n.a. | n.a. | n.a.
4 | Orange | Winding 2 | Motor | X34
5 | Yellow | Winding 3 | Motor | X35

MOTORCONTROLLER Title | Droid Technologies

Size: A4 | Number: DT10965 | Revision: 1.0

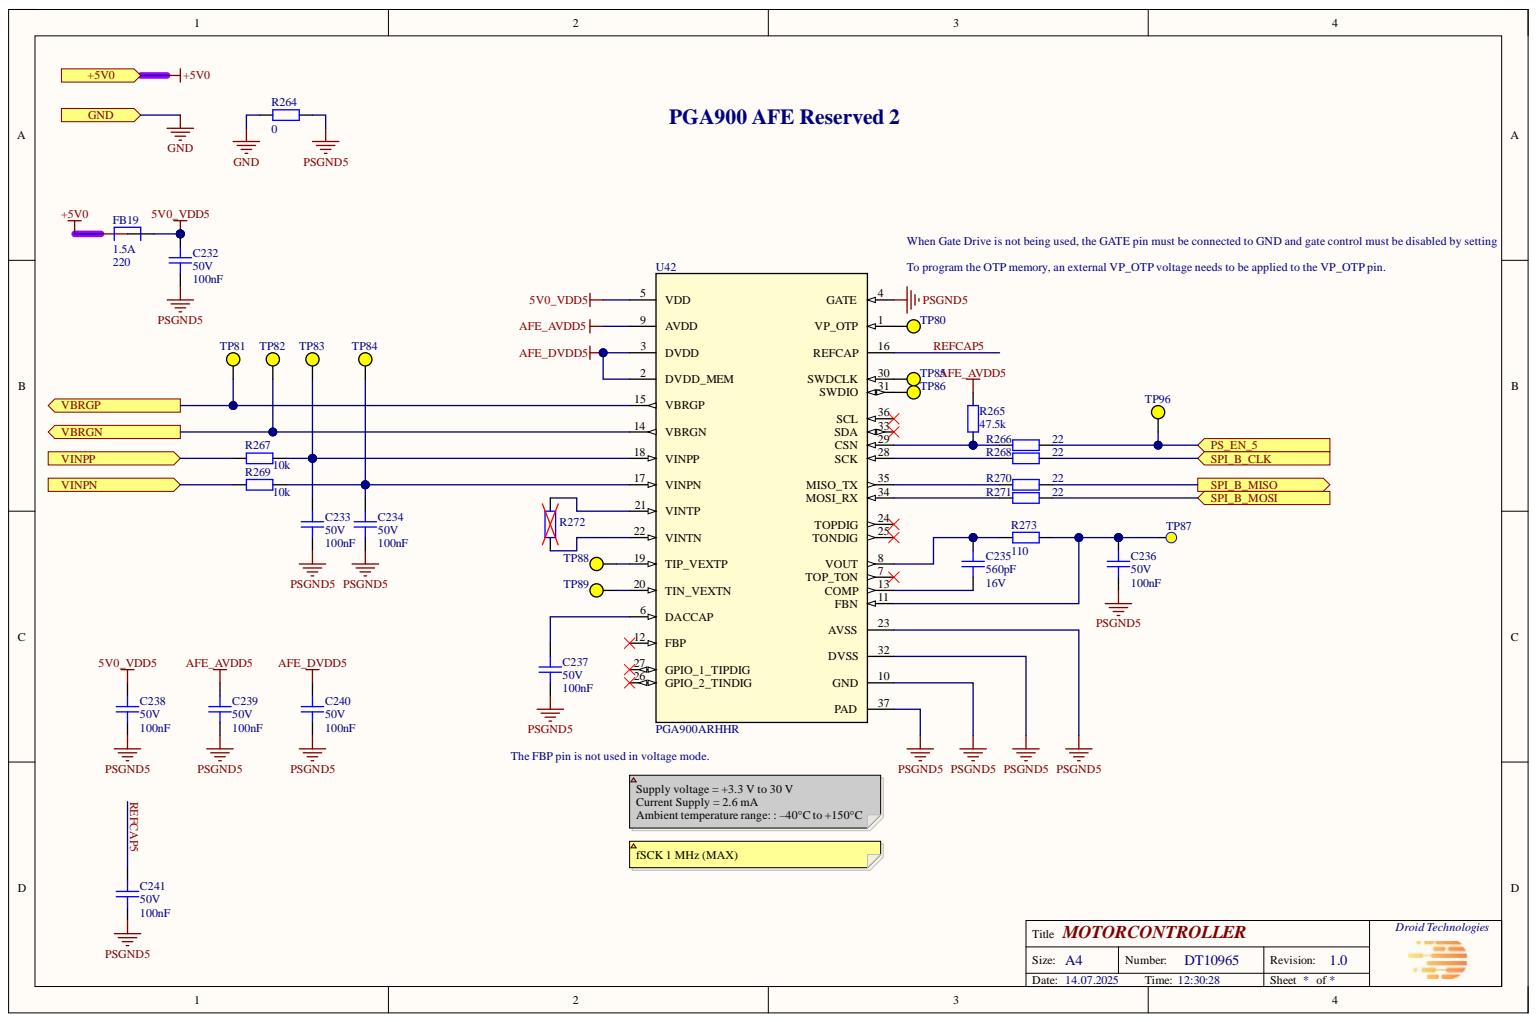
[picture p38: page 20]
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

DVDD 3

VBRGP 15

VBRGN 14

VINPP 18

VINPN 17

VINTP 21

R272 | VINTN 22

The FBP pin is not used in voltage mode.

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

MOTORCONTROLLER Title | Droid Technologies

Size: A4 | Number: DT10965 | Revision: 1.0

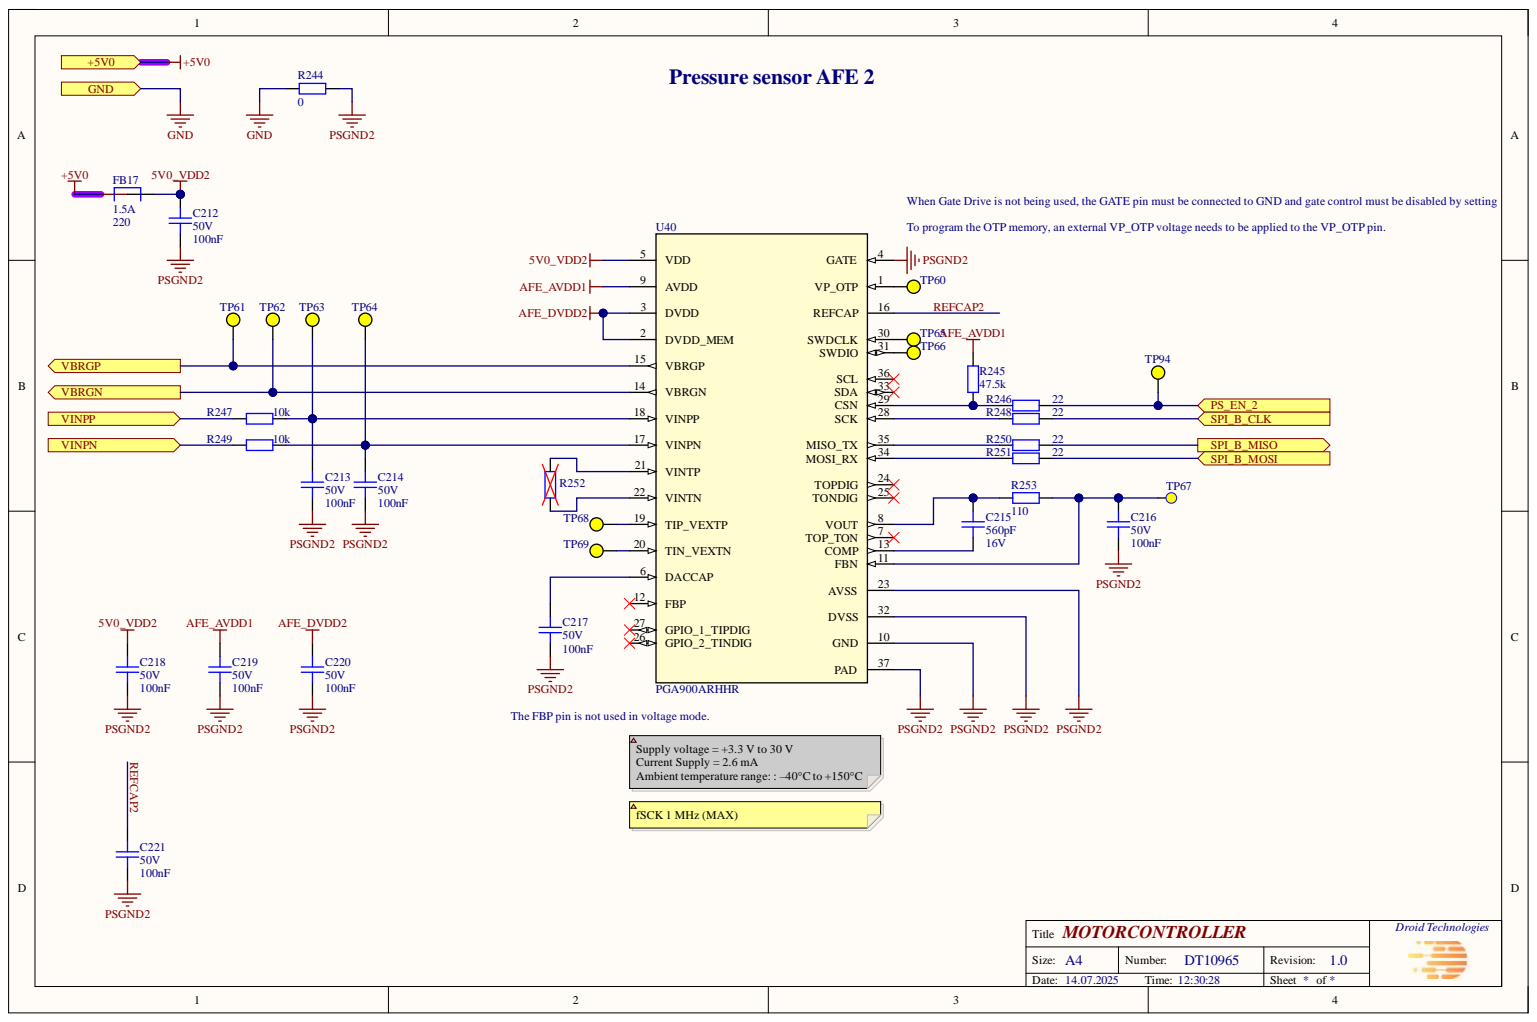
[picture p39: page 21]
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

DVDD_MEM 2

VBRGN 14

VINPP 18

VINPN 17

VINTP 21

R252 | VINTN 22

The FBP pin is not used in voltage mode.

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

MOTORCONTROLLER Title | Droid Technologies

Size: A4 | Number: DT10965 | Revision: 1.0

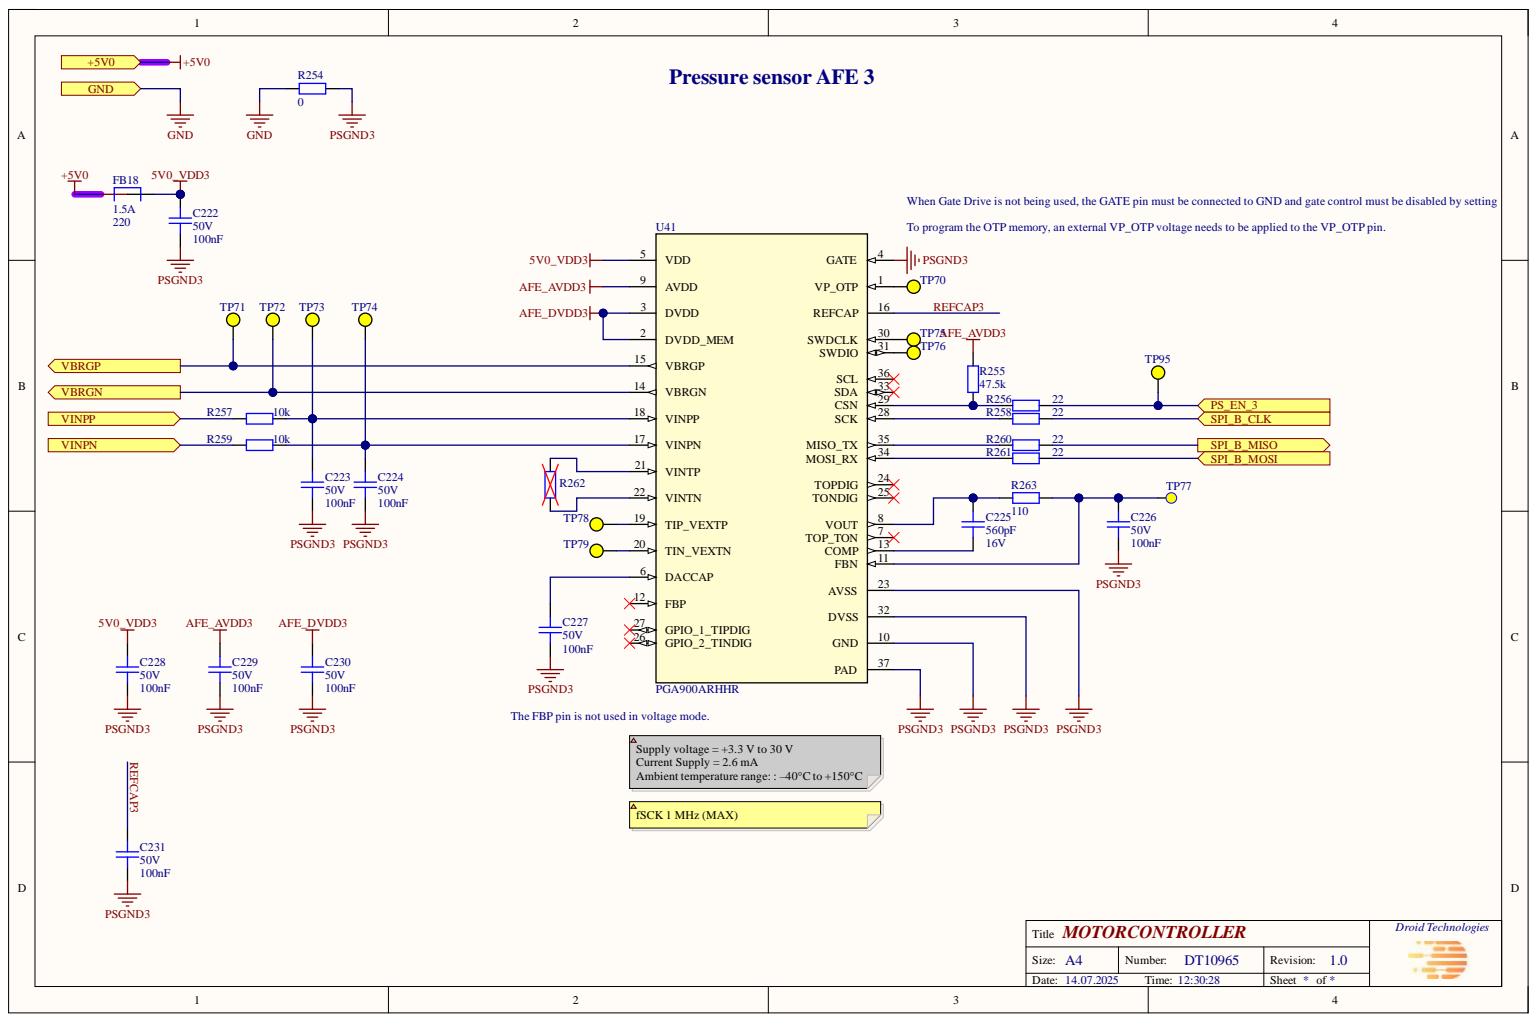
[picture p40: page 22]
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

DVDD_MEM 2

VBRGN 14

VINPP 18

VINPN 17

VINTP 21

R262 | VINTN 22

The FBP pin is not used in voltage mode.

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

MOTORCONTROLLER Title | Droid Technologies

Size: A4 | Number: DT10965 | Revision: 1.0
