eSpark-Backup/ford-creighton-pcb-design-review/(list of files, drawings)

Other design files:
Client-Files/DROID ITEMS FOR REVIEW/Altium V1.0/DT10965_MOTOR_CONTROLLER (09.09.2025 11-41-22)/Accelerometers.SchDoc
Client-Files/DROID ITEMS FOR REVIEW/Altium V1.0/DT10965_MOTOR_CONTROLLER (09.09.2025 11-41-22)/Calendar.SchDoc
Client-Files/DROID ITEMS FOR REVIEW/Altium V1.0/DT10965_MOTOR_CONTROLLER (09.09.2025 11-41-22)/Connection_scheme.SchDoc
Client-Files/DROID ITEMS FOR REVIEW/Altium V1.0/DT10965_MOTOR_CONTROLLER (09.09.2025 11-41-22)/DT10965_MOTOR_CONTROLLER.PrjPcb
Client-Files/DROID ITEMS FOR REVIEW/Altium V1.0/DT10965_MOTOR_CONTROLLER (09.09.2025 11-41-22)/DT10965_MOTOR_CONTROLLER.SCHLIB
Client-Files/DROID ITEMS FOR REVIEW/Altium V1.0/DT10965_MOTOR_CONTROLLER (09.09.2025 11-41-22)/DT10966_MOTOR_CONTROLLER.PcbDoc
Client-Files/DROID ITEMS FOR REVIEW/Altium V1.0/DT10965_MOTOR_CONTROLLER (09.09.2025 11-41-22)/DT10966_MOTOR_CONTROLLER.PcbLib
Client-Files/DROID ITEMS FOR REVIEW/Altium V1.0/DT10965_MOTOR_CONTROLLER (09.09.2025 11-41-22)/EEPROM_memory.SchDoc
Client-Files/DROID ITEMS FOR REVIEW/Altium V1.0/DT10965_MOTOR_CONTROLLER (09.09.2025 11-41-22)/Flash_memory.SchDoc
Client-Files/DROID ITEMS FOR REVIEW/Altium V1.0/DT10965_MOTOR_CONTROLLER (09.09.2025 11-41-22)/H-bridge.SchDoc
Client-Files/DROID ITEMS FOR REVIEW/Altium V1.0/DT10965_MOTOR_CONTROLLER (09.09.2025 11-41-22)/MCU.SchDoc
Client-Files/DROID ITEMS FOR REVIEW/Altium V1.0/DT10965_MOTOR_CONTROLLER (09.09.2025 11-41-22)/MCU_debug.SchDoc
Client-Files/DROID ITEMS FOR REVIEW/Altium V1.0/DT10965_MOTOR_CONTROLLER (09.09.2025 11-41-22)/Motor Voltage AMP.SchDoc
Client-Files/DROID ITEMS FOR REVIEW/Altium V1.0/DT10965_MOTOR_CONTROLLER (09.09.2025 11-41-22)/PGA900_AFE_Reserved_4.SchDoc
Client-Files/DROID ITEMS FOR REVIEW/Altium V1.0/DT10965_MOTOR_CONTROLLER (09.09.2025 11-41-22)/PGA900_AFE_Reserved_5.SchDoc
Client-Files/DROID ITEMS FOR REVIEW/Altium V1.0/DT10965_MOTOR_CONTROLLER (09.09.2025 11-41-22)/Phase_Current_Voltage_Sense.SchDoc
Client-Files/DROID ITEMS FOR REVIEW/Altium V1.0/DT10965_MOTOR_CONTROLLER (09.09.2025 11-41-22)/Power_management.SchDoc
Client-Files/DROID ITEMS FOR REVIEW/Altium V1.0/DT10965_MOTOR_CONTROLLER (09.09.2025 11-41-22)/Pressure_sensor_AFE1.SchDoc
Client-Files/DROID ITEMS FOR REVIEW/Altium V1.0/DT10965_MOTOR_CONTROLLER (09.09.2025 11-41-22)/Pressure_sensor_AFE2.SchDoc
Client-Files/DROID ITEMS FOR REVIEW/Altium V1.0/DT10965_MOTOR_CONTROLLER (09.09.2025 11-41-22)/Pressure_sensor_AFE3.SchDoc
Client-Files/DROID ITEMS FOR REVIEW/Altium V1.0/DT10965_MOTOR_CONTROLLER (09.09.2025 11-41-22)/Resolver.SchDoc
Client-Files/DROID ITEMS FOR REVIEW/Altium V1.0/DT10965_MOTOR_CONTROLLER (09.09.2025 11-41-22)/Temp_sensor.SchDoc
Client-Files/DROID ITEMS FOR REVIEW/Altium V1.0/DT10965_MOTOR_CONTROLLER (09.09.2025 11-41-22)/Title.SchDoc
Client-Files/DROID ITEMS FOR REVIEW/Altium V1.0/DT10965_MOTOR_CONTROLLER (09.09.2025 11-41-22)/USB_interface.SchDoc
Client-Files/DROID ITEMS FOR REVIEW/Altium V1.0/DT10965_MOTOR_CONTROLLER (09.09.2025 11-41-22)/Wiring_connection_scheme_J2.SchDoc
Client-Files/DROID ITEMS FOR REVIEW/Altium V1.0/DT10965_MOTOR_CONTROLLER (09.09.2025 11-41-22)/Wiring_connection_scheme_J3.SchDoc
Client-Files/DROID ITEMS FOR REVIEW/BackUp/Altium/DT10965_MOTOR_CONTROLLER/Accelerometers.SchDoc
Client-Files/DROID ITEMS FOR REVIEW/BackUp/Altium/DT10965_MOTOR_CONTROLLER/Block_Diagram.SchDoc
Client-Files/DROID ITEMS FOR REVIEW/BackUp/Altium/DT10965_MOTOR_CONTROLLER/Calendar.SchDoc
Client-Files/DROID ITEMS FOR REVIEW/BackUp/Altium/DT10965_MOTOR_CONTROLLER/Current_sensor.SchDoc
Client-Files/DROID ITEMS FOR REVIEW/BackUp/Altium/DT10965_MOTOR_CONTROLLER/DT10965_MOTOR_CONTROLLER.PrjPcb
Client-Files/DROID ITEMS FOR REVIEW/BackUp/Altium/DT10965_MOTOR_CONTROLLER/EEPROM_memory.SchDoc
Client-Files/DROID ITEMS FOR REVIEW/BackUp/Altium/DT10965_MOTOR_CONTROLLER/Flash_memory.SchDoc
Client-Files/DROID ITEMS FOR REVIEW/BackUp/Altium/DT10965_MOTOR_CONTROLLER/H-bridge.SchDoc
Client-Files/DROID ITEMS FOR REVIEW/BackUp/Altium/DT10965_MOTOR_CONTROLLER/MCU.SchDoc
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
